Aryan-swag/VentSense/sim/out/summary.md

# VentSense digital twin: results

Generated by `sim/run_all.py`. The **real firmware safety core** (`firmware/lib/safety_core`) runs in the loop;
the plant, sensors and fault profiles are models with ASSUMED values (`sim/params.py`).
These results show the firmware logic and timing behave as designed against modelled faults.
They do not prove detection on real cells. Thresholds are placeholders to be tuned on the rig.

## Scenario checks: 35 / 35 passed

| Scenario | Check | Result | Detail |
|---|---|---|---|
| normal | no Level 2 trip | PASS | trips: {} |
| normal | no Level 3 trip | PASS |  |
| normal | stays at Level 0 | PASS | max level 0 |
| incense_room | no Level 2 trip | PASS | trips: {} |
| incense_room | no Level 3 trip | PASS |  |
| incense_room | ambient-gas alert raised | PASS | alerts [1] |
| cell3_runaway | cell 3 isolated (Level 2) | PASS | trips {2: 443.20001220703125} |
| cell3_runaway | only cell 3 isolated | PASS |  |
| cell3_runaway | no Level 3 | PASS |  |
| cell3_runaway | pack keeps powering the load on 3 cells | PASS | final current 1.15 A |
| cell3_runaway | isolation < 1 s after the 2nd signal | PASS | latency 0.60 s |
| two_cell | cells 2 and 3 isolated | PASS | trips {1: 442.3999938964844, 2: 471.70001220703125} |
| two_cell | Level 3: pack relay opened | PASS | L3 at [471.70001220703125] |
| two_cell | pack current 0 after Level 3 | PASS |  |
| sensor_unplug | no Level 2 trip | PASS | trips: {} |
| sensor_unplug | no Level 3 trip | PASS |  |
| sensor_unplug | sensor-fault alert raised | PASS |  |
| sensor_unplug | max Level 1 | PASS | max level 1 |
| heater_only | no Level 2 trip | PASS | trips: {} |
| heater_only | no Level 3 trip | PASS |  |
| heater_only | firmware heater cutoff at 55 C engaged | PASS |  |
| heater_only | dummy cell stays below 60 C (25R limit) | PASS | peak dummy 56.4 C |
| heater_only | KSD301 backup holds the block near 70 C | PASS | peak block 70.0 C, KSD301 opened 1 times (block runs hotter than the dummy: ASSUMED coupling) |
| rig_vote | dummy segment 1 trips Level 2 (H2 + temperature) | PASS | trips {0: 357.29998779296875} |
| rig_vote | real cells untouched | PASS |  |
| rig_vote | heater off after the trip | PASS |  |
| ir_health | no Level 2 trip | PASS | trips: {} |
| ir_health | no Level 3 trip | PASS |  |
| ir_health | commissioning test: every cell within 10 % of the model | PASS | worst error 2.0 % |
| ir_health | after ageing: every cell within 10 % of the model | PASS | worst error 1.1 % |
| ir_health | aged cell 2 measured about 1.8x its baseline | PASS | ratio 1.77 |
| ir_health | health indicator flags cell 2 only | PASS | scores 98, 61, 98, 97 |
| late_second | no Level 2 trip | PASS | trips: {} |
| late_second | no Level 3 trip | PASS |  |
| late_second | reached Level 1 only | PASS | max level 1 |

Plots: `out/<scenario>.png`.

## Monte Carlo (40 runs each, random sensor offsets, baselines, noise, cell spread)

| Metric | Result |
|---|---|
| Normal operation: runs with a false Level 2 trip | 0 / 40 |
| Normal operation: runs with any Level 1 alert | 0 / 40 |
| Failing cell (random cell, ramp 120-600 s, severity 0.7-1.3): detected and isolated | 40 / 40 |
| Wrong cell isolated | 0 / 40 |
| Detection time from fault onset: median / 95th percentile | 167 s / 264 s |
| Isolation latency after the 2nd signal: max | 0.60 s (target < 1 s) |

Detection time depends entirely on the ASSUMED fault profile; quote it only as a model result.

Run time: 89 s.
