Aryan-swag/VentSense/exports/screenshots/Screenshot from 2026-10-25 03-03-59.png

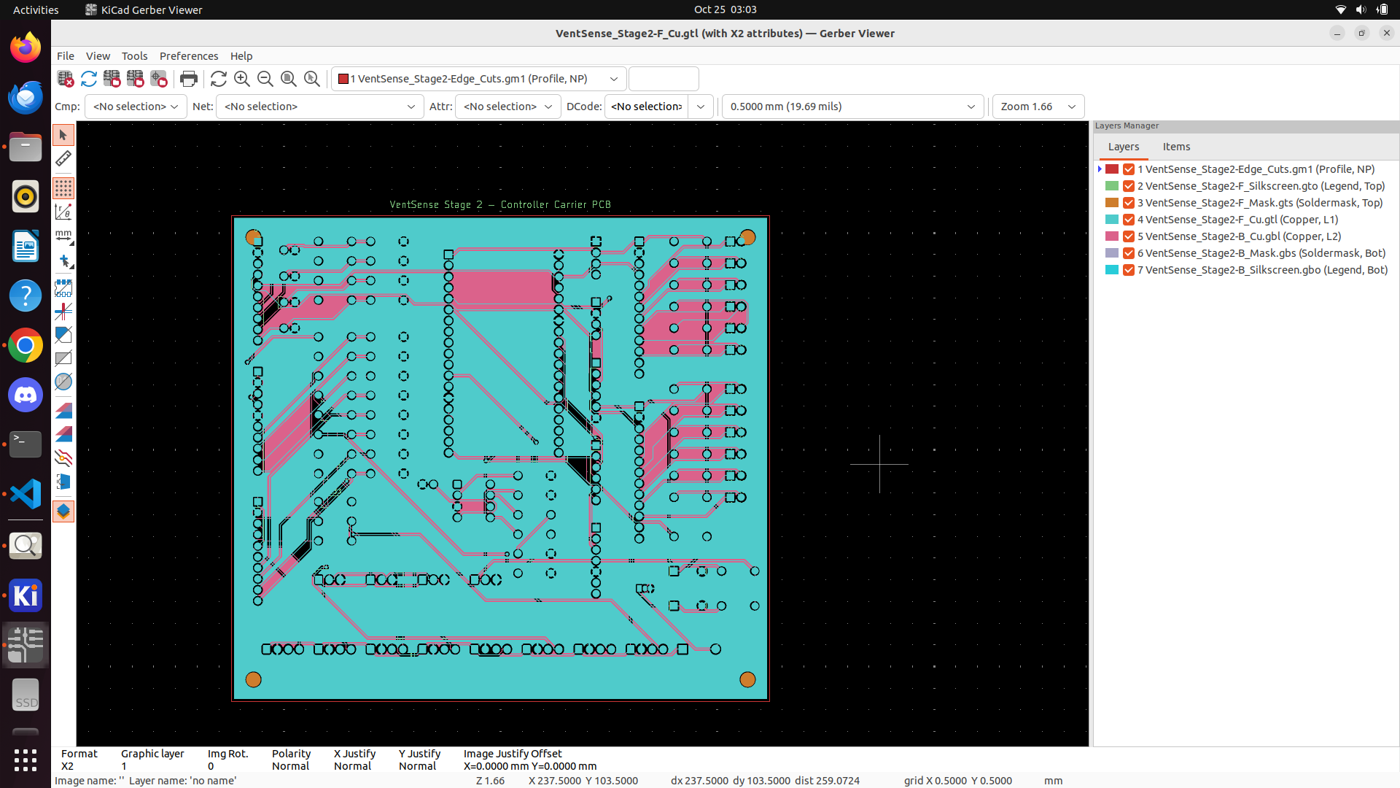
exports/screenshots/Screenshot from 2026-10-25 03-03-59.png
