Aryan-swag/VentSense/exports/screenshots/Screenshot from 2026-10-25 10-33-32.png

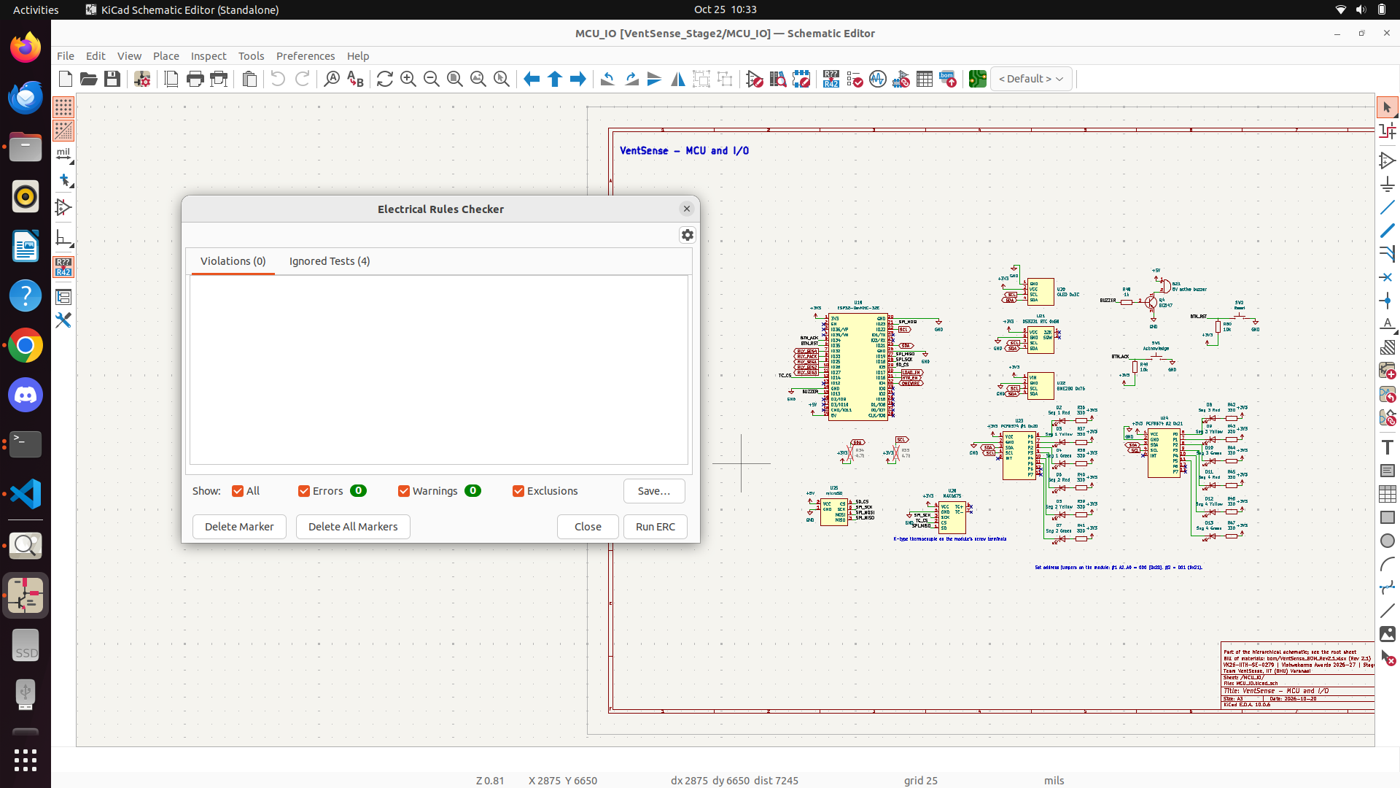
exports/screenshots/Screenshot from 2026-10-25 10-33-32.png
