Aryan-swag/VentSense/exports/screenshots/Screenshot from 2026-10-25 11-01-54.png

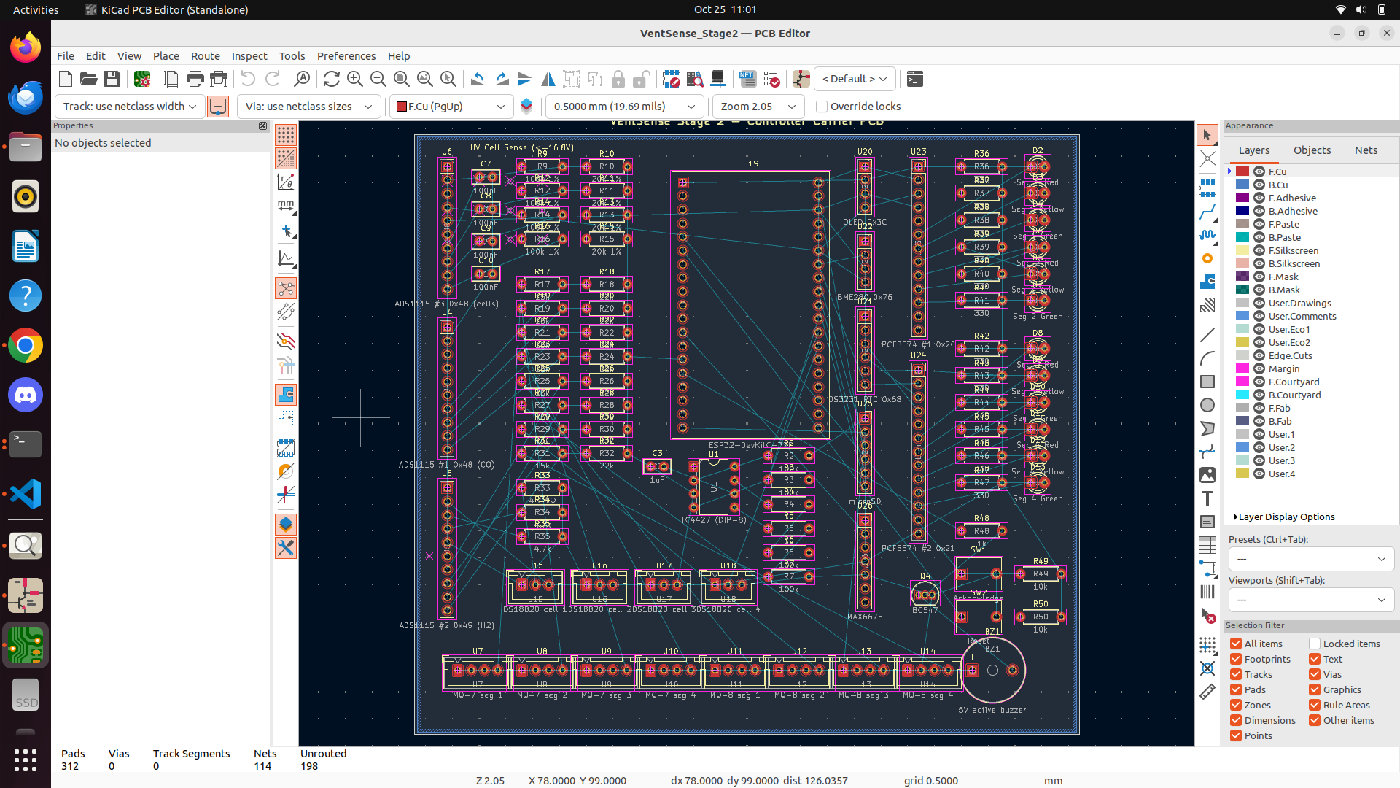
exports/screenshots/Screenshot from 2026-10-25 11-01-54.png
