Aryan-swag/VentSense/exports/screenshots/Screenshot from 2026-10-25 11-02-47.png

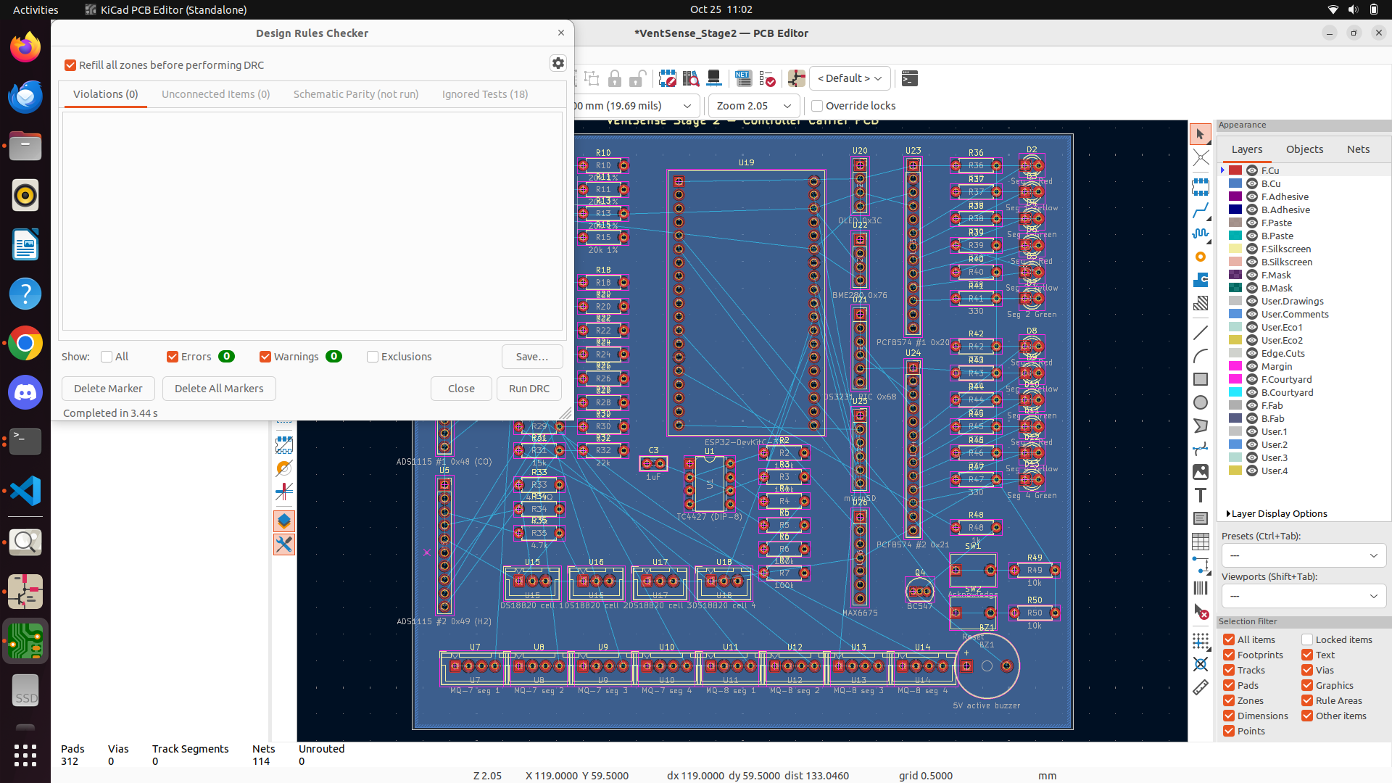
exports/screenshots/Screenshot from 2026-10-25 11-02-47.png
