Aryan-swag/VentSense/exports/screenshots/Screenshot from 2026-10-25 11-05-31.png

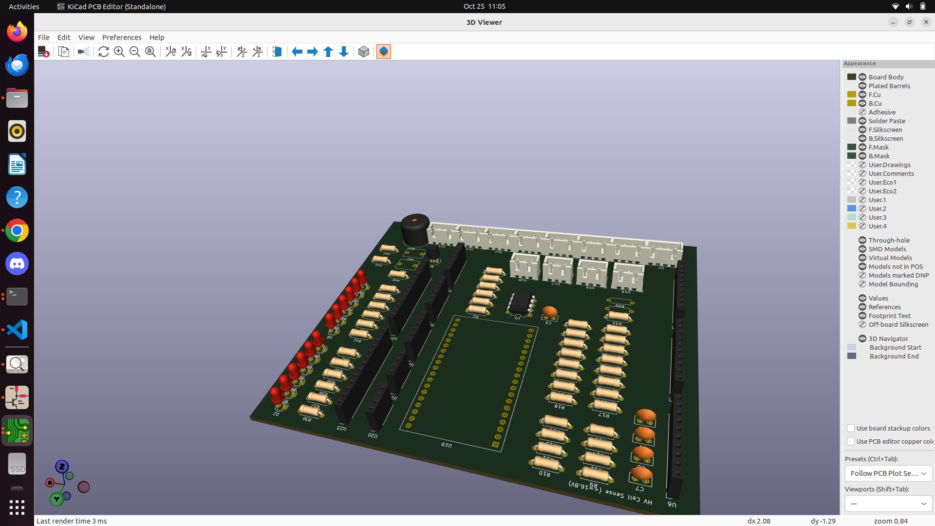
exports/screenshots/Screenshot from 2026-10-25 11-05-31.png
