Aryan-swag/VentSense/exports/VS_sheet-1.png

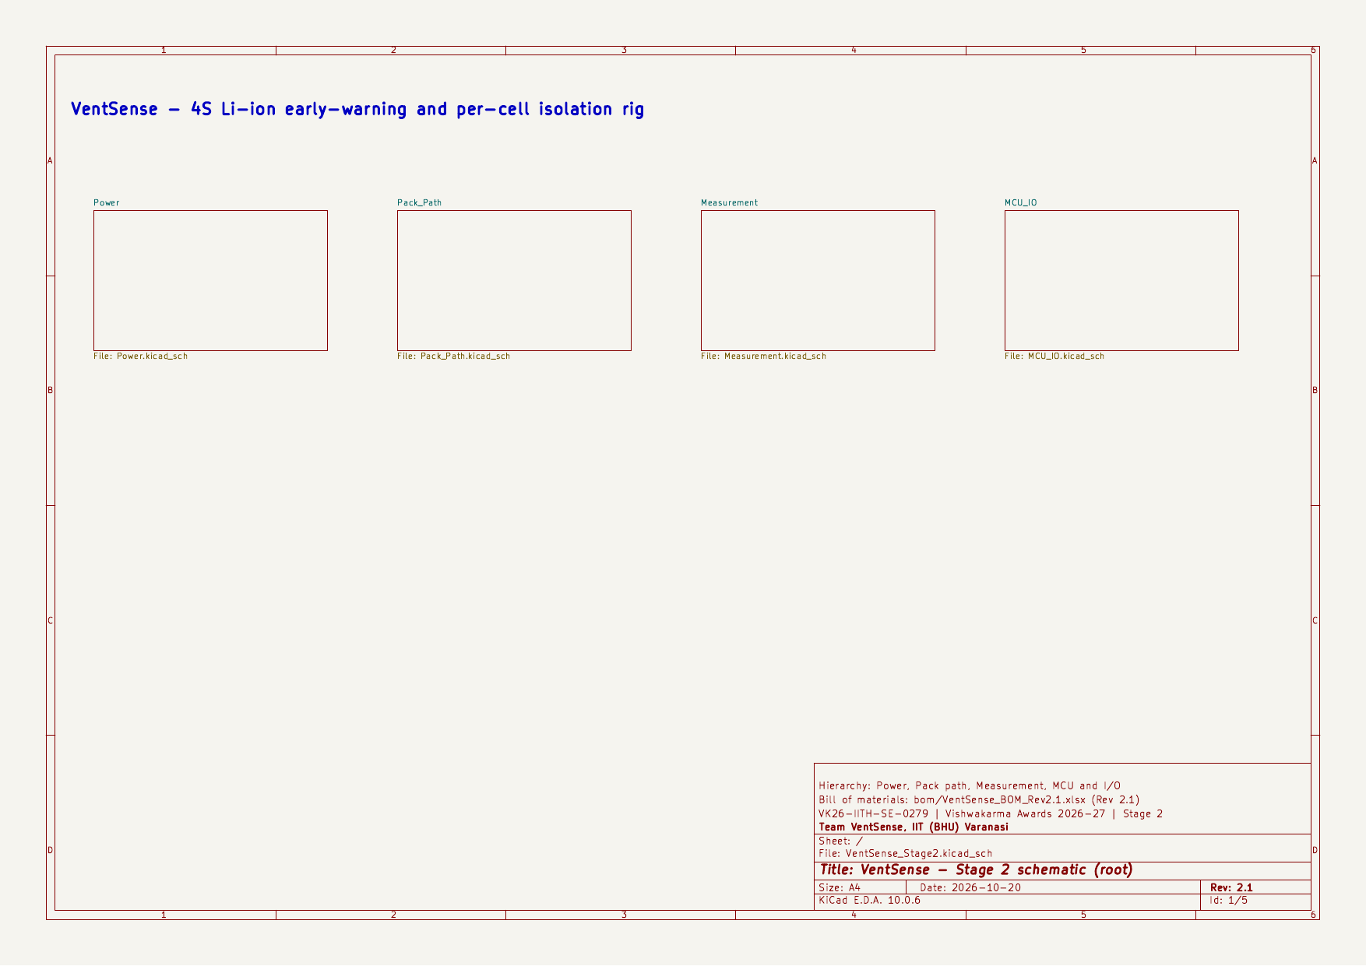
exports/VS_sheet-1.png
