Aryan-swag/VentSense/exports/VS_sheet-2.png

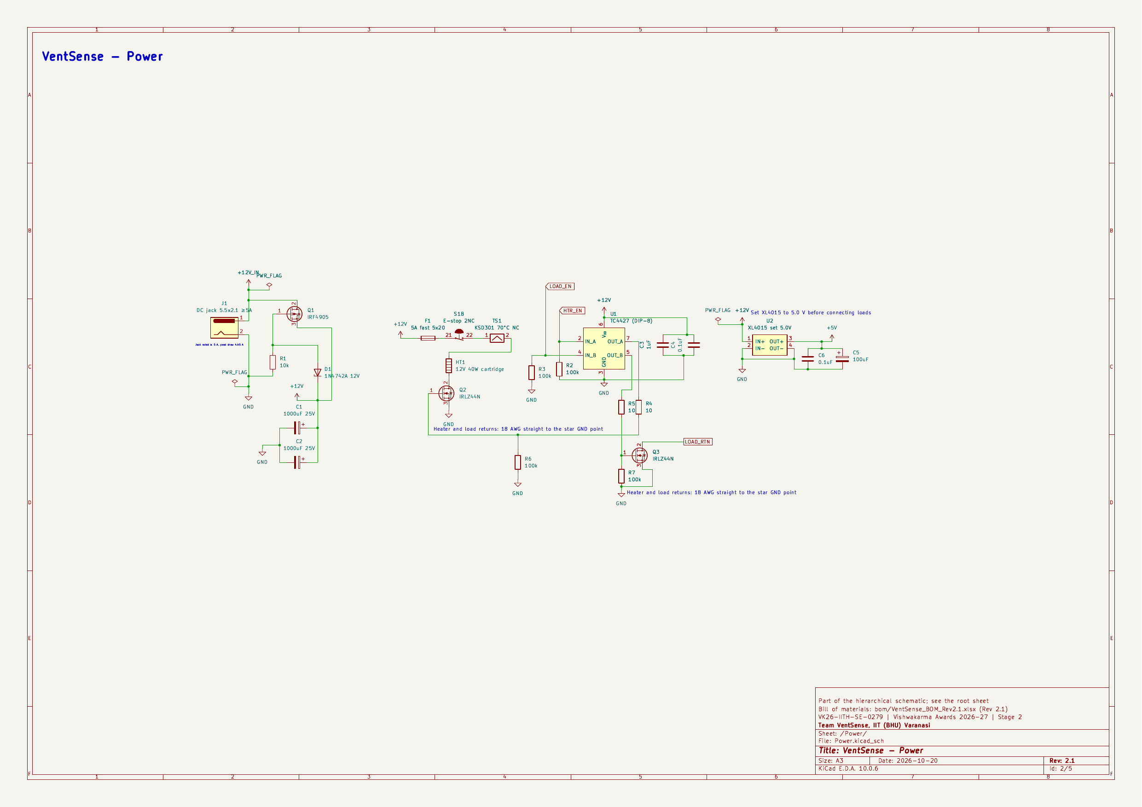
exports/VS_sheet-2.png
