Aryan-swag/VentSense/exports/VS_sheet-3.png

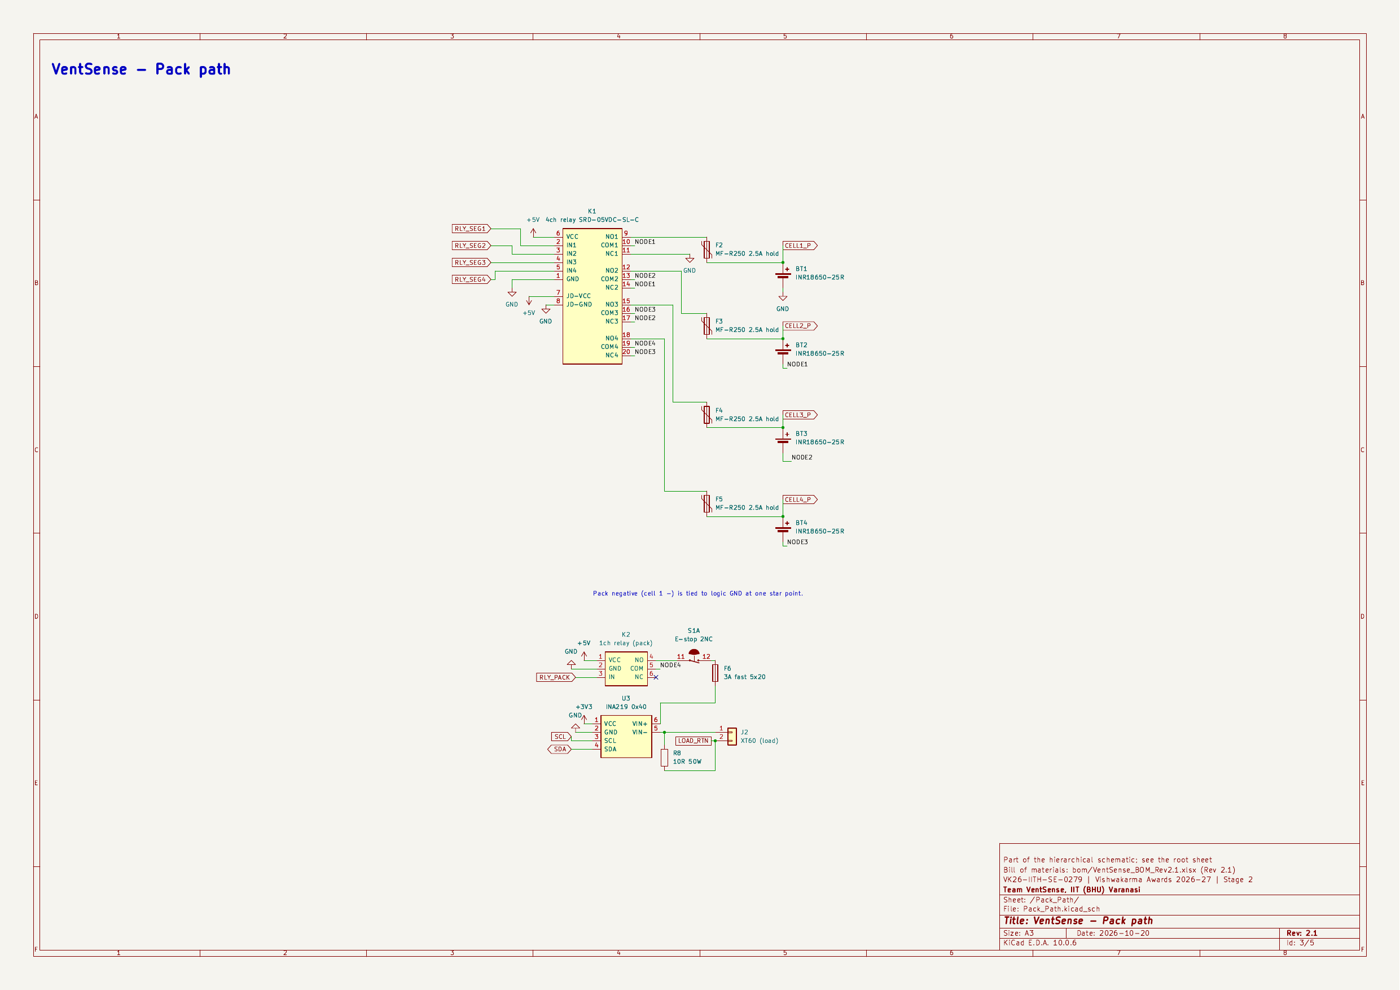
exports/VS_sheet-3.png
