Aryan-swag/VentSense/exports/VS_sheet-4.png

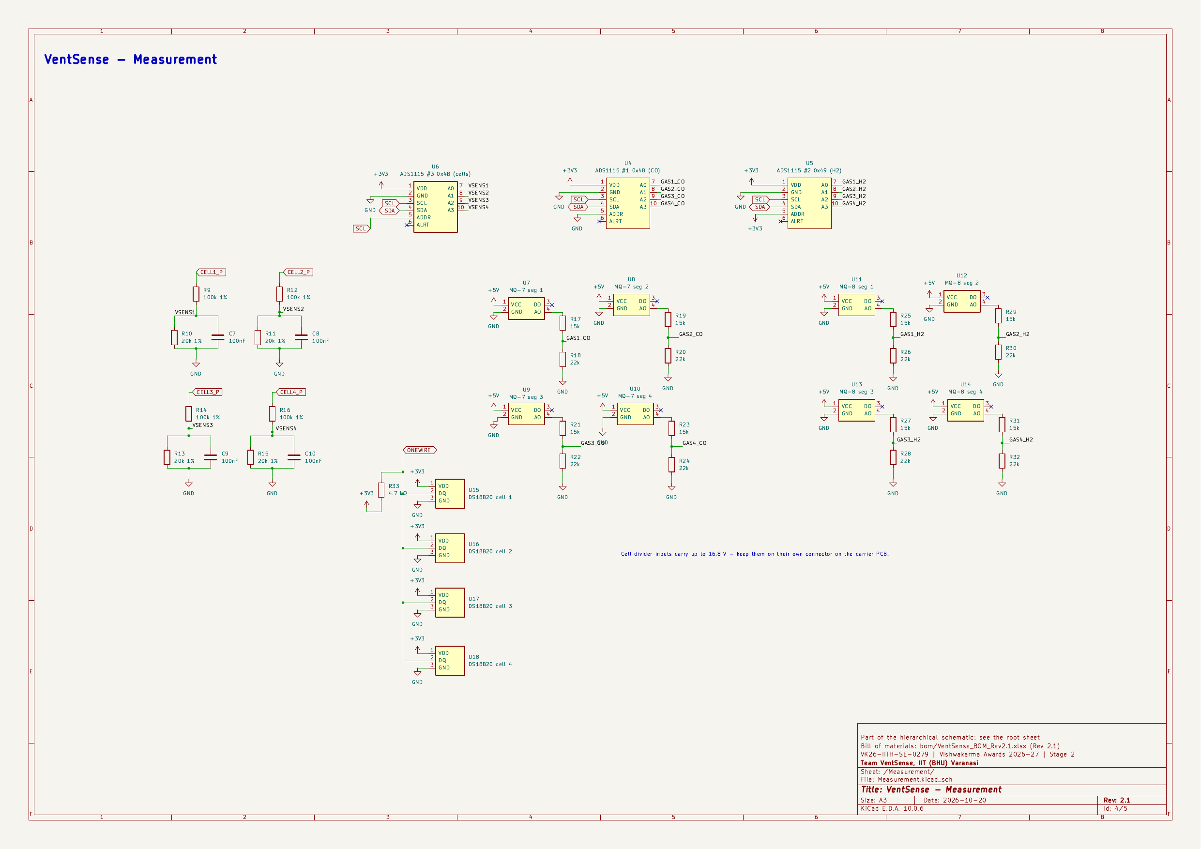
exports/VS_sheet-4.png
