Aryan-swag/VentSense/exports/VS_sheet-5.png

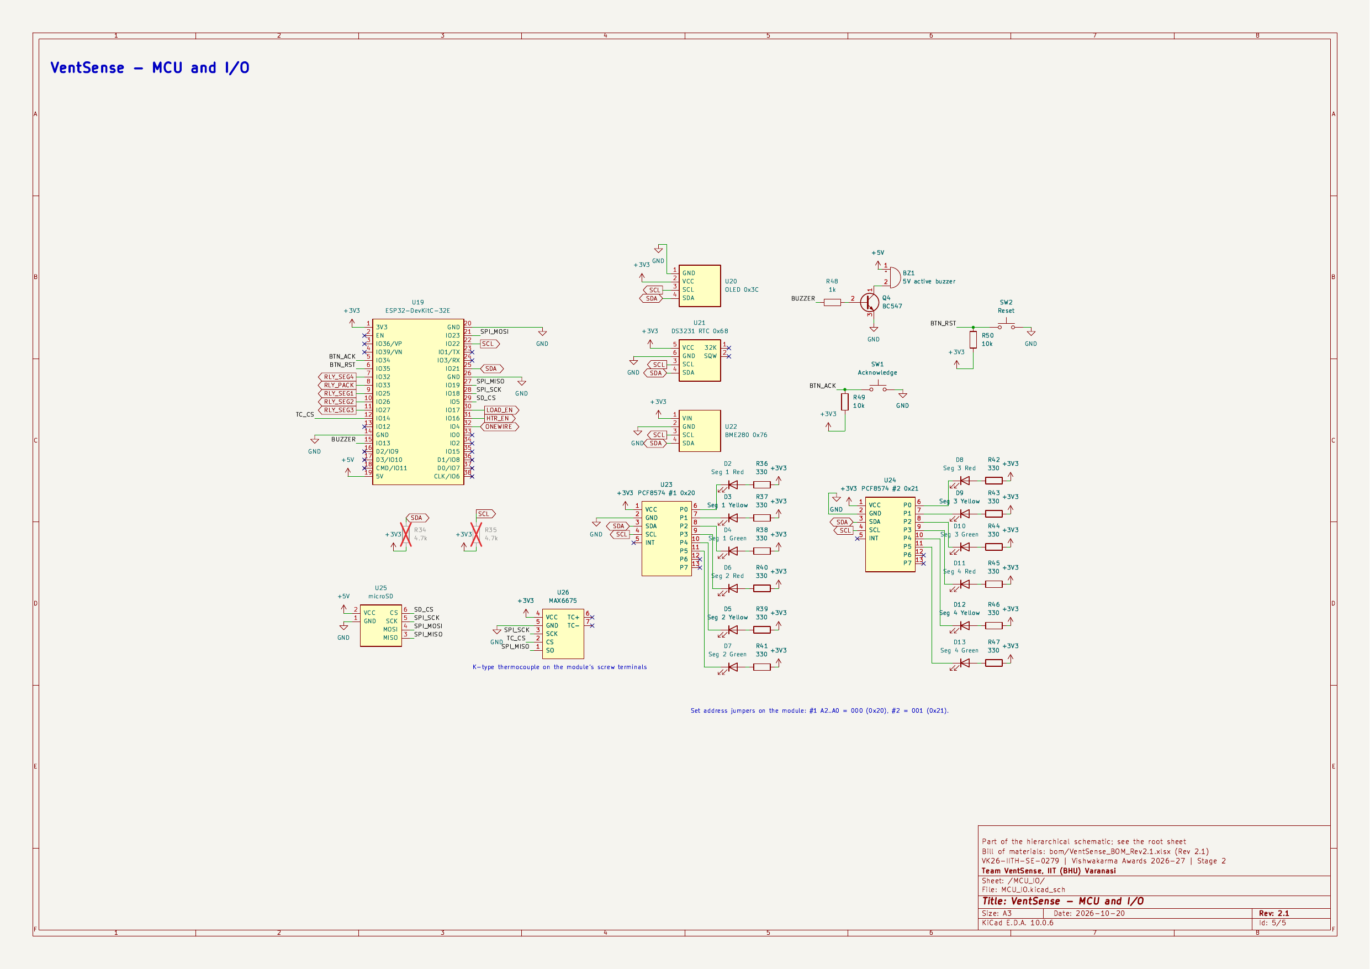
exports/VS_sheet-5.png
