Aryan-swag/VentSense/PCB/renders/VS_Carrier_v1.1_bottom.png

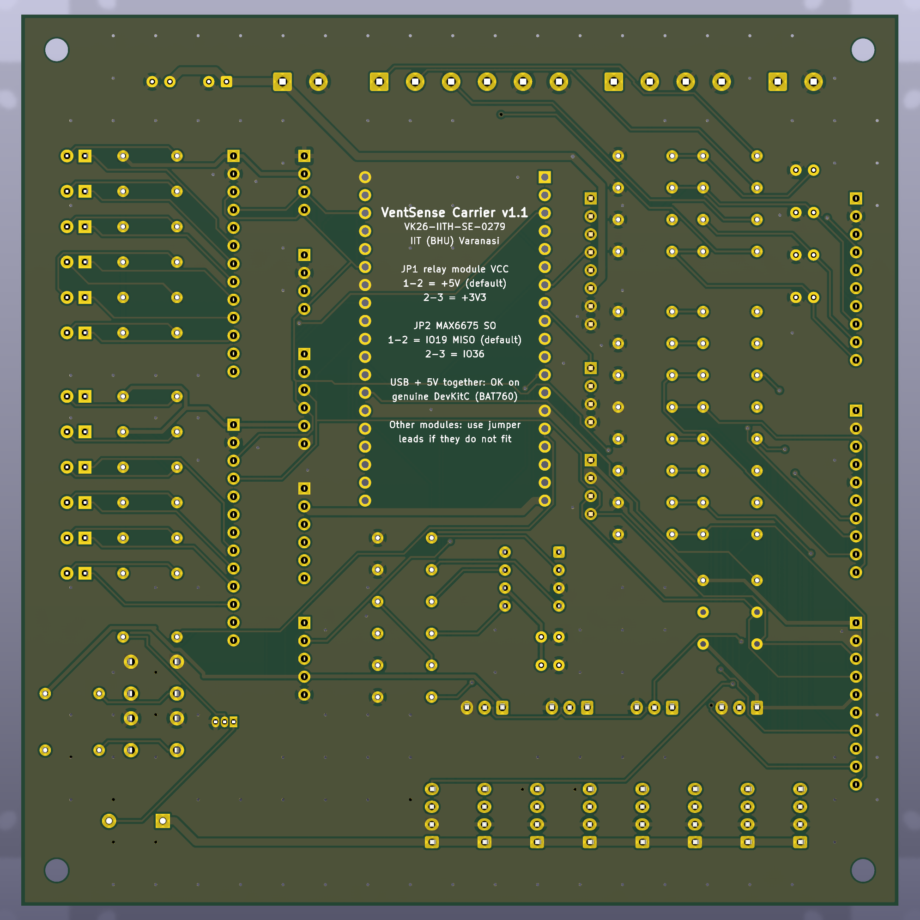
PCB/renders/VS_Carrier_v1.1_bottom.png
