Aryan-swag/VentSense/sim/out/dashboard_health.png

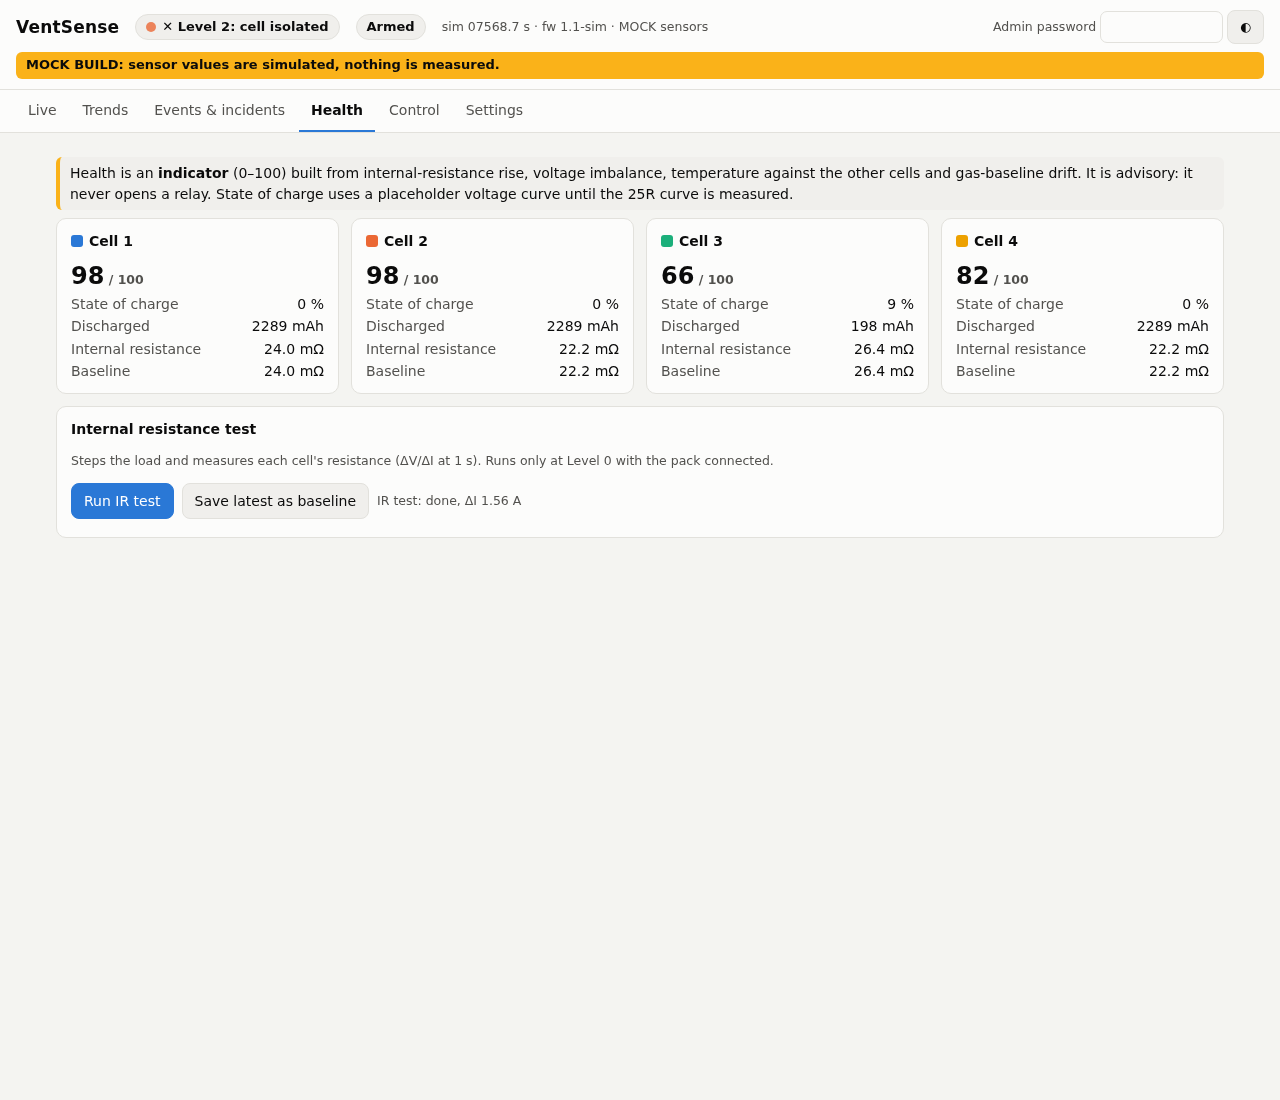
sim/out/dashboard_health.png
