Aryan-swag/VentSense/sim/out/dashboard_live.png

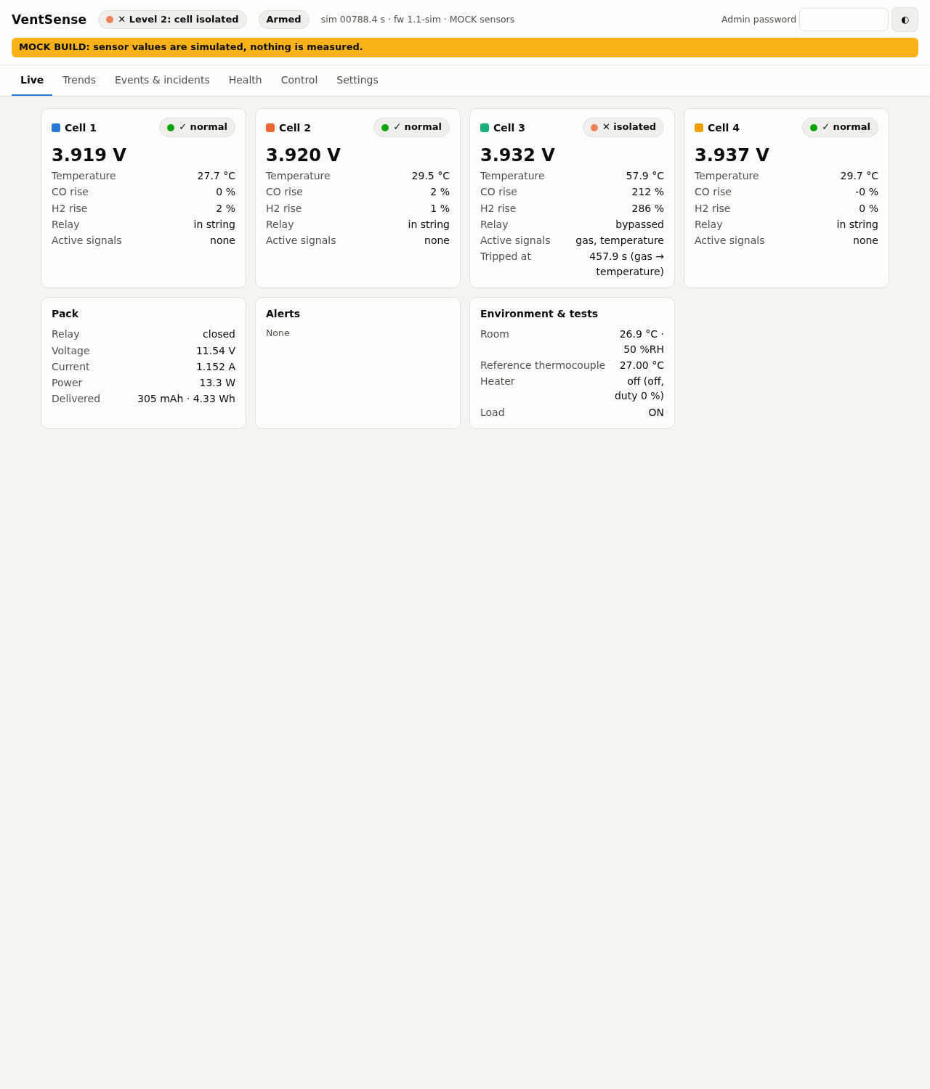
sim/out/dashboard_live.png
