Aryan-swag/VentSense/sim/out/dashboard_trends.png

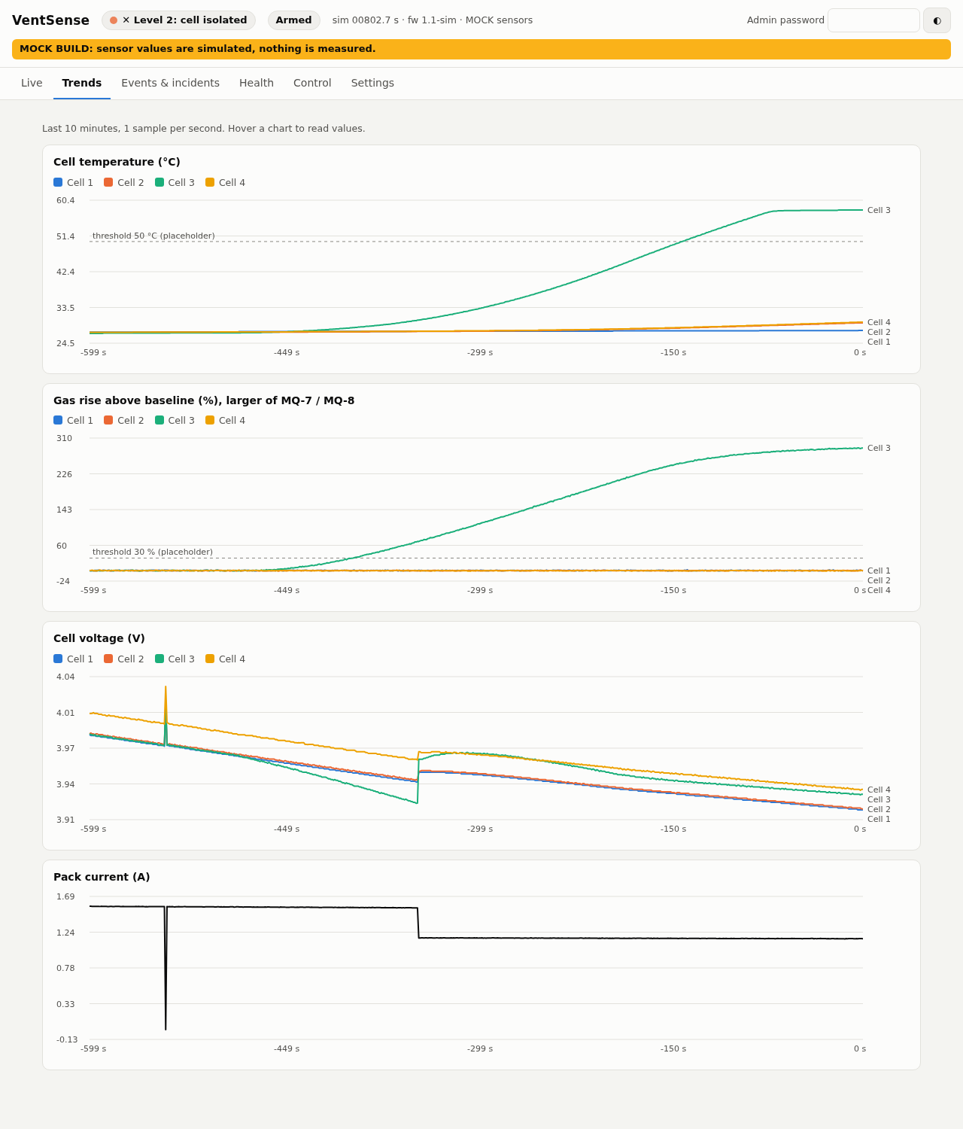
sim/out/dashboard_trends.png
