Aryan-swag/VentSense/sim/out/heater_only.png

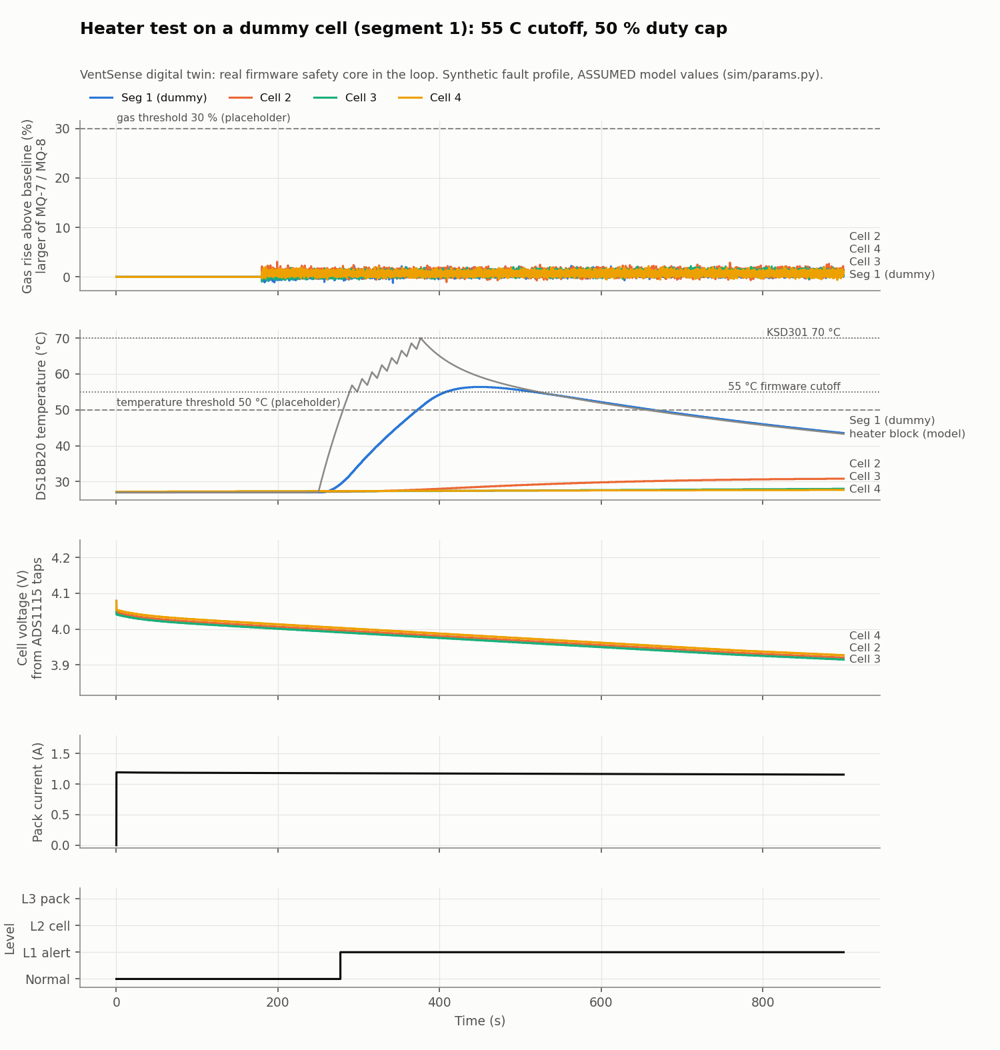
sim/out/heater_only.png
