Aryan-swag/VentSense/sim/out/incense_room.png

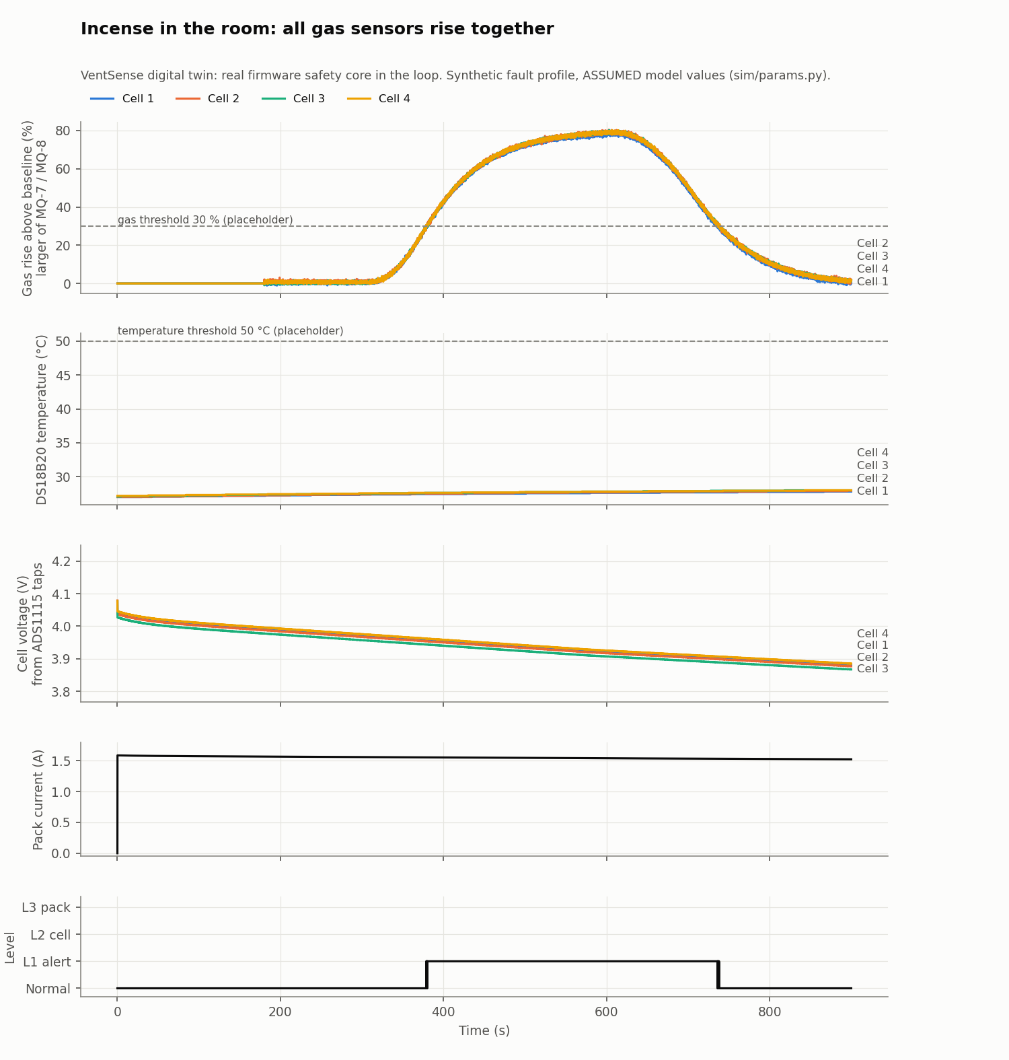
sim/out/incense_room.png
