Aryan-swag/VentSense/sim/out/ir_health.png

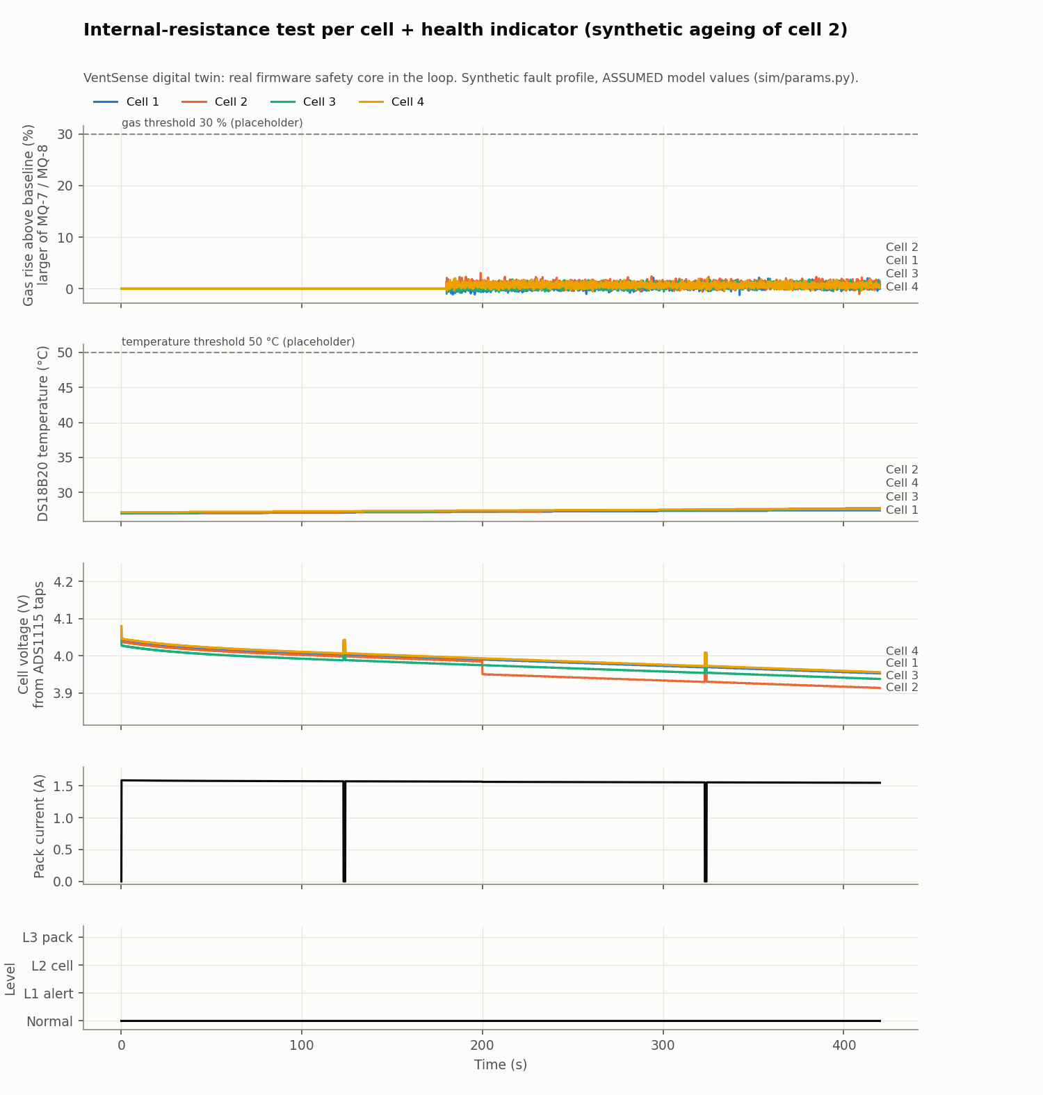
sim/out/ir_health.png
