Aryan-swag/VentSense/sim/out/ir_health_bars.png

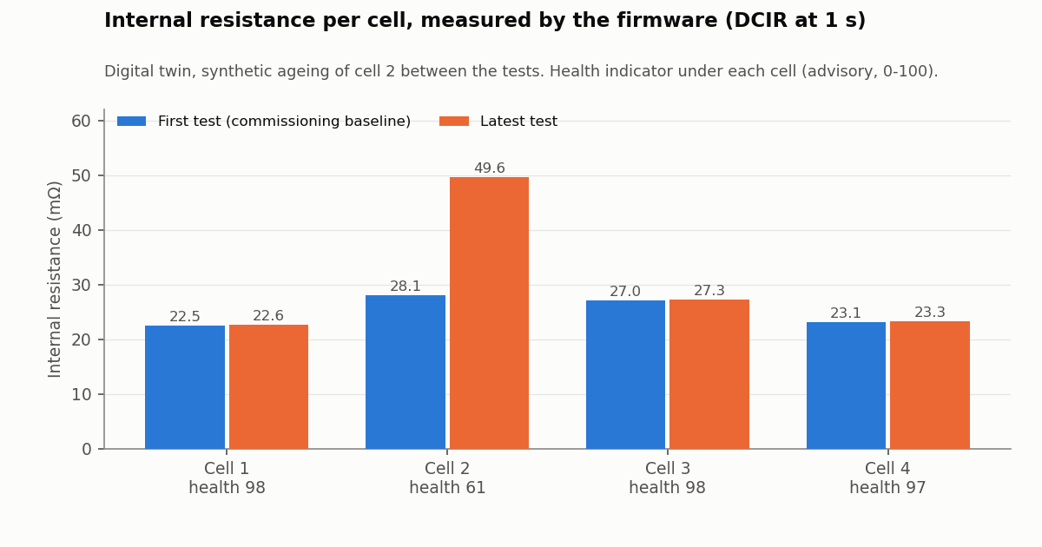
sim/out/ir_health_bars.png
