Aryan-swag/VentSense/sim/out/late_second.png

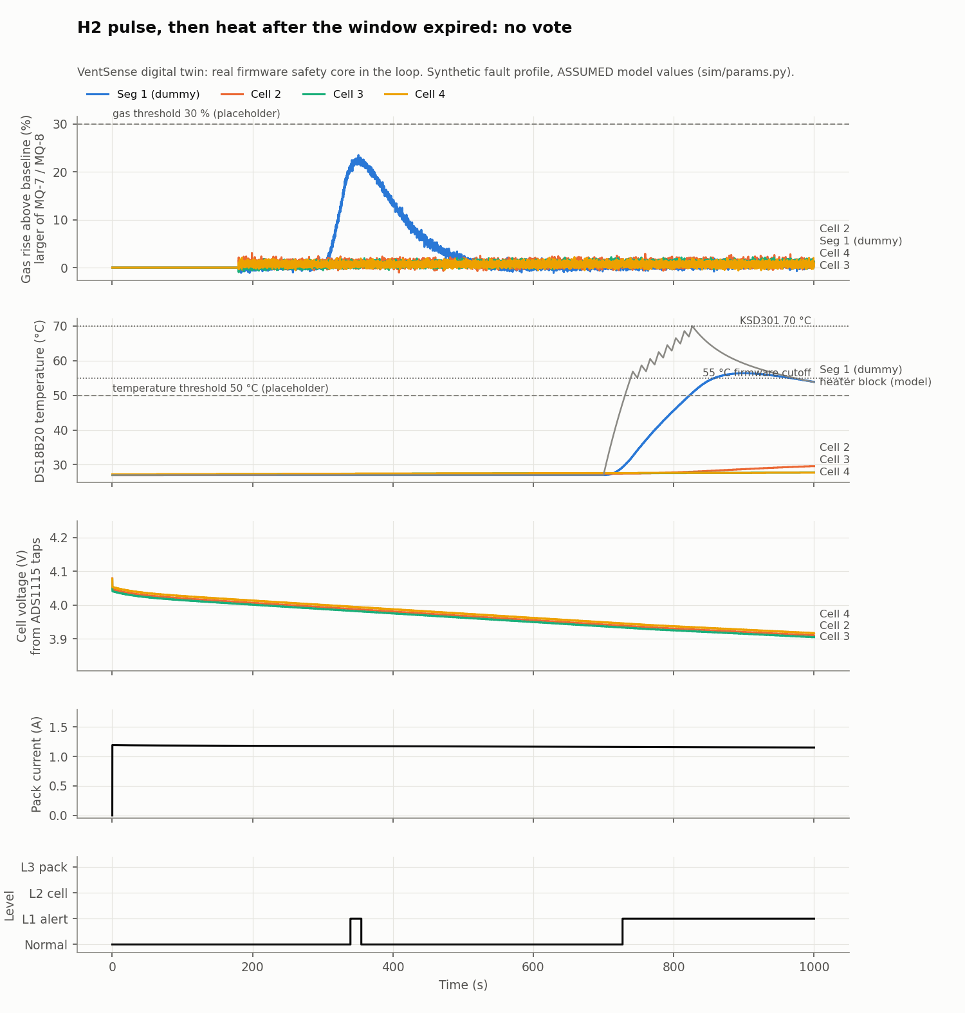
sim/out/late_second.png
