Aryan-swag/VentSense/sim/out/normal.png

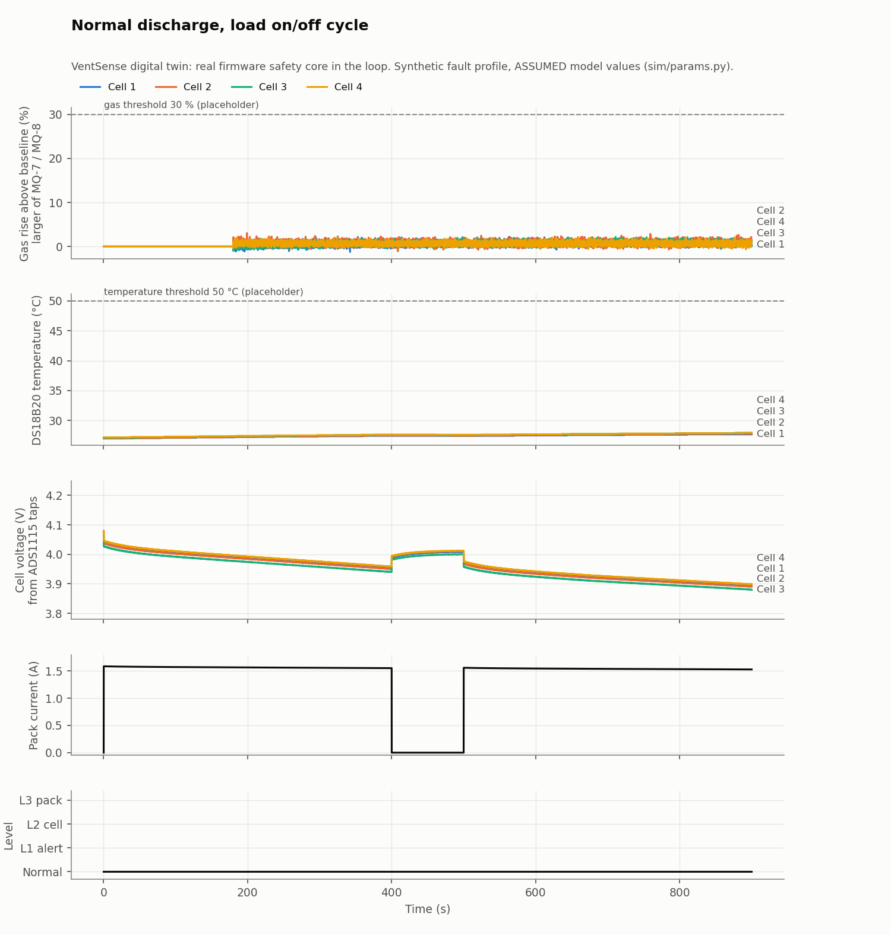
sim/out/normal.png
