Aryan-swag/VentSense/sim/out/rig_vote.png

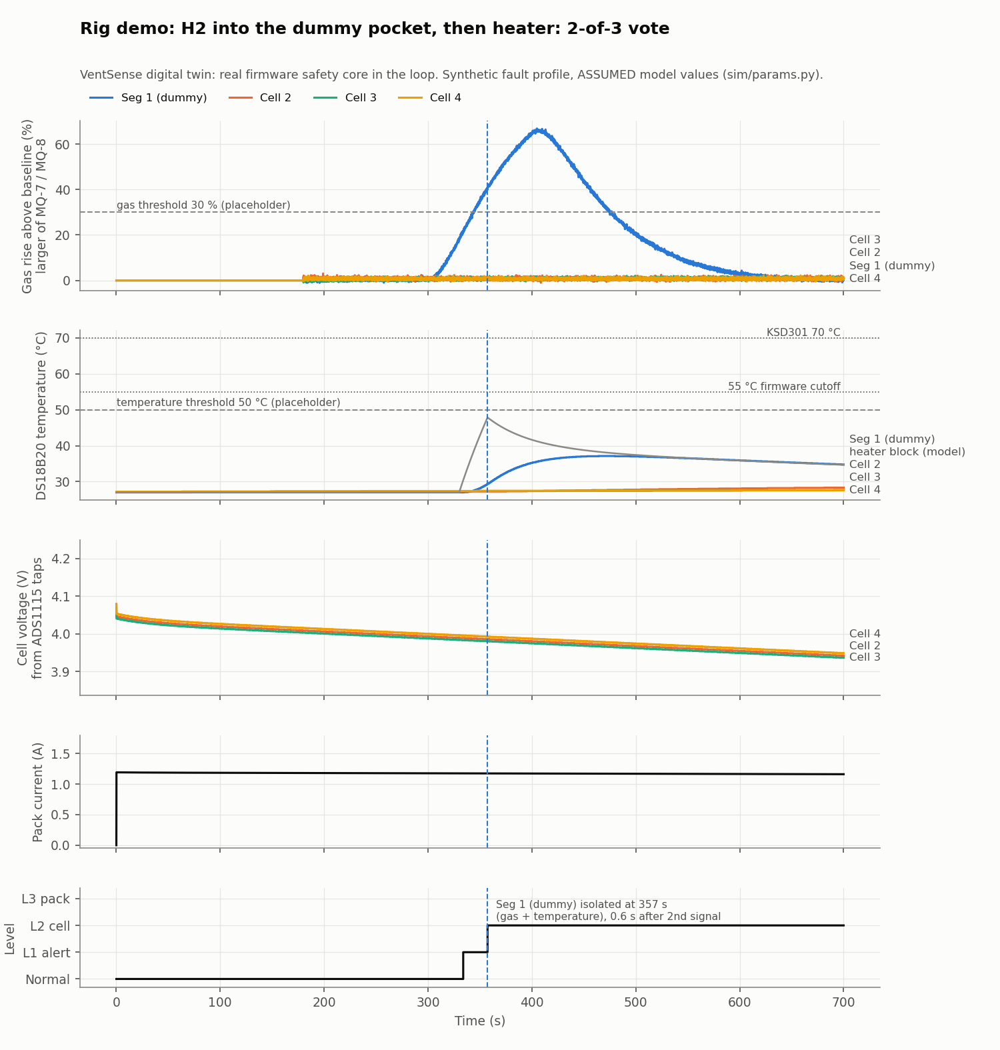
sim/out/rig_vote.png
