Aryan-swag/VentSense/sim/out/sensor_unplug.png

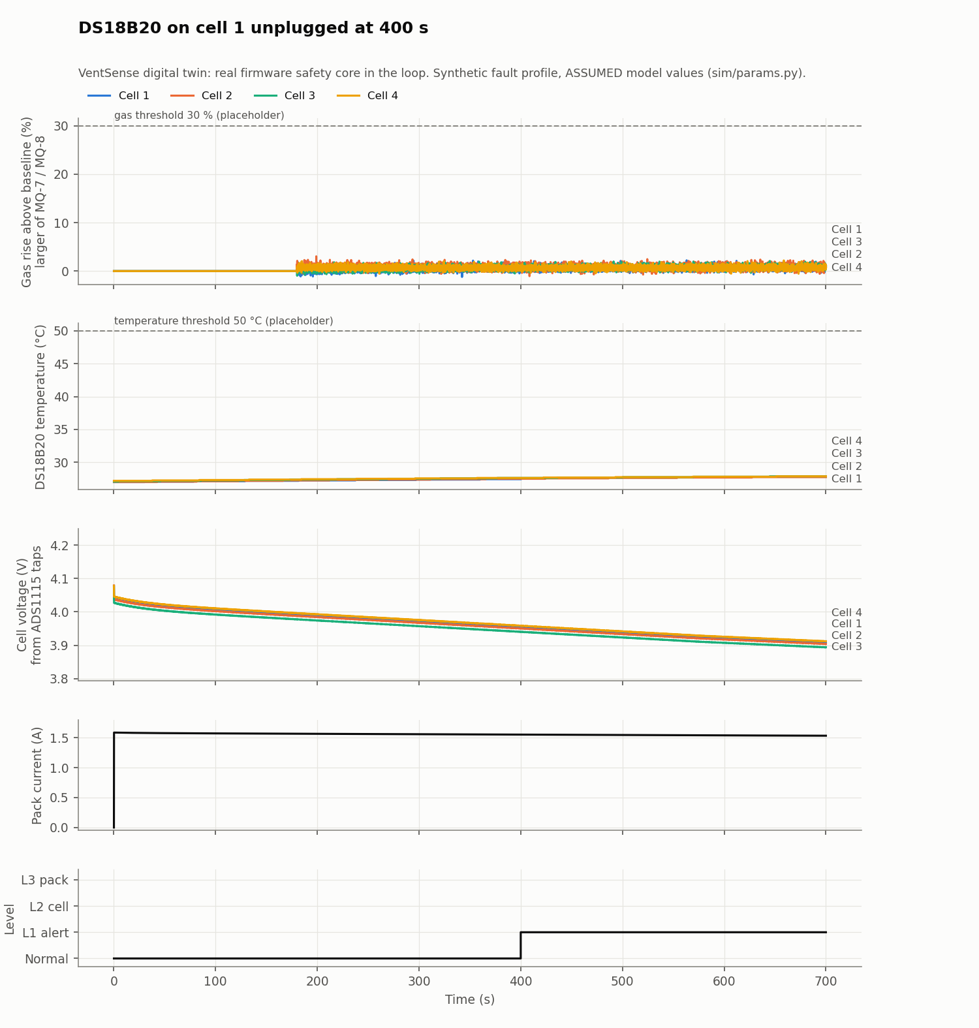
sim/out/sensor_unplug.png
