Aryan-swag/VentSense/sim/out/two_cell.png

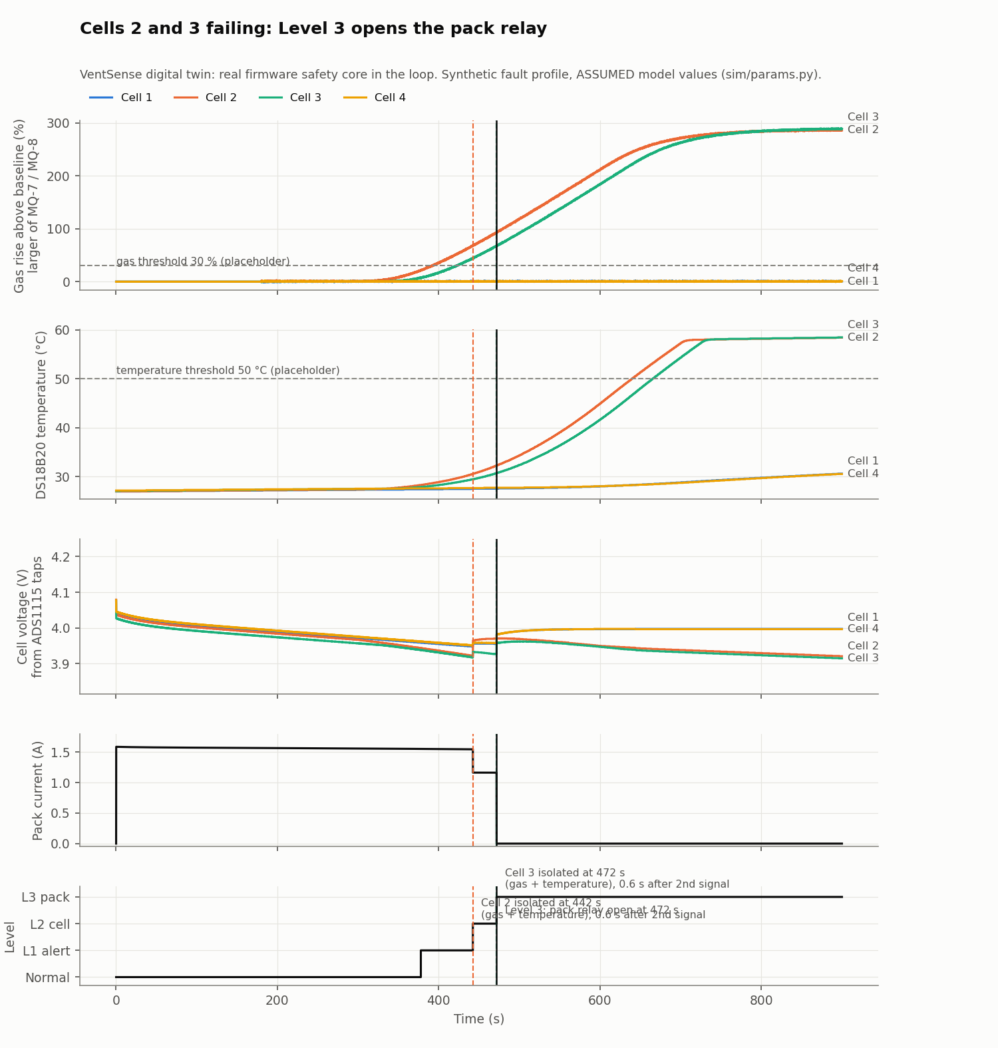
sim/out/two_cell.png
