Aryan-swag/VentSense/ventsense_cad/Screenshot (224).png

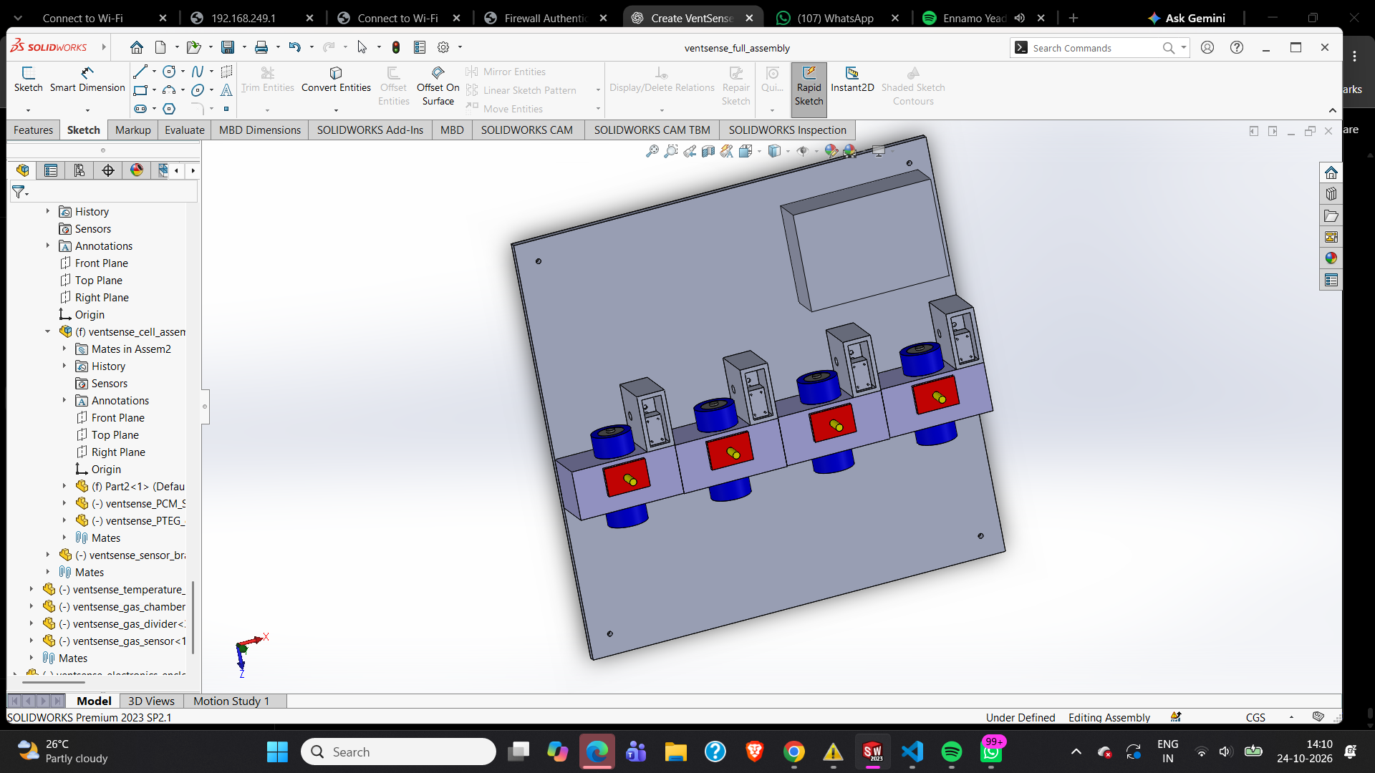
ventsense_cad/Screenshot (224).png
