Aryan-swag/VentSense/ventsense_cad/ventsense_isometric_view.png

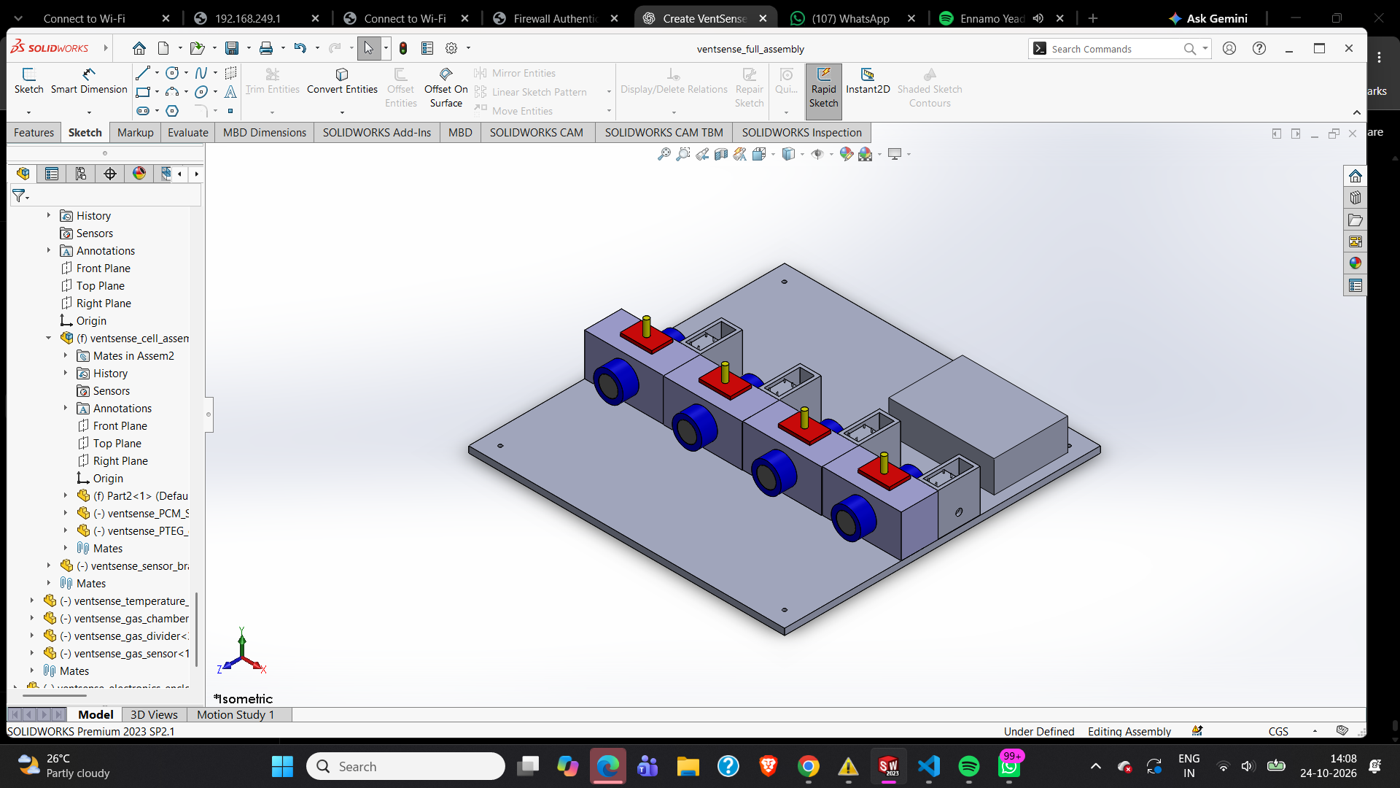
ventsense_cad/ventsense_isometric_view.png
