Aryan-swag/VentSense/bom/VentSense_BOM_Rev2.1_Final.xlsx

Sheet: Core BOM
Component | Part / Specification | Qty | Lead Time | Cost (INR)
CO sensor module | MQ-7 module, Winsen/Hanwei element, LM393 + analog out (AO), 5V. One per segment | 4 | Local (Online) | 760
H2 sensor module | MQ-8 module, Winsen/Hanwei element, LM393 + analog out (AO), 5V. One per segment | 4 | Local (Online) | 800
Cell temperature sensor | DS18B20 waterproof stainless probe, 1 m lead, one per cell (taped to cell wall) | 4 | Local (Online) | 480
Current sensor | INA219 I2C module, 0.1 ohm shunt, up to 3.2 A, for load vs. fault sag check | 1 | Local (Online) | 250
ADC | ADS1115 16-bit I2C module (3 used: 8 gas channels + 4 cell-voltage channels, run at 3.3 V). ADDR to GND / VDD / SCL = 0x48 / 0x49 / 0x4B | 3 | Local (Online) | 1050
Ambient reference sensor | Bosch BME280 I2C module (humidity / temp / pressure) for gas-sensor humidity check. Check chip marking, many are BMP280 | 1 | Local (Online) | 480
Real-time clock | DS3231 I2C module with CR2032 backup, for timestamped event log | 1 | Local (Online) | 220
RTC backup cell | CR2032 3 V coin cell for the DS3231 (modules often ship without it) | 1 | Local (Online) | 30
Microcontroller | Espressif ESP32-DevKitC-32E (ESP32-WROOM-32E), genuine Espressif board | 1 | Local (Online) | 850
ESP32 breakout | 30/38-pin screw terminal expansion board for the DevKit, so wiring does not rely on jumper wires | 1 | Local (Online) | 250
Local display | 0.96 inch SSD1306 OLED, I2C, shows state of each segment on the rig | 1 | Local (Online) | 250
LED driver | PCF8574 I2C I/O expander module (0x20, 0x21), drives the 12 status LEDs; ESP32 has no free pins left. Check the chip is PCF8574, not PCF8574A (0x38-0x3F) | 2 | Local (Online) | 150
Log storage | microSD SPI card module + SanDisk Ultra 32 GB microSD (baseline / degradation log). Power from 5 V; check MISO is released when CS is high (shared SPI with MAX6675) | 1 | Local (Online) | 550
Segment isolation relays | 4-channel 5V opto-isolated relay module, Songle SRD-05VDC-SL-C SPDT, 10 A contacts. Remove JD-VCC jumper; VCC and JD-VCC both from +5V | 1 | Local (Online) | 280
Pack disconnect relay | 1-channel 5V opto-isolated relay module, SPDT, for Level 3 full-pack shutdown. Wire through NO (energised = pack connected) | 1 | Local (Online) | 120
Emergency stop | 22 mm mushroom push-button, latching, with 2 NC contact blocks: NC1 in series with pack output, NC2 in the 12 V heater line | 1 | Local (Online) | 350
Fuse holders | 5x20 mm inline fuse holder (pack output and 12 V heater line) | 2 | Local (Online) | 80
Fuses | 5x20 mm fast-blow glass fuses, 5 A and 3 A, Littelfuse or equivalent (pack of 10, mixed). 3 A on pack output (INA219 reads up to 3.2 A), 5 A on 12 V heater line | 1 | Local (Online) | 150
Resettable fuses | PTC polyfuse, Bourns MF-R250 or equivalent (2.5 A hold / 5 A trip at 23 C, 30 V), one per segment, mounted off the cell carriers | 4 | Local (Online) | 120
Li-ion cells | Samsung INR18650-25R 2500 mAh, genuine Samsung SDI, flat top, unprotected. From a vendor that tests cells, same lot for all four | 4 | Local (Online) | 2352
Cell holders | Single 18650 holder, metal spring contacts, with 15 cm leads | 4 | Local (Online) | 160
Cell charger | Liitokala Lii-500 (or Lii-600), 4 independent bays, charges cells outside the rig | 1 | Local (Online) | 1700
Load resistor | 10 ohm 50 W aluminium-housed wirewound resistor (about 1.5 A at 14.8 V), with heatsink bracket | 1 | Local (Offline) | 180
Load resistor heatsink | Finned aluminium heatsink, about 100 x 60 mm, with M3 screws (resistor dissipates about 22 W) | 1 | Local (Online) | 200
Load / heater switch | IRLZ44N logic-level N-MOSFET, Infineon, TO-220 (one for heater, one for load switch) | 2 | Local (Online) | 90
MOSFET heatsink | TO-220 clip-on heatsink | 2 | Local (Online) | 30
MOSFET gate driver | TC4427 dual low-side driver, DIP-8, powered from 12 V; drives both IRLZ44N gates fully (3.3 V from the ESP32 is not enough at 3.3 A) | 1 | Local (Online) | 60
IC socket | 8-pin DIP socket for the TC4427 | 1 | Local (Online) | 10
Heater cartridge | 12 V 40 W cartridge heater, 6x20 mm, for the thermal channel test | 1 | Local (Online) | 150
Heater block | Aluminium block about 25x25x20 mm, drilled for 6 mm cartridge | 1 | Local (Workshop) | 150
Heater thermal cutoff | KSD301 70 C normally-closed thermal cutoff, 10 A, fitted on heater block. Firmware also cuts the heater at 55 C on the cell probe | 1 | Local (Online) | 60
Gas test source | Incense sticks + butane lighter (ventilated combustion-byproduct test) | 1 | Local (Offline) | 100
Hydrogen test source | Small water-electrolysis kit: 9 V battery + snap, stainless-steel bolt electrodes, small container, baking soda (incense gives CO but no H2, needed to test MQ-8) | 1 | Local (Offline) | 150
Silicone tubing | 4 mm inner diameter, 1 m, routes H2 from the electrolysis kit into the test box | 1 | Local (Online) | 50
Gas test box | 3 mm clear acrylic sheet, about 200 x 200 mm, cut into a small sealed box over one segment for repeatable gas tests | 1 | Local (Offline) | 200
Acrylic cement | Solvent cement for joining the test box | 1 | Local (Offline) | 100
Reference thermocouple | K-type thermocouple + MAX6675 SPI module, independent check on DS18B20 readings during heater tests | 1 | Local (Online) | 250
Main DC supply | 12 V 5 A BIS-certified DC adapter (Mean Well GST60A12 or equivalent), powers heater and 5 V buck | 1 | Local (Online) | 1500
5 V buck converter | XL4015 5 A adjustable DC-DC module (replaces LM2596), set to 5.0 V before connecting anything. Feeds relays, gas sensors and ESP32 VIN (about 2.3 A peak) | 1 | Local (Online) | 250
Bulk capacitors | 1000 uF 25 V Panasonic/Nichicon x2, plus 100 uF, 1 uF and 0.1 uF ceramic assortment (gas sensor heater inrush, Wi-Fi bursts, 1 uF at TC4427 VDD) | 1 | Local (Online) | 250
Reverse-polarity protection | IRF4905 P-channel MOSFET, TO-220, on the 12 V input | 1 | Local (Online) | 60
Gate-clamp Zener | 12 V Zener diode, 1N4742A or BZX55C12, for the IRF4905 gate | 2 | Local (Online) | 10
DC input jack | Panel-mount DC barrel jack, 5.5 x 2.1 mm, rated 5 A or more, matches the 12 V adapter plug. Do not use DC-022B (commonly sold as 3 A); peak draw is about 4.45 A | 1 | Local (Online) | 50
Alarm buzzer | 5 V active buzzer, 85 dB | 1 | Local (Online) | 30
Buzzer driver | BC547 NPN transistors, pack of 10 (buzzer driver; ESP32 pin cannot drive the 5 V buzzer directly) | 1 | Local (Online) | 20
Status LEDs | 5 mm LED assortment (red / yellow / green), 3 per segment. Green must be low-Vf (2.2 V or less, GaP yellow-green): the LEDs run from 3.3 V through 330 ohm | 1 | Local (Online) | 80
Push buttons | 12 mm panel push button, momentary (alarm acknowledge, reset) | 2 | Local (Online) | 60
Resistor kit | 1% metal film 1/4 W E24 assortment (dividers for cell voltage and gas AO scaling, pull-ups, LED resistors) | 1 | Local (Online) | 350
Perfboard | Double-sided plated FR4 perfboard, 18x12 cm | 2 | Local (Online) | 320
Breadboard | 830-point breadboard, for bench bring-up before soldering | 1 | Local (Online) | 150
Headers | 2.54 mm male + female header strips, 40-pin, assorted | 1 | Local (Online) | 150
Connectors | JST-XH 2.54 mm connector kit (2/3/4/5-pin) with crimped leads. Signals only (3 A rated): heater, pack and load wiring goes on screw terminals | 1 | Local (Online) | 350
Terminal blocks | 5 mm pitch 2-pin PCB screw terminal blocks, 15 A | 20 | Local (Online) | 120
Lever connectors | Wago 221-413 3-way | 5 | Local (Online) | 350
Pack connectors | XT60 male + female pair (load lead and charger lead) | 2 | Local (Online) | 120
Power wire | 18 AWG silicone wire, red and black, 5 m each | 2 | Local (Online) | 350
Signal wire | 24 AWG multi-colour hook-up wire, 6 colours x 5 m | 1 | Local (Online) | 300
Jumper wires | Dupont M-M / M-F / F-F, 40 each | 1 | Local (Online) | 200
Heat shrink | Assorted heat shrink tubing kit | 1 | Local (Online) | 150
Mounting hardware | M3 standoff, screw and nut kit + cable ties | 1 | Local (Online) | 300
USB cable | Data-capable USB cable for ESP32 (micro-USB or USB-C, match the board) | 1 | Local (Online) | 100
Soldering consumables | 0.8 mm solder wire + no-clean flux paste (skip if lab provides) | 1 | Local (Offline) | 400
Base plate | 6 mm acrylic sheet, 300x300 mm, cut to size | 1 | Local (Offline) | 400
Printing filament | PETG 500 g (heat-resistant) for sensor pockets and separator sleeves | 1 | Local (Online) | 700
PCM material | Refined paraffin wax, 58-60 C melting point, 250 g, for sleeve lining | 1 | Local (Offline) | 150
Gas pocket sealing | Neutral-cure silicone sealant or closed-cell foam gasket tape, seals each segment's gas pocket | 1 | Local (Online) | 150
Thermal paste | Arctic MX-4 or similar, 4 g, for probe-to-cell contact | 1 | Local (Online) | 400
Kapton tape | 10 mm x 33 m polyimide tape, to hold probes on cells | 1 | Local (Online) | 150
Aluminium foil tape | 50 mm x 10 m, for sleeve lining and heat spreading | 1 | Local (Online) | 150
Fireproof cell bag | Li-ion / LiPo fireproof charging and storage bag | 1 | Local (Online) | 450
Safety glasses | Clear polycarbonate, anti-fog | 2 | Local (Online) | 300
Sand bucket | Dry sand bucket kept next to rig (CO2 / ABC extinguisher from the lab, not counted here) | 1 | Local (Offline) | 200
Shipping and handling | Estimate across 3 to 4 online orders (Robu, Hubtronics, Amazon) | 1 | Local (Online) | 600
 |  |  | Total | 22882

Sheet: Spares
Component | Part / Specification | Qty | Lead Time | Cost (INR)
MQ-7 CO sensor module | Spare for dead / drifting sensor (these are commonly DOA or off by a lot) | 2 | Local (Online) | 380
MQ-8 H2 sensor module | Spare for dead / drifting sensor | 2 | Local (Online) | 400
DS18B20 waterproof probe | Spare probes, fake / faulty units are common, test each on arrival | 3 | Local (Online) | 360
ADS1115 module | Spare ADC, one failed channel would break a segment | 1 | Local (Online) | 350
INA219 module | Spare current sensor | 1 | Local (Online) | 250
DS3231 RTC module | Spare RTC | 1 | Local (Online) | 220
CR2032 coin cell | Spare RTC battery | 1 | Local (Online) | 30
SSD1306 OLED | Spare display | 1 | Local (Online) | 250
PCF8574 module | Spare LED expander | 1 | Local (Online) | 75
ESP32-DevKitC-32E | Spare controller, so a burnt board does not stop the demo | 1 | Local (Online) | 850
microSD card module | Spare SPI module | 1 | Local (Online) | 100
1-channel relay module | Spare relay (can also replace a dead channel on the 4-ch board) | 2 | Local (Online) | 240
4-channel relay module | Spare isolation relay board | 1 | Local (Online) | 280
Samsung INR18650-25R | Spare cells from the same lot (replacement and matched swap-in) | 2 | Local (Online) | 1176
18650 cell holder | Spare holders | 2 | Local (Online) | 80
IRLZ44N MOSFET | Spare MOSFETs | 3 | Local (Online) | 135
TC4427 gate driver | Spare gate driver IC | 1 | Local (Online) | 60
Heater cartridge 12 V 40 W | Spare heater | 1 | Local (Online) | 150
XL4015 buck module | Spare 5 V converter | 1 | Local (Online) | 250
Perfboard 18x12 cm | Spare board for a rebuild if a layout goes wrong | 1 | Local (Online) | 160
5 V active buzzer | Spare buzzer | 1 | Local (Online) | 30
XT60 pair | Spare connector pair | 1 | Local (Online) | 60
DC input jack | Spare 5.5 x 2.1 mm panel jack, rated 5 A or more | 1 | Local (Online) | 50
USB cable | Spare data cable | 1 | Local (Online) | 100
5x20 mm fuses | Extra fuse pack (blows during short-circuit tests) | 1 | Local (Online) | 150
 |  |  | Total | 6186

Sheet: Summary
Item | Cost (INR)
Core BOM | 22882
Spares | 6186
Subtotal | 29068
Contingency (10% of subtotal: price changes, wrong part, re-orders) | 2907
Grand total | 31975
Assumptions
Prices are indicative, INR including GST, based on Indian online vendors (Robu, Hubtronics, Probots) and local market in Sept-Oct 2026. Samsung 25R at Rs 588 is the Hubtronics listing. Re-check at the time of ordering.
Rig is 4 segments, one 18650 per segment, wired as a 4S string. Each segment has an SPDT relay: energised = cell in string, de-energised = cell bypassed and its positive terminal left open (fail-secure).
Per-cell voltage is read through resistor dividers into ADS1115 and calibrated against a multimeter in firmware (1% resistors).
MQ-7 / MQ-8 modules run on constant 5 V heater supply, no heater cycling. Gas AO outputs are divided down to stay under 3.3 V.
No commercial BMS is in the loop; cells are charged separately in the Liitokala charger.
Not counted: multimeter, soldering iron, 3D printer access, lab fire extinguisher.
Revision 2 (20 Oct 2026): LM2596 replaced by a 5 A XL4015 (5 V rail peaks near 2.3 A); added TC4427 gate driver, PCF8574 LED expanders, BC547 buzzer driver, IRF4905 reverse-polarity protection, DC input jack, CR2032, load-resistor heatsink, hydrogen test source, sealed gas test box, gas-pocket sealing, reference thermocouple and PTC fuses; fuse ratings assigned (3 A pack, 5 A heater).
Prices for the Revision 2 items are estimates; re-check at the time of ordering.
Revision 2.1 (20 Oct 2026): ADS1115 #3 moved to 0x4B; PTC polyfuses changed to 2.5 A hold (MF-R250); KSD301 cutoff 100 C to 70 C; E-stop gets a second NC block for the heater line (+Rs 100 est.); DC jack must be rated 5 A or more (+Rs 20 core, +Rs 20 spare, est.); relay VCC/JD-VCC both 5 V; 1 uF at TC4427 VDD; low-Vf green LEDs.
