Aryan-swag/VentSense/exports/VS_kicad_bom.csv

Refs | Value | Footprint | Qty | DNP
BT1 | INR18650-25R |  | 1
BT2 | INR18650-25R |  | 1
BT3 | INR18650-25R |  | 1
BT4 | INR18650-25R |  | 1
BZ1 | 5V active buzzer |  | 1
C1 | 1000uF 25V |  | 1
C2 | 1000uF 25V |  | 1
C3 | 1uF | Package_SO:SOIC-8_3.9x4.9mm_P1.27mm | 1
C4 | 0.1uF |  | 1
C5 | 100uF |  | 1
C6 | 0.1uF |  | 1
C7 | 100nF |  | 1
C8 | 100nF |  | 1
C9 | 100nF |  | 1
C10 | 100nF |  | 1
D1 | 1N4742A 12V |  | 1
D2 | Seg 1 Red | Package_DIP:DIP-8_W7.62mm | 1
D3 | Seg 1 Yellow | Package_DIP:DIP-8_W7.62mm | 1
D4 | Seg 1 Green | Package_DIP:DIP-8_W7.62mm | 1
D5 | Seg 2 Yellow | Package_DIP:DIP-8_W7.62mm | 1
D6 | Seg 2 Red | Package_DIP:DIP-8_W7.62mm | 1
D7 | Seg 2 Green | Package_DIP:DIP-8_W7.62mm | 1
D8 | Seg 3 Red | Package_DIP:DIP-8_W7.62mm | 1
D9 | Seg 3 Yellow | Package_DIP:DIP-8_W7.62mm | 1
D10 | Seg 3 Green | Package_DIP:DIP-8_W7.62mm | 1
D11 | Seg 4 Red | Package_DIP:DIP-8_W7.62mm | 1
D12 | Seg 4 Yellow | Package_DIP:DIP-8_W7.62mm | 1
D13 | Seg 4 Green | Package_DIP:DIP-8_W7.62mm | 1
F1 | 5A fast 5x20 |  | 1
F2 | MF-R250 2.5A hold |  | 1
F3 | MF-R250 2.5A hold |  | 1
F4 | MF-R250 2.5A hold |  | 1
F5 | MF-R250 2.5A hold |  | 1
F6 | 3A fast 5x20 |  | 1
HT1 | 12V 40W cartridge |  | 1
J1 | DC jack 5.5x2.1 ≥5A |  | 1
J2 | XT60 (load) |  | 1
K1 | 4ch relay SRD-05VDC-SL-C |  | 1
K2 | 1ch relay (pack) |  | 1
Q1 | IRF4905 | Package_TO_SOT_THT:TO-220-3_Vertical | 1
Q2 | IRLZ44N | Package_TO_SOT_THT:TO-220-3_Vertical | 1
Q3 | IRLZ44N | Package_TO_SOT_THT:TO-220-3_Vertical | 1
Q4 | BC547 | Package_TO_SOT_THT:TO-92_Inline | 1
R1 | 10k | Package_TO_SOT_THT:TO-220-3_Vertical | 1
R2 | 100k | Package_TO_SOT_THT:TO-220-3_Vertical | 1
R3 | 100k |  | 1
R4 | 10 |  | 1
R5 | 10 |  | 1
R6 | 100k |  | 1
R7 | 100k |  | 1
R8 | 10R 50W |  | 1
R9 | 100k 1% |  | 1
R10 | 20k 1% |  | 1
R11 | 20k 1% |  | 1
R12 | 100k 1% |  | 1
R13 | 20k 1% |  | 1
R14 | 100k 1% |  | 1
R15 | 20k 1% |  | 1
R16 | 100k 1% |  | 1
R17 | 15k |  | 1
R18 | 22k |  | 1
R19 | 15k |  | 1
R20 | 22k |  | 1
R21 | 15k |  | 1
R22 | 22k |  | 1
R23 | 15k |  | 1
R24 | 22k |  | 1
R25 | 15k |  | 1
R26 | 22k |  | 1
R27 | 15k |  | 1
R28 | 22k |  | 1
R29 | 15k |  | 1
R30 | 22k |  | 1
R31 | 15k |  | 1
R32 | 22k |  | 1
R33 | 4.7 kΩ |  | 1
R34 | 4.7k |  | 1 | DNP
R35 | 4.7k |  | 1 | DNP
R36 | 330 |  | 1
R37 | 330 |  | 1
R38 | 330 |  | 1
R39 | 330 |  | 1
R40 | 330 |  | 1
R41 | 330 |  | 1
R42 | 330 |  | 1
R43 | 330 |  | 1
R44 | 330 |  | 1
R45 | 330 |  | 1
R46 | 330 |  | 1
R47 | 330 |  | 1
R48 | 1k | Package_TO_SOT_THT:TO-92_Inline | 1
R49 | 10k | Package_TO_SOT_THT:TO-92_Inline | 1
R50 | 10k | Package_TO_SOT_THT:TO-92_Inline | 1
S1 | E-stop 2NC |  | 1
SW1 | Acknowledge |  | 1
SW2 | Reset |  | 1
TS1 | KSD301 70°C NC |  | 1
U1 | TC4427 (DIP-8) | Package_SO:SOIC-8_3.9x4.9mm_P1.27mm | 1
U2 | XL4015 set 5.0V | Package_TO_SOT_THT:TO-220-3_Vertical | 1
U3 | INA219 0x40 |  | 1
U4 | ADS1115 #1 0x48 (CO) |  | 1
U5 | ADS1115 #2 0x49 (H2) |  | 1
U6 | ADS1115 #3 0x4B (cells) |  | 1
U7 | MQ-7 seg 1 |  | 1
U8 | MQ-7 seg 2 |  | 1
U9 | MQ-7 seg 3 |  | 1
U10 | MQ-7 seg 4 |  | 1
U11 | MQ-8 seg 1 |  | 1
U12 | MQ-8 seg 2 |  | 1
U13 | MQ-8 seg 3 |  | 1
U14 | MQ-8 seg 4 |  | 1
U15 | DS18B20 cell 1 |  | 1
U16 | DS18B20 cell 2 |  | 1
U17 | DS18B20 cell 3 |  | 1
U18 | DS18B20 cell 4 |  | 1
U19 | ESP32-DevKitC-32E |  | 1
U20 | OLED 0x3C |  | 1
U21 | DS3231 RTC 0x68 |  | 1
U22 | BME280 0x76 |  | 1
U23 | PCF8574 #1 0x20 |  | 1
U24 | PCF8574 #2 0x21 |  | 1
U25 | microSD |  | 1
U26 | MAX6675 |  | 1
