Aryan-swag/VentSense/PCB/bom/VS_BOM_v1.1_all.csv

Reference | Value | Footprint | QUANTITY | DNP
BT1-BT4 | INR18650-25R | VentSense_Footprints:TerminalBlock_1x02_P5.08mm | 4
BZ1 | 5V active buzzer | Buzzer_Beeper:Buzzer_12x9.5RM7.6 | 1
C1,C2 | 1000uF 25V | Capacitor_THT:CP_Radial_D10.0mm_P5.00mm | 2
C3 | 1uF | Capacitor_THT:C_Disc_D5.0mm_W2.5mm_P2.50mm | 1
C4,C6 | 0.1uF | Capacitor_THT:C_Disc_D5.0mm_W2.5mm_P2.50mm | 2
C5,C11 | 100uF | Capacitor_THT:CP_Radial_D6.3mm_P2.50mm | 2
C7-C10,C12 | 100nF | Capacitor_THT:C_Disc_D5.0mm_W2.5mm_P2.50mm | 5
D1 | 1N4742A 12V | Diode_THT:D_DO-41_SOD81_P7.62mm_Horizontal | 1
D2 | Seg 1 Red | LED_THT:LED_D3.0mm | 1
D3 | Seg 1 Yellow | LED_THT:LED_D3.0mm | 1
D4 | Seg 1 Green | LED_THT:LED_D3.0mm | 1
D5 | Seg 2 Yellow | LED_THT:LED_D3.0mm | 1
D6 | Seg 2 Red | LED_THT:LED_D3.0mm | 1
D7 | Seg 2 Green | LED_THT:LED_D3.0mm | 1
D8 | Seg 3 Red | LED_THT:LED_D3.0mm | 1
D9 | Seg 3 Yellow | LED_THT:LED_D3.0mm | 1
D10 | Seg 3 Green | LED_THT:LED_D3.0mm | 1
D11 | Seg 4 Red | LED_THT:LED_D3.0mm | 1
D12 | Seg 4 Yellow | LED_THT:LED_D3.0mm | 1
D13 | Seg 4 Green | LED_THT:LED_D3.0mm | 1
F1 | 5A fast 5x20 | VentSense_Footprints:TerminalBlock_1x02_P5.08mm | 1
F2-F5 | MF-R250 2.5A hold | VentSense_Footprints:TerminalBlock_1x02_P5.08mm | 4
F6 | 3A fast 5x20 | VentSense_Footprints:TerminalBlock_1x02_P5.08mm | 1
HT1 | 12V 40W cartridge | VentSense_Footprints:TerminalBlock_1x02_P5.08mm | 1
J1 | DC jack 5.5x2.1 ≥5A | Connector_BarrelJack:BarrelJack_Horizontal | 1
J2 | XT60 (load) | Connector_AMASS:AMASS_XT60-M_1x02_P7.20mm_Vertical | 1
J3 | J_5V_IN (from XL4015) | TerminalBlock_Phoenix:TerminalBlock_Phoenix_MKDS-1,5-2-5.08_1x02_P5.08mm_Horizontal | 1
J4 | J_12V_IN (protected +12V) | TerminalBlock_Phoenix:TerminalBlock_Phoenix_MKDS-1,5-2-5.08_1x02_P5.08mm_Horizontal | 1
J5 | J_CELL (cell + taps) | TerminalBlock_Phoenix:TerminalBlock_Phoenix_MKDS-1,5-6-5.08_1x06_P5.08mm_Horizontal | 1
J6 | J_RLY_SEG (4-ch relay module) | Connector_PinHeader_2.54mm:PinHeader_1x08_P2.54mm_Vertical | 1
J7 | J_RLY_PACK (1-ch relay module) | Connector_PinHeader_2.54mm:PinHeader_1x04_P2.54mm_Vertical | 1
J8 | J_GATE (to off-board IRLZ44N) | TerminalBlock_Phoenix:TerminalBlock_Phoenix_MKDS-1,5-4-5.08_1x04_P5.08mm_Horizontal | 1
J9 | J_I2C_EXT (INA219) | Connector_PinHeader_2.54mm:PinHeader_1x04_P2.54mm_Vertical | 1
K1 | 4ch relay SRD-05VDC-SL-C | Connector_PinSocket_2.54mm:PinSocket_1x20_P2.54mm_Vertical | 1
K2 | 1ch relay (pack) | Connector_PinSocket_2.54mm:PinSocket_1x06_P2.54mm_Vertical | 1
Q1 | IRF4905 | Package_TO_SOT_THT:TO-220-3_Vertical | 1
Q2,Q3 | IRLZ44N | Package_TO_SOT_THT:TO-220-3_Vertical | 2
Q4 | BC547 | Package_TO_SOT_THT:TO-92_Inline | 1
R1,R49,R50 | 10k | Resistor_THT:R_Axial_DIN0207_L6.3mm_D2.5mm_P7.62mm_Horizontal | 3
R2,R3,R6,R7,R51,R52 | 100k | Resistor_THT:R_Axial_DIN0207_L6.3mm_D2.5mm_P7.62mm_Horizontal | 6
R4,R5 | 10 | Resistor_THT:R_Axial_DIN0207_L6.3mm_D2.5mm_P7.62mm_Horizontal | 2
R8 | 10R 50W | VentSense_Footprints:TerminalBlock_1x02_P5.08mm | 1
R9,R12,R14,R16 | 100k 1% | Resistor_THT:R_Axial_DIN0207_L6.3mm_D2.5mm_P7.62mm_Horizontal | 4
R10,R11,R13,R15 | 20k 1% | Resistor_THT:R_Axial_DIN0207_L6.3mm_D2.5mm_P7.62mm_Horizontal | 4
R17,R19,R21,R23,R25,R27,R29,R31 | 15k | Resistor_THT:R_Axial_DIN0207_L6.3mm_D2.5mm_P7.62mm_Horizontal | 8
R18,R20,R22,R24,R26,R28,R30,R32 | 22k | Resistor_THT:R_Axial_DIN0207_L6.3mm_D2.5mm_P7.62mm_Horizontal | 8
R33 | 4.7 kΩ | Resistor_THT:R_Axial_DIN0207_L6.3mm_D2.5mm_P7.62mm_Horizontal | 1
R36-R47 | 330 | Resistor_THT:R_Axial_DIN0207_L6.3mm_D2.5mm_P7.62mm_Horizontal | 12
R48 | 1k | Resistor_THT:R_Axial_DIN0207_L6.3mm_D2.5mm_P7.62mm_Horizontal | 1
S1 | E-stop 2NC | VentSense_Footprints:TerminalBlock_EStop_2NC_P5.08mm | 1
SW1 | Acknowledge | Button_Switch_THT:SW_PUSH_6mm | 1
SW2 | Reset | Button_Switch_THT:SW_PUSH_6mm | 1
TS1 | KSD301 70°C NC | VentSense_Footprints:TerminalBlock_1x02_P5.08mm | 1
U1 | TC4427 (DIP-8) | Package_DIP:DIP-8_W7.62mm | 1
U2 | XL4015 set 5.0V | Connector_PinSocket_2.54mm:PinSocket_1x04_P2.54mm_Vertical | 1
U3 | INA219 0x40 | Connector_PinSocket_2.54mm:PinSocket_1x06_P2.54mm_Vertical | 1
U4 | ADS1115 #1 0x48 (CO) | Connector_PinSocket_2.54mm:PinSocket_1x10_P2.54mm_Vertical | 1
U5 | ADS1115 #2 0x49 (H2) | Connector_PinSocket_2.54mm:PinSocket_1x10_P2.54mm_Vertical | 1
U6 | ADS1115 #3 0x4B (cells) | Connector_PinSocket_2.54mm:PinSocket_1x10_P2.54mm_Vertical | 1
U7 | MQ-7 seg 1 | Connector_JST:JST_XH_B4B-XH-A_1x04_P2.50mm_Vertical | 1
U8 | MQ-7 seg 2 | Connector_JST:JST_XH_B4B-XH-A_1x04_P2.50mm_Vertical | 1
U9 | MQ-7 seg 3 | Connector_JST:JST_XH_B4B-XH-A_1x04_P2.50mm_Vertical | 1
U10 | MQ-7 seg 4 | Connector_JST:JST_XH_B4B-XH-A_1x04_P2.50mm_Vertical | 1
U11 | MQ-8 seg 1 | Connector_JST:JST_XH_B4B-XH-A_1x04_P2.50mm_Vertical | 1
U12 | MQ-8 seg 2 | Connector_JST:JST_XH_B4B-XH-A_1x04_P2.50mm_Vertical | 1
U13 | MQ-8 seg 3 | Connector_JST:JST_XH_B4B-XH-A_1x04_P2.50mm_Vertical | 1
U14 | MQ-8 seg 4 | Connector_JST:JST_XH_B4B-XH-A_1x04_P2.50mm_Vertical | 1
U15 | DS18B20 cell 1 | Connector_JST:JST_XH_B3B-XH-A_1x03_P2.50mm_Vertical | 1
U16 | DS18B20 cell 2 | Connector_JST:JST_XH_B3B-XH-A_1x03_P2.50mm_Vertical | 1
U17 | DS18B20 cell 3 | Connector_JST:JST_XH_B3B-XH-A_1x03_P2.50mm_Vertical | 1
U18 | DS18B20 cell 4 | Connector_JST:JST_XH_B3B-XH-A_1x03_P2.50mm_Vertical | 1
U19 | ESP32-DevKitC-32E | VentSense_Footprints:ESP32-DevKitC-32E_2x19_P2.54mm_W25.4mm | 1
U20 | OLED 0x3C | Connector_PinSocket_2.54mm:PinSocket_1x04_P2.54mm_Vertical | 1
U21 | DS3231 RTC 0x68 | Connector_PinSocket_2.54mm:PinSocket_1x06_P2.54mm_Vertical | 1
U22 | BME280 0x76 | Connector_PinSocket_2.54mm:PinSocket_1x04_P2.54mm_Vertical | 1
U23 | PCF8574 #1 0x20 | Connector_PinSocket_2.54mm:PinSocket_1x13_P2.54mm_Vertical | 1
U24 | PCF8574 #2 0x21 | Connector_PinSocket_2.54mm:PinSocket_1x13_P2.54mm_Vertical | 1
U25 | microSD | Connector_PinSocket_2.54mm:PinSocket_1x06_P2.54mm_Vertical | 1
U26 | MAX6675 | Connector_PinSocket_2.54mm:PinSocket_1x05_P2.54mm_Vertical | 1
