Aryan-swag/VentSense/ventsense_cad/ventsense_full_assembly_exploded.SLDASM

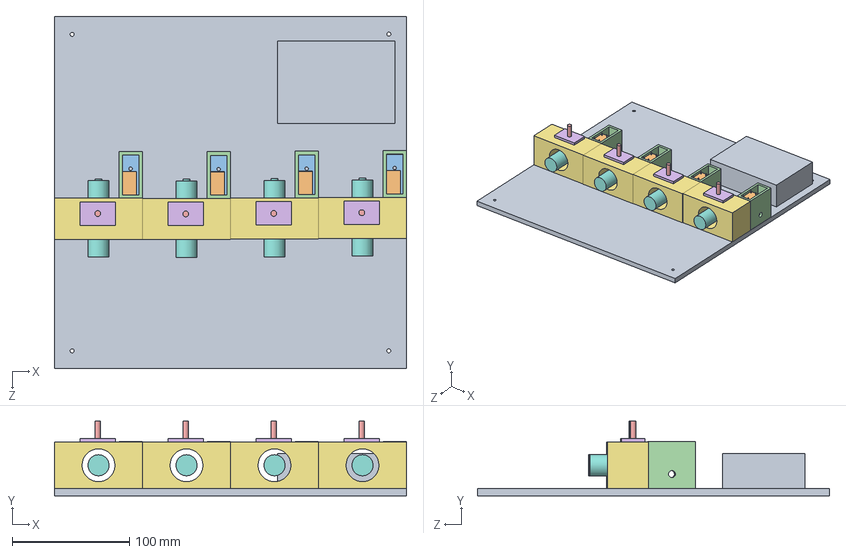
[picture p31: CAD file, 2026-10-25]
ventsense_cad/ventsense_full_assembly_exploded.SLDASM
300.0 x 63.5 x 300.0 mm
ventsense_PTEG_carrier x 4
ventsense_sensor_bracket x 4
ventsense_temperature_sensor x 4
ventsense_gas_chamber x 4
ventsense_gas_divider x 4
ventsense_gas_sensor x 4
ventsense_electronics_enclosure
