Aryan-swag/VentSense/ventsense_cad/Assem2.SLDASM

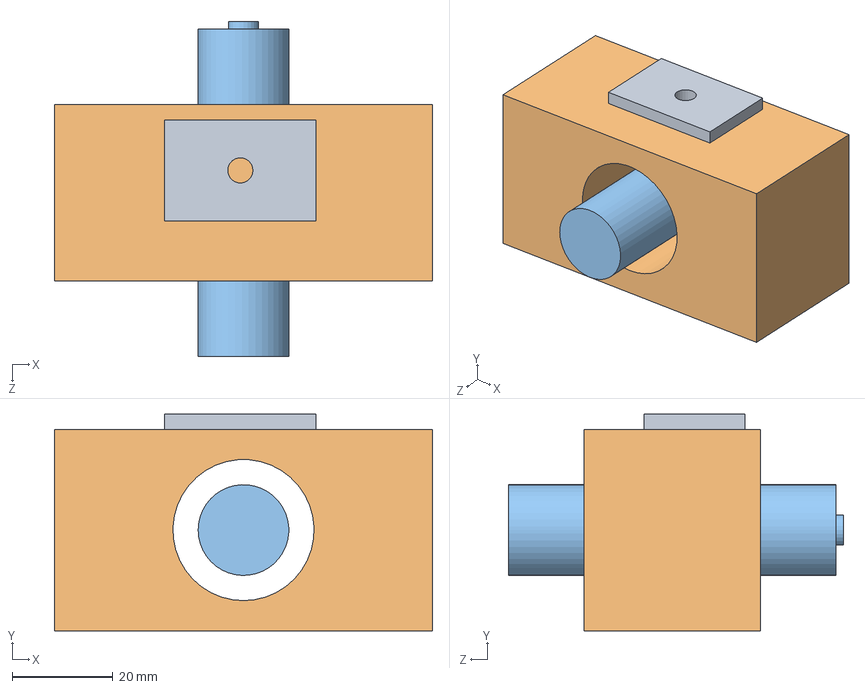
[picture p32: CAD file, 2026-10-25]
ventsense_cad/Assem2.SLDASM
75.0 x 43.0 x 66.5 mm
ventsense_PTEG_carrier
ventsense_sensor_bracket
