Aryan-swag/VentSense/ventsense_cad/ventsense_cell_assembly.SLDASM

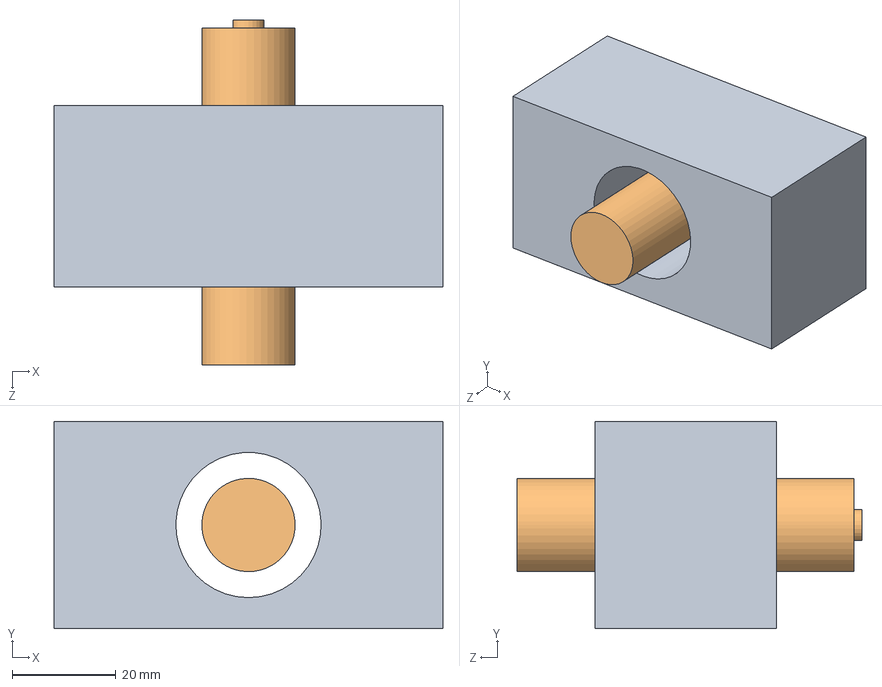
[picture p33: CAD file, 2026-10-25]
ventsense_cad/ventsense_cell_assembly.SLDASM
75.0 x 40.0 x 66.5 mm
ventsense_PTEG_carrier
