Aryan-swag/VentSense/ventsense_cad/Assem3.SLDASM

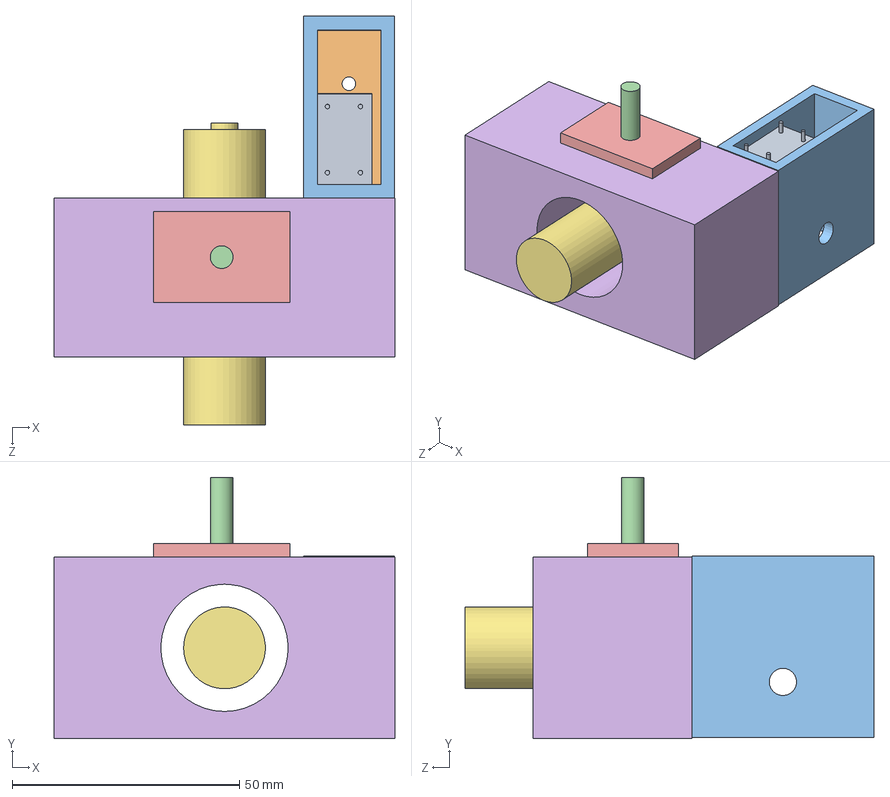
[picture p34: CAD file, 2026-10-25]
ventsense_cad/Assem3.SLDASM
75.0 x 57.5 x 90.0 mm
ventsense_PTEG_carrier
ventsense_sensor_bracket
ventsense_temperature_sensor
ventsense_gas_chamber
ventsense_gas_divider
ventsense_gas_sensor
