Aryan-swag/VentSense/ventsense_cad/ventsense_gas_divider.SLDPRT

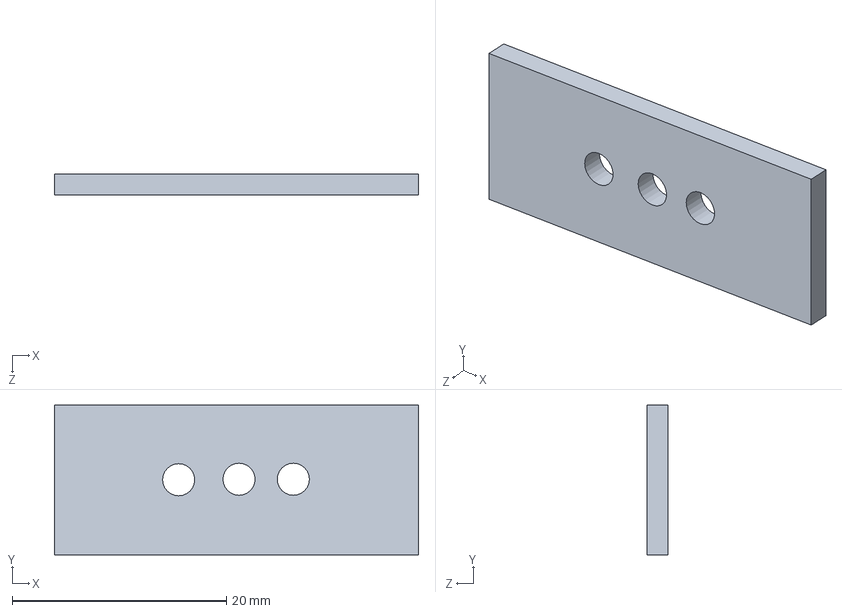
[picture p35: CAD file, 2026-10-25]
ventsense_cad/ventsense_gas_divider.SLDPRT
34.0 x 14.0 x 2.00 mm
