Aryan-swag/VentSense/ventsense_cad/Part1.SLDPRT

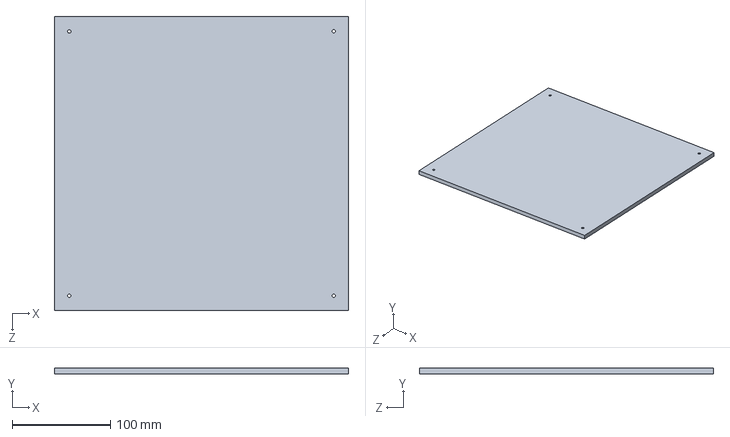
[picture p36: CAD file, 2026-10-25]
ventsense_cad/Part1.SLDPRT
300.0 x 6.00 x 300.0 mm
