Aryan-swag/VentSense/ventsense_cad/ventsense_temperature_sensor.SLDPRT

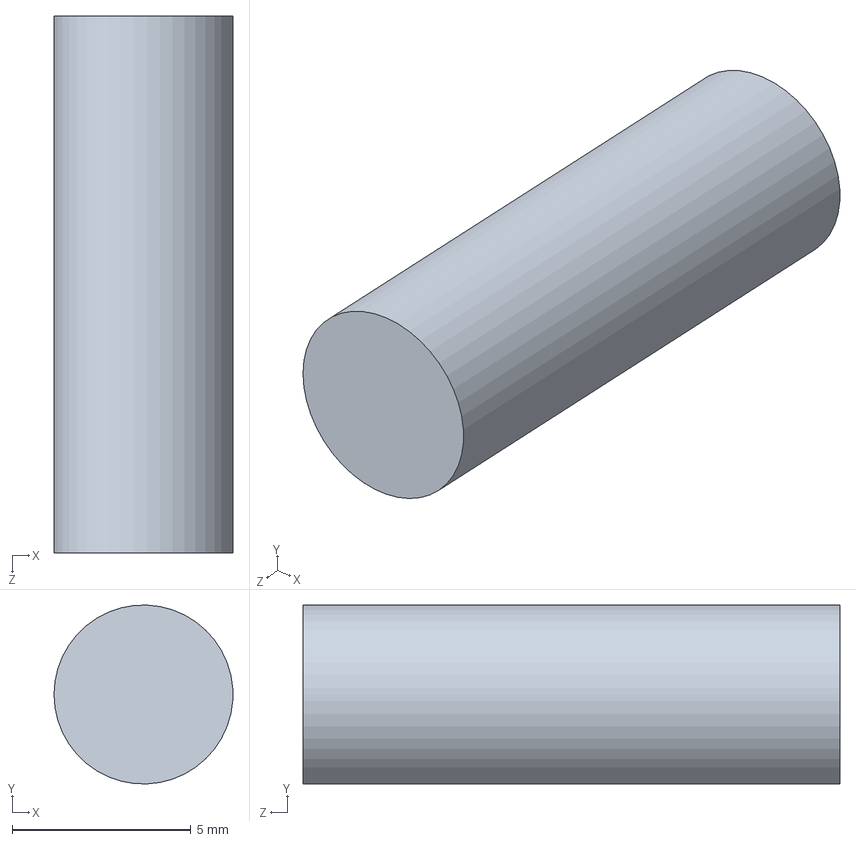
[picture p37: CAD file, 2026-10-25]
ventsense_cad/ventsense_temperature_sensor.SLDPRT
5.00 x 5.00 x 15.0 mm
