Aryan-swag/VentSense/ventsense_cad/ventsense_electronics_enclosure.SLDPRT

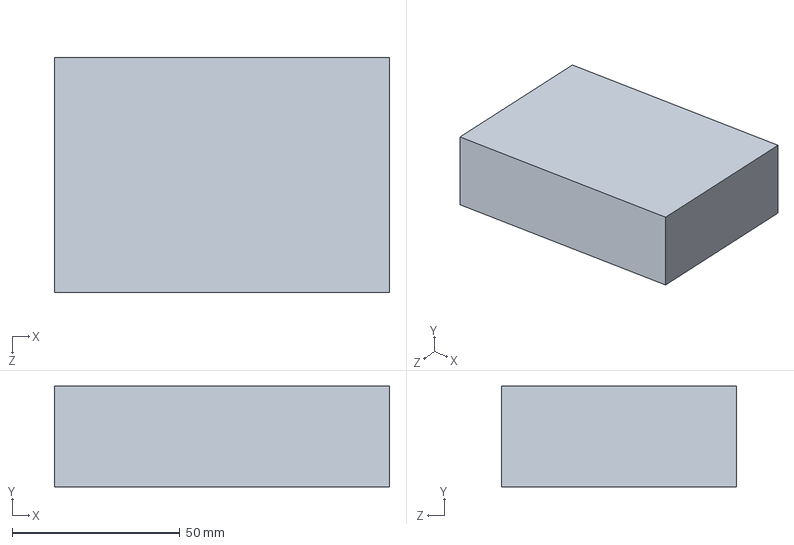
[picture p38: CAD file, 2026-10-25]
ventsense_cad/ventsense_electronics_enclosure.SLDPRT
100.0 x 30.0 x 70.0 mm
