Aryan-swag/VentSense/ventsense_cad/ventsense_gas_chamber.SLDPRT

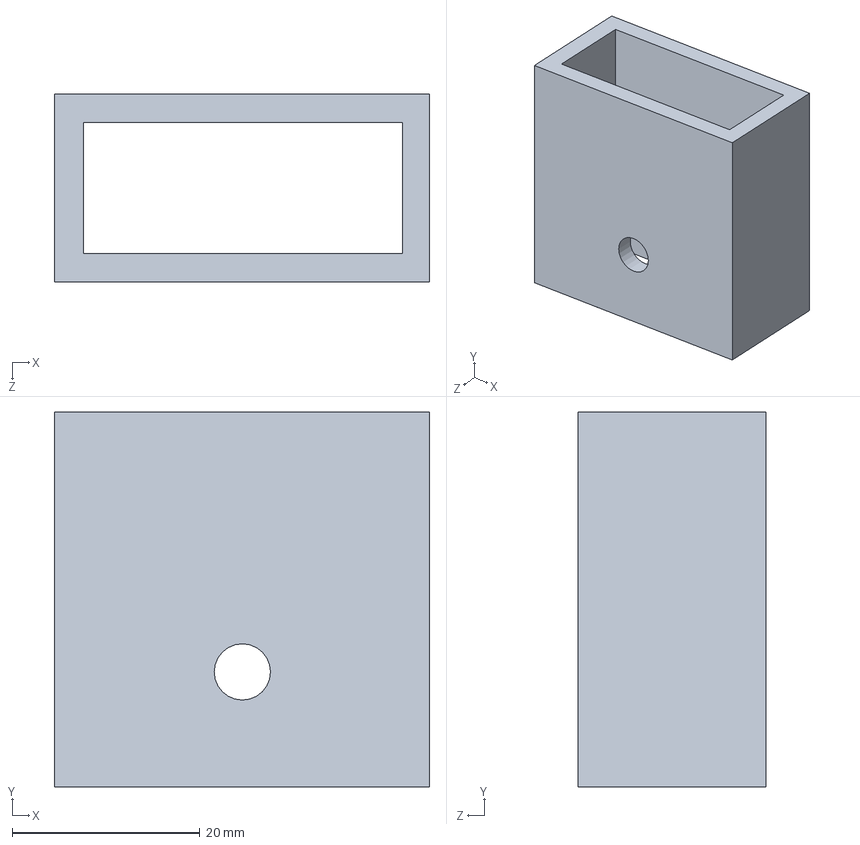
[picture p39: CAD file, 2026-10-25]
ventsense_cad/ventsense_gas_chamber.SLDPRT
40.0 x 40.0 x 20.0 mm
