Aryan-swag/VentSense/ventsense_cad/ventsense_PCM_Sleeve.SLDPRT

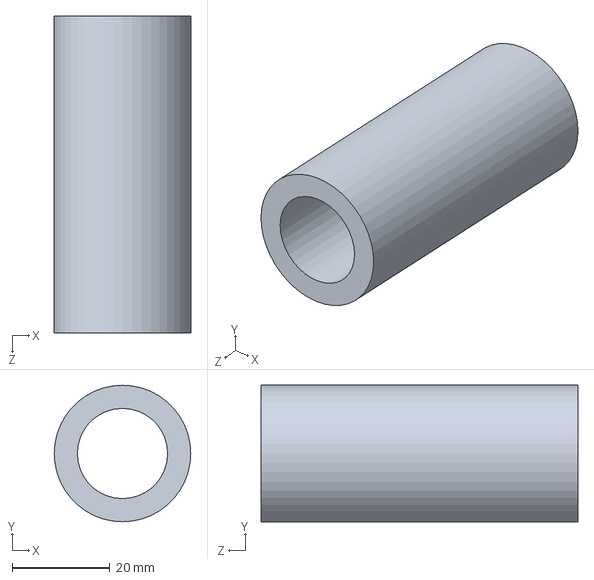
[picture p40: CAD file, 2026-10-25]
ventsense_cad/ventsense_PCM_Sleeve.SLDPRT
28.0 x 28.0 x 65.0 mm
