Aryan-swag/VentSense/ventsense_cad/ventsense_gas_sensor.SLDPRT

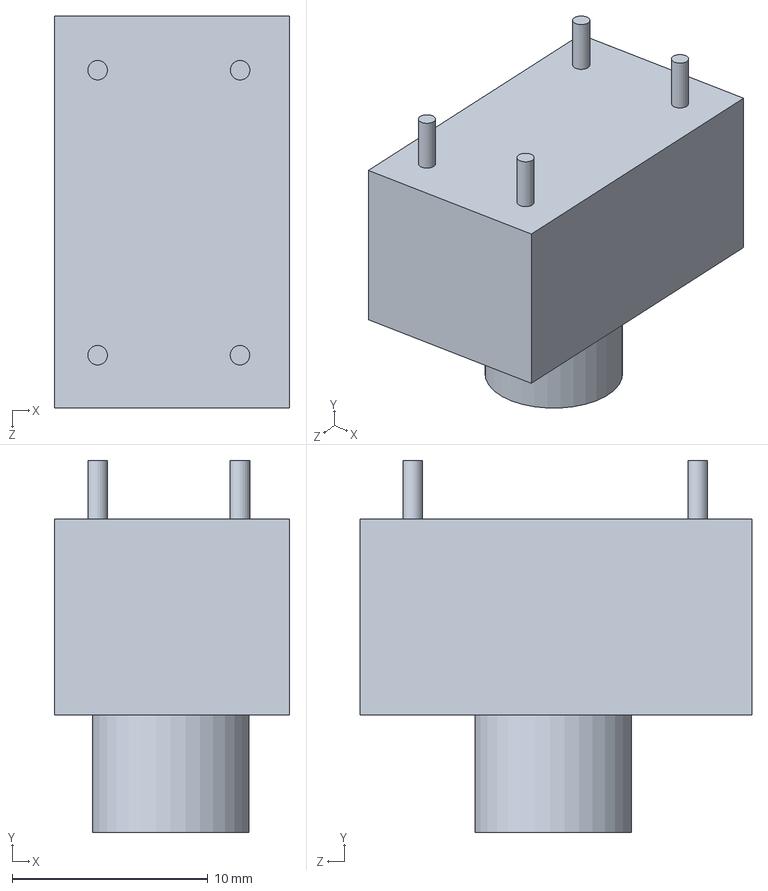
[picture p41: CAD file, 2026-10-25]
ventsense_cad/ventsense_gas_sensor.SLDPRT
12.0 x 19.0 x 20.0 mm
