Aryan-swag/VentSense/ventsense_cad/ventsense_PTEG_carrier.SLDPRT

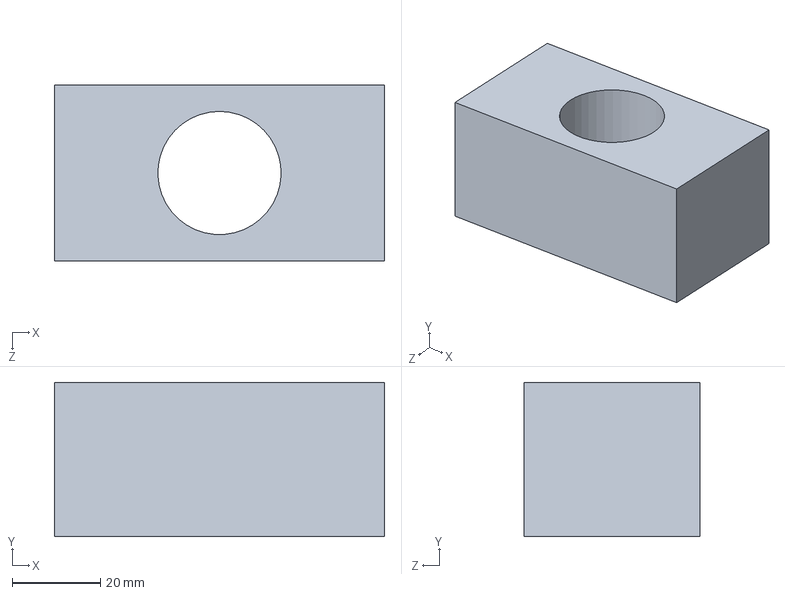
[picture p42: CAD file, 2026-10-25]
ventsense_cad/ventsense_PTEG_carrier.SLDPRT
75.0 x 35.0 x 40.0 mm
