Aryan-swag/VentSense/ventsense_cad/ventsense_sensor_bracket.SLDPRT

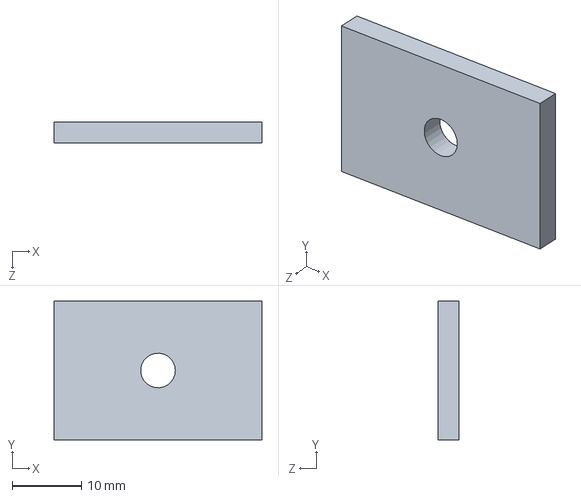
[picture p43: CAD file, 2026-10-25]
ventsense_cad/ventsense_sensor_bracket.SLDPRT
30.0 x 20.0 x 3.00 mm
