Aryan-swag/VentSense/ventsense_cad/Part2.SLDPRT

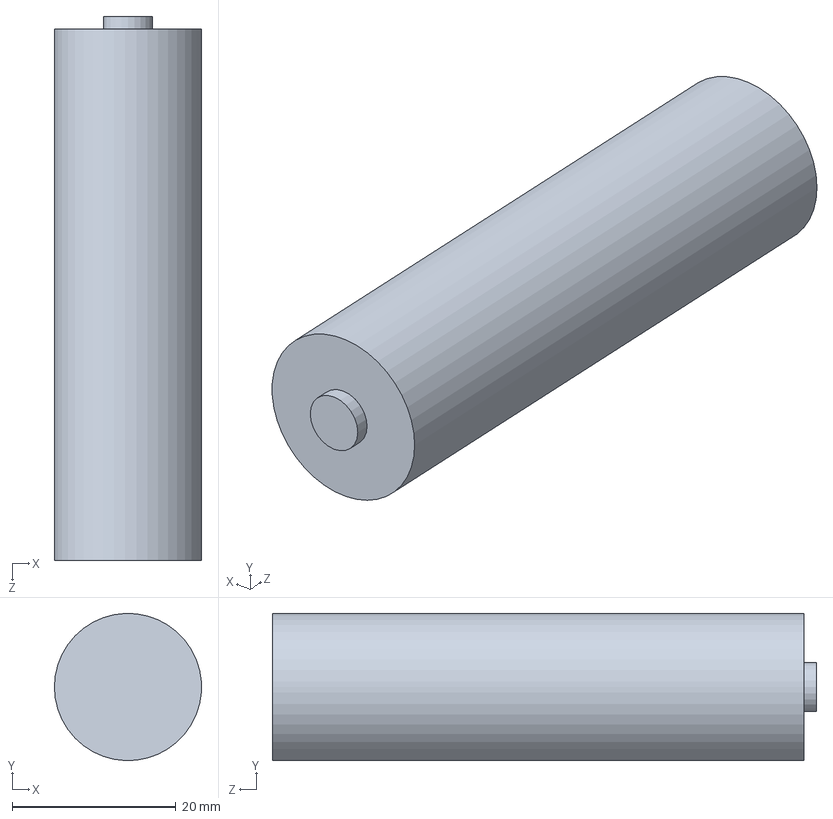
[picture p44: CAD file, 2026-10-25]
ventsense_cad/Part2.SLDPRT
18.0 x 18.0 x 66.5 mm
