Aryan-swag/VentSense/(list of files, cad)

Other CAD files:
ventsense_cad/ventsense_full_assembly.SLDASM
