Aryan-swag/VentSense/ventsense_cad/ventsense_cell_assembly2.html

Skip to content (https://chatgpt.com/c/6ad76a1b-84d4-83ec-b045-88be85c614a7#_r_a3_)

ChatGPT

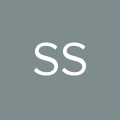
[picture p45: ventsense_cad/ventsense_cell_assembly2_files/ss.png]
 Siddharth C SFree

Claim offer

Free offer

Share

#### You said:

now the positive terminal 1.5 cm long is out of the carrier, negative terminal is 30 cm out of carrier

#### ChatGPT said:

Okay, let's stop and correct the geometry before proceeding. The positive terminal extending out is fine, but the negative end extending 30 cm out suggests either a unit mix-up or a positioning issue.

First, a quick correction: our sleeve is 65 mm long, and the carrier is 35 mm tall. The sleeve should extend about 15 mm beyond each side if centered.

You mentioned 30 cm on the negative side. Did you mean 30 mm (3 cm)?

## Step 30A — Check the distance mate

1. In the FeatureManager design tree, find the latest Distance mate you created.
2. Right-click it and select Edit Feature.
3. Check the distance value. It should be 15 mm, not 15 cm or 150 mm.
4. Don't change anything yet.

Tell me two things:

- Does the mate value show 15 mm?
- Did you mean the negative end extends 30 mm or 30 cm beyond the carrier?

We'll fix the positioning based on those values.

#### You said:

3 cm

#### ChatGPT said:

Got it — the negative end extends 3 cm (30 mm) beyond the carrier.

That makes sense given our current geometry. Let's check the dimensions:

- Sleeve length: 65 mm
- Carrier height: 35 mm
- Difference: 65-35=30\text{ mm}

If the sleeve is centered vertically, it extends 15 mm (1.5 cm) beyond each side of the carrier.

Your positive terminal adds another 1.5 mm beyond the cell body.

## Step 31 — Correct the sleeve position

Let's center the sleeve vertically in the carrier.

1. In the FeatureManager tree, find the Distance mate you created.
2. Right-click it and select Edit Feature.
3. Change the distance to 15 mm if it isn't already.
4. Check that the selected faces are the top face of the carrier and the top circular end face of the sleeve.
5. Click the green checkmark.

The sleeve should now extend 15 mm beyond the top and bottom of the carrier.

Your turn: Apply the mate and tell me whether both ends extend approximately 15 mm beyond the carrier.

#### You said:

1 selection

where can i find it

#### ChatGPT said:

In SolidWorks, you can find Distance Mate in the Mate PropertyManager.

Follow these steps:

1. In your assembly, click the Assembly tab at the top.
2. Click Mate (the icon usually looks like two faces being joined).
3. In the left-side Mate PropertyManager, look under Standard Mates.
4. Select Distance — it may appear as a distance option alongside Coincident, Concentric, Parallel, and Perpendicular.
5. Click the two faces:
  - The top face of the carrier (rectangular block).
  - The circular end face of the PCM sleeve.
6. Enter 15 mm in the distance field, then click the green checkmark (✓).

Tip: If you already created a Distance mate, expand the assembly’s Mates folder in the FeatureManager tree, right-click that mate, and select Edit Feature to change its value to 15 mm.

Try that and tell me what you see.

#### You said:

ok now thats done

#### ChatGPT said:

Great. Now let’s verify the cell assembly before moving on.

### Step: Check the sleeve overhang

1. Rotate the assembly so you can see the top and bottom ends of the carrier.
2. Check how far the PCM sleeve extends beyond the carrier at each end.
3. Ideally, it should extend approximately 15 mm on both sides because the sleeve is 65 mm long and the carrier is 35 mm tall.
4. Confirm that the positive terminal is still visible and the cell remains inside the sleeve.

Tell me: does the sleeve extend about 15 mm beyond both ends, or is one side longer than the other?

#### You said:

approx same

#### ChatGPT said:

Good. The cell, PCM sleeve, and carrier are now positioned correctly for our preliminary assembly.

### Next step: Save the assembly

1. Press Ctrl + S.
2. Make sure the assembly is saved as VentSense_Cell_Assembly.SLDASM.
3. If SolidWorks asks you to save modified part files too, click Save All.

This preserves the mates and component positions before we continue.

Tell me when it’s saved.

ChatGPT can make mistakes. Check important info.

#### Latest response

Think

To pick up a draggable item, press the space bar. While dragging, use the arrow keys to move the item. Press space again to drop the item in its new position, or press escape to cancel.

To pick up a draggable item, press the space bar. While dragging, use the arrow keys to move the item. Press space again to drop the item in its new position, or press escape to cancel.

Response complete

## Create VentSense CAD Workflow
