Aryan-swag/VentSense/ventsense_cad/ventsense_cell_assembly.png

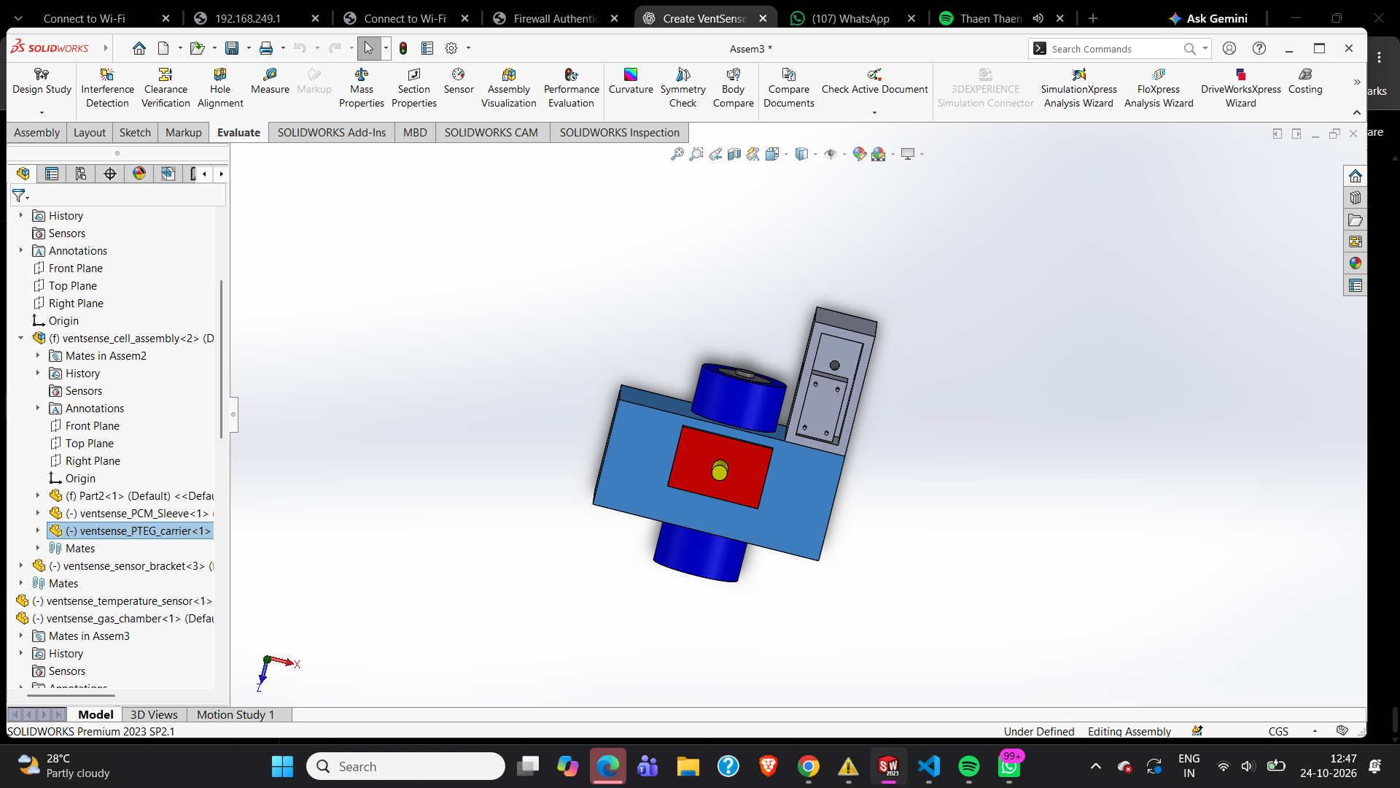
ventsense_cad/ventsense_cell_assembly.png
