Aryan-swag/VentSense/ventsense_cad/ventsense_full_assembly_exploded-VS_wax_thermalstudy/ventsense_full_assembly_exploded-VS_wax_thermalstudy-Results-Thermal3.analysis.png

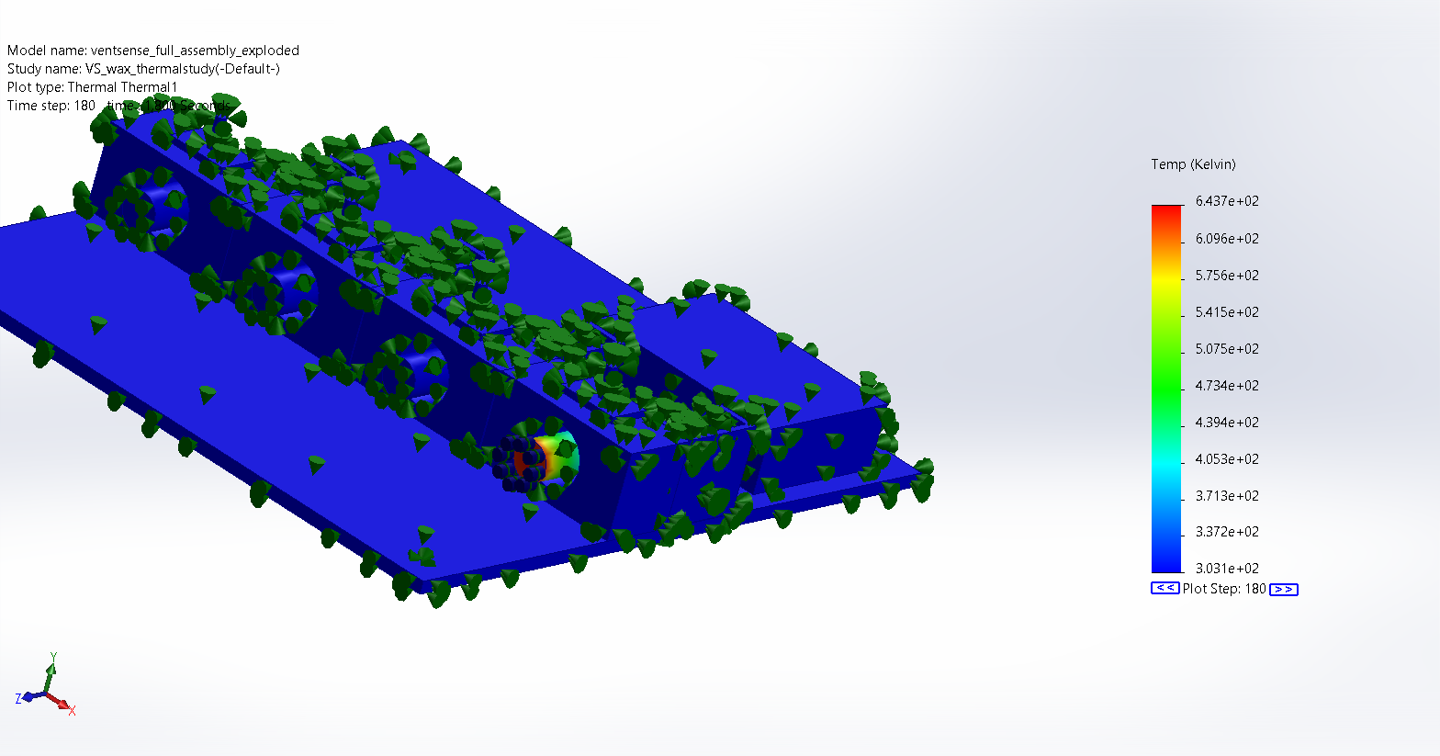
ventsense_cad/ventsense_full_assembly_exploded-VS_wax_thermalstudy/ventsense_full_assembly_exploded-VS_wax_thermalstudy-Results-Thermal3.analysis.png
