Aryan-swag/VentSense/ventsense_cad/PerformanceLog.txt

Number of Contacts: 44
Number of contact data: 4216
