Aryan-swag/VentSense/exports/VS_schematic.pdf

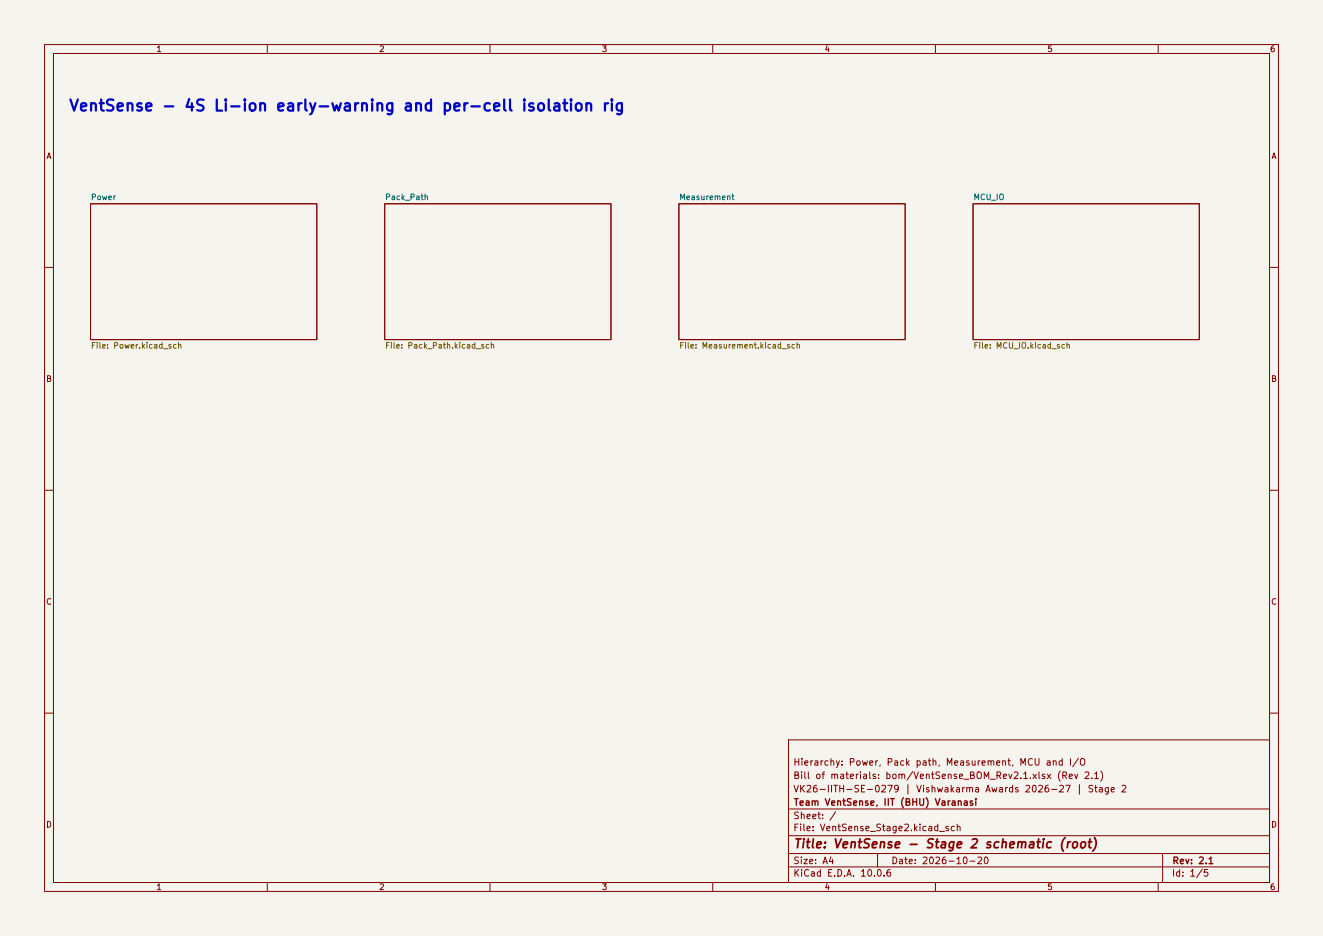
[picture p50: page 1]

File: Pack_Path.kicad_sch VentSense - 4S Li-ion early-warning and per-cell isolation rig

Hierarchy: Power, Pack path, Measurement, MCU and I/O
Bill of materials: bom/VentSense_BOM_Rev2.1.xlsx (Rev 2.1)
VK26-IITH-SE-0279 | Vishwakarma Awards 2026-27 | Stage 2
Team VentSense, IIT (BHU) Varanasi
Sheet: /
File: VentSense_Stage2.kicad_sch
Title: VentSense - Stage 2 schematic (root)

Size: A4 | Rev: 2.1
KiCad E.D.A. 10.0.6 | Id: 1/5

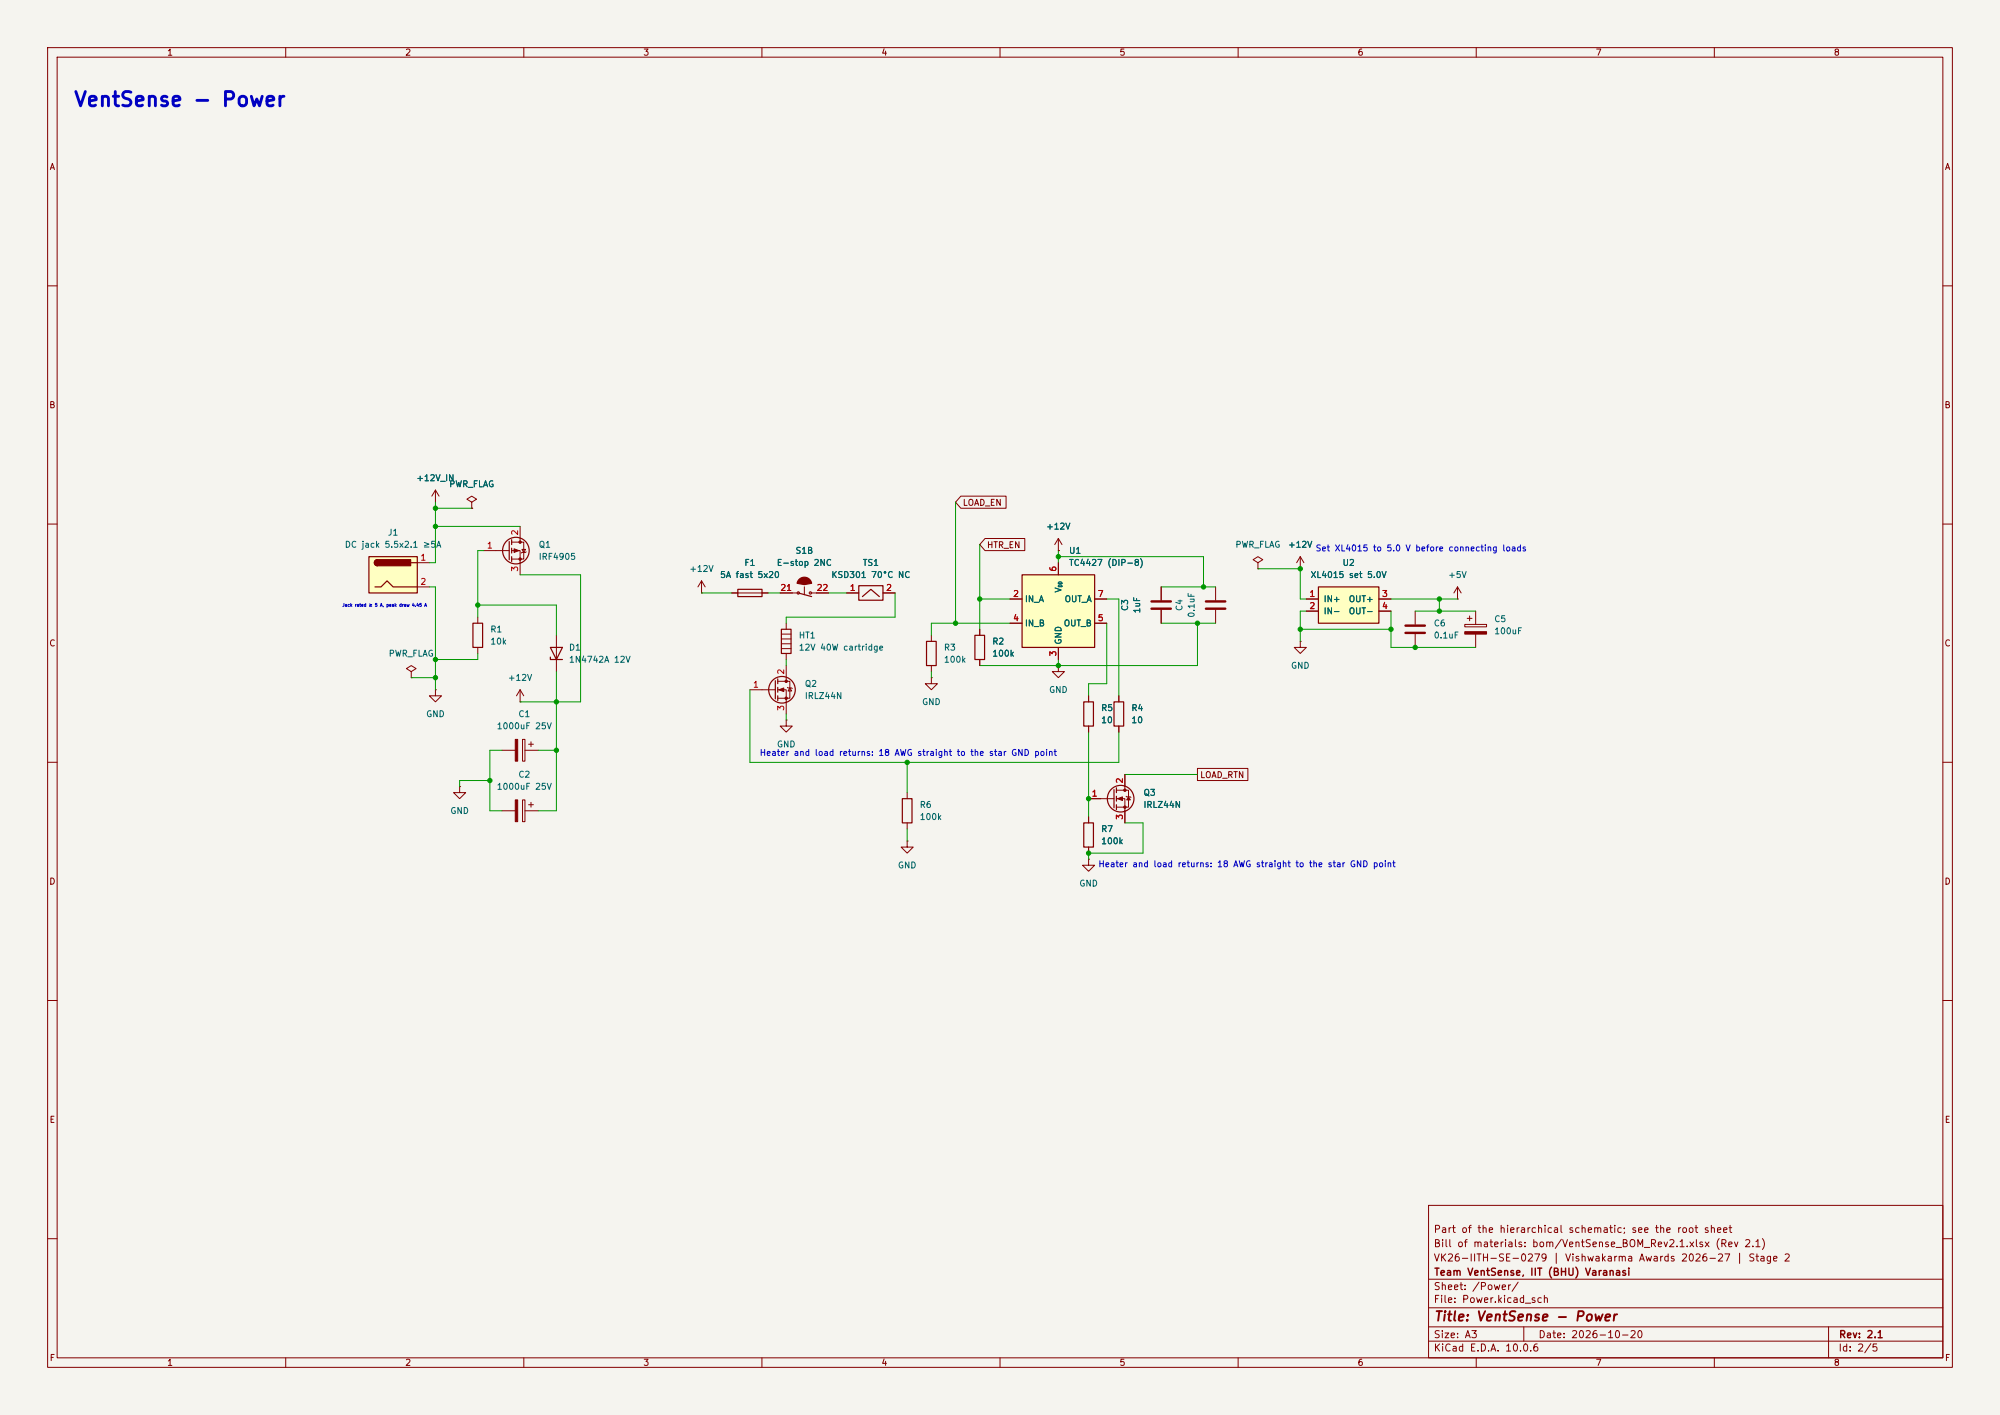
[picture p51: page 2]

Heater and load returns: 18 AWG straight to the star GND point

Part of the hierarchical schematic; see the root sheet
Bill of materials: bom/VentSense_BOM_Rev2.1.xlsx (Rev 2.1)
VK26-IITH-SE-0279 | Vishwakarma Awards 2026-27 | Stage 2
Team VentSense, IIT (BHU) Varanasi
Sheet: /Power/
File: Power.kicad_sch
Title: VentSense - Power

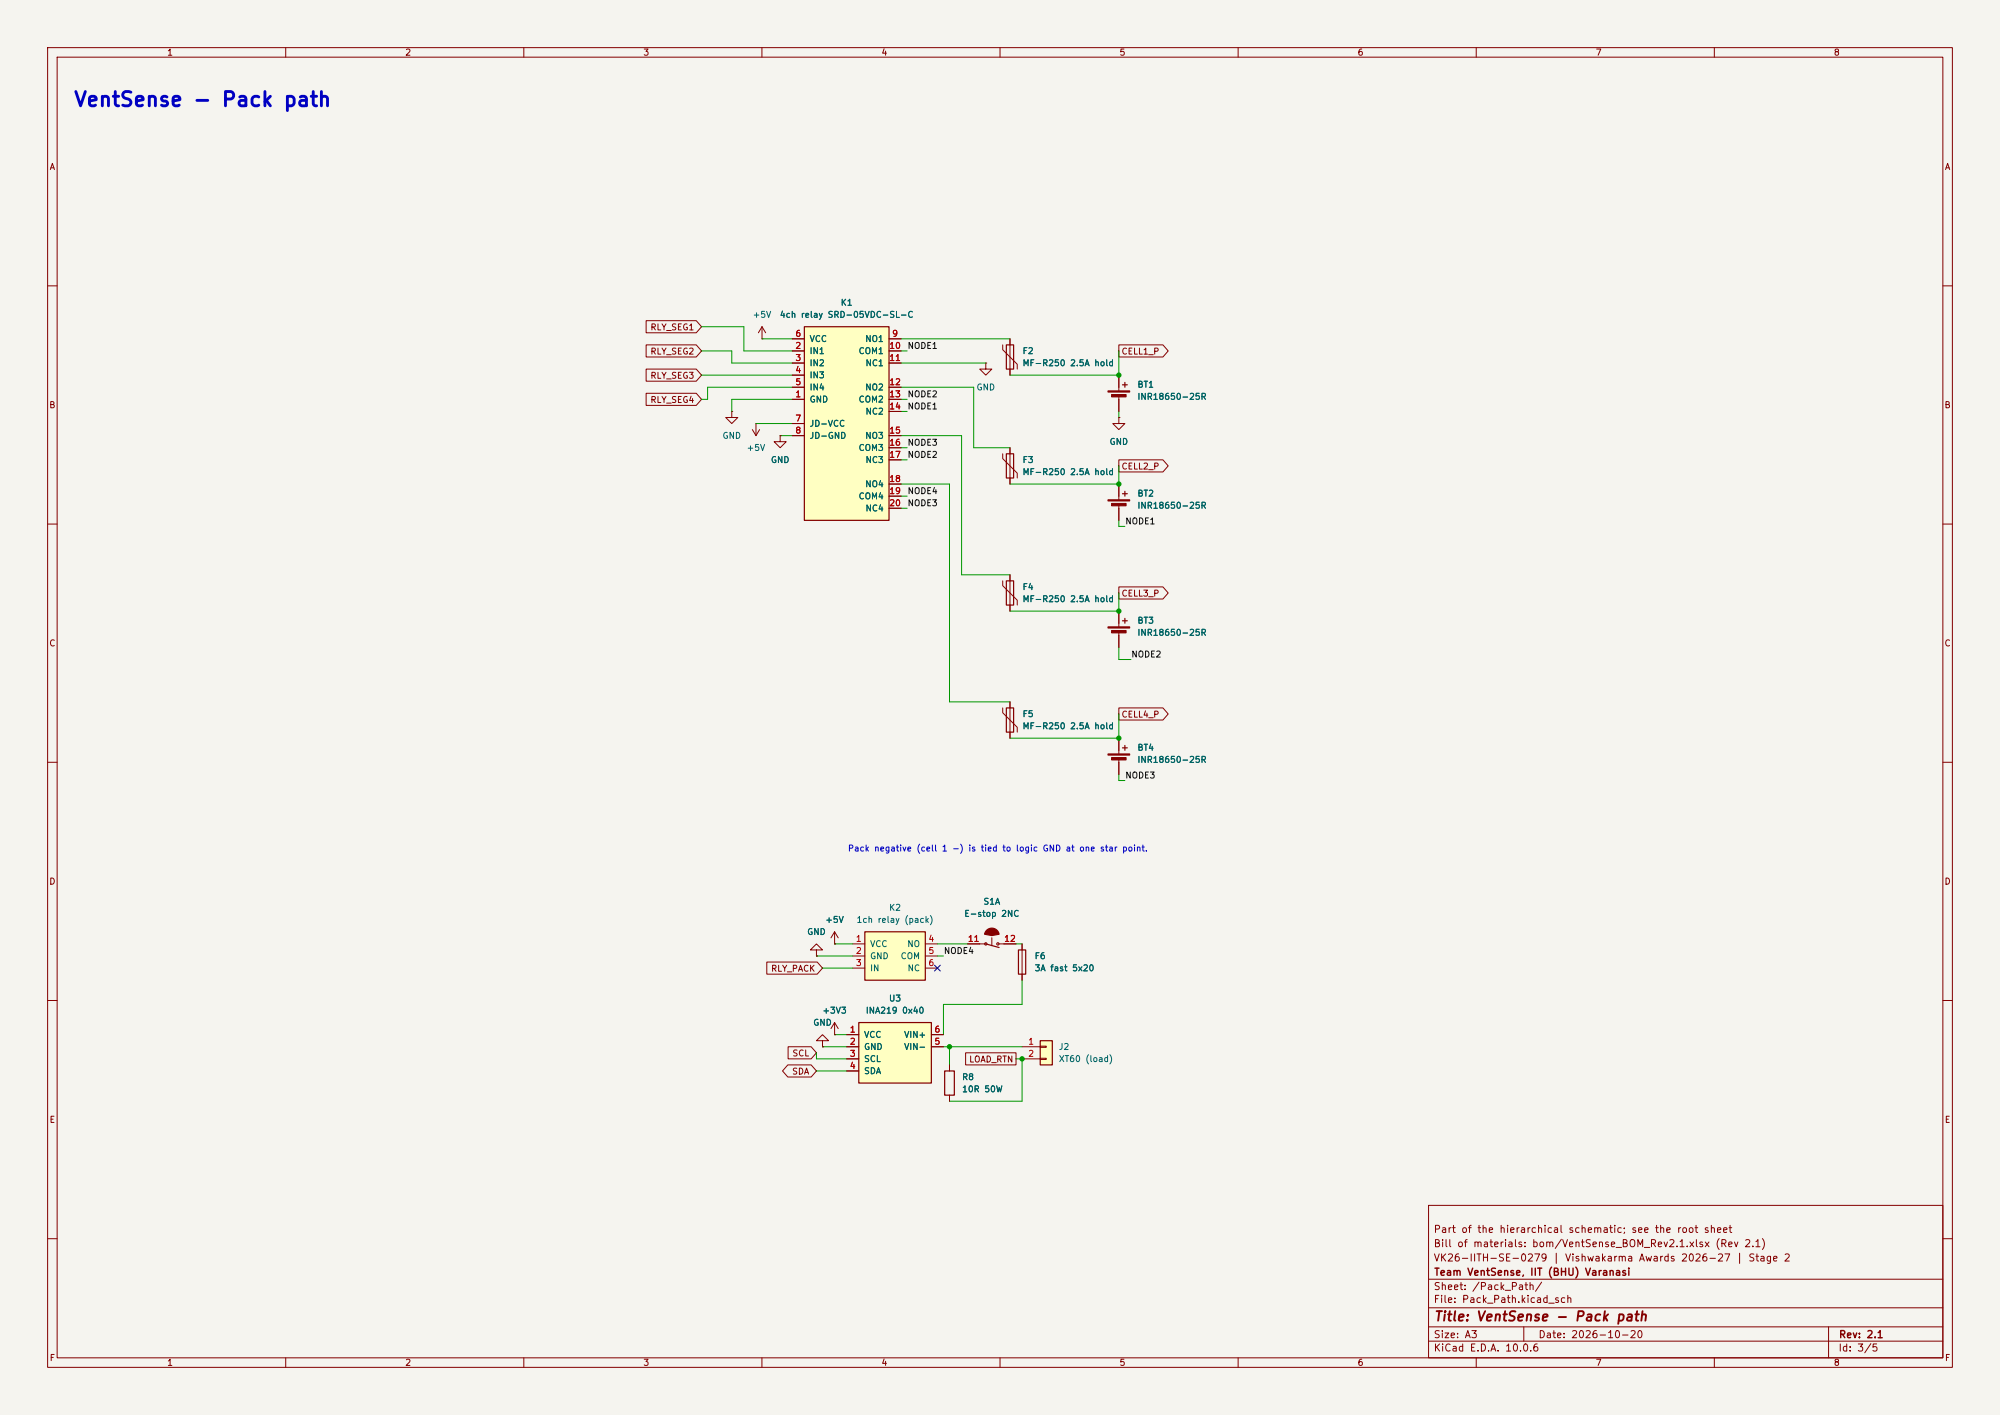
[picture p52: page 3]

4ch relay SRD-05VDC-SL-C +5V GND

Pack negative (cell 1 −) is tied to logic GND at one star point.

Part of the hierarchical schematic; see the root sheet +3V3

Bill of materials: bom/VentSense_BOM_Rev2.1.xlsx (Rev 2.1)
VK26-IITH-SE-0279 | Vishwakarma Awards 2026-27 | Stage 2
Team VentSense, IIT (BHU) Varanasi
Sheet: /Pack_Path/
File: Pack_Path.kicad_sch
Title: VentSense - Pack path

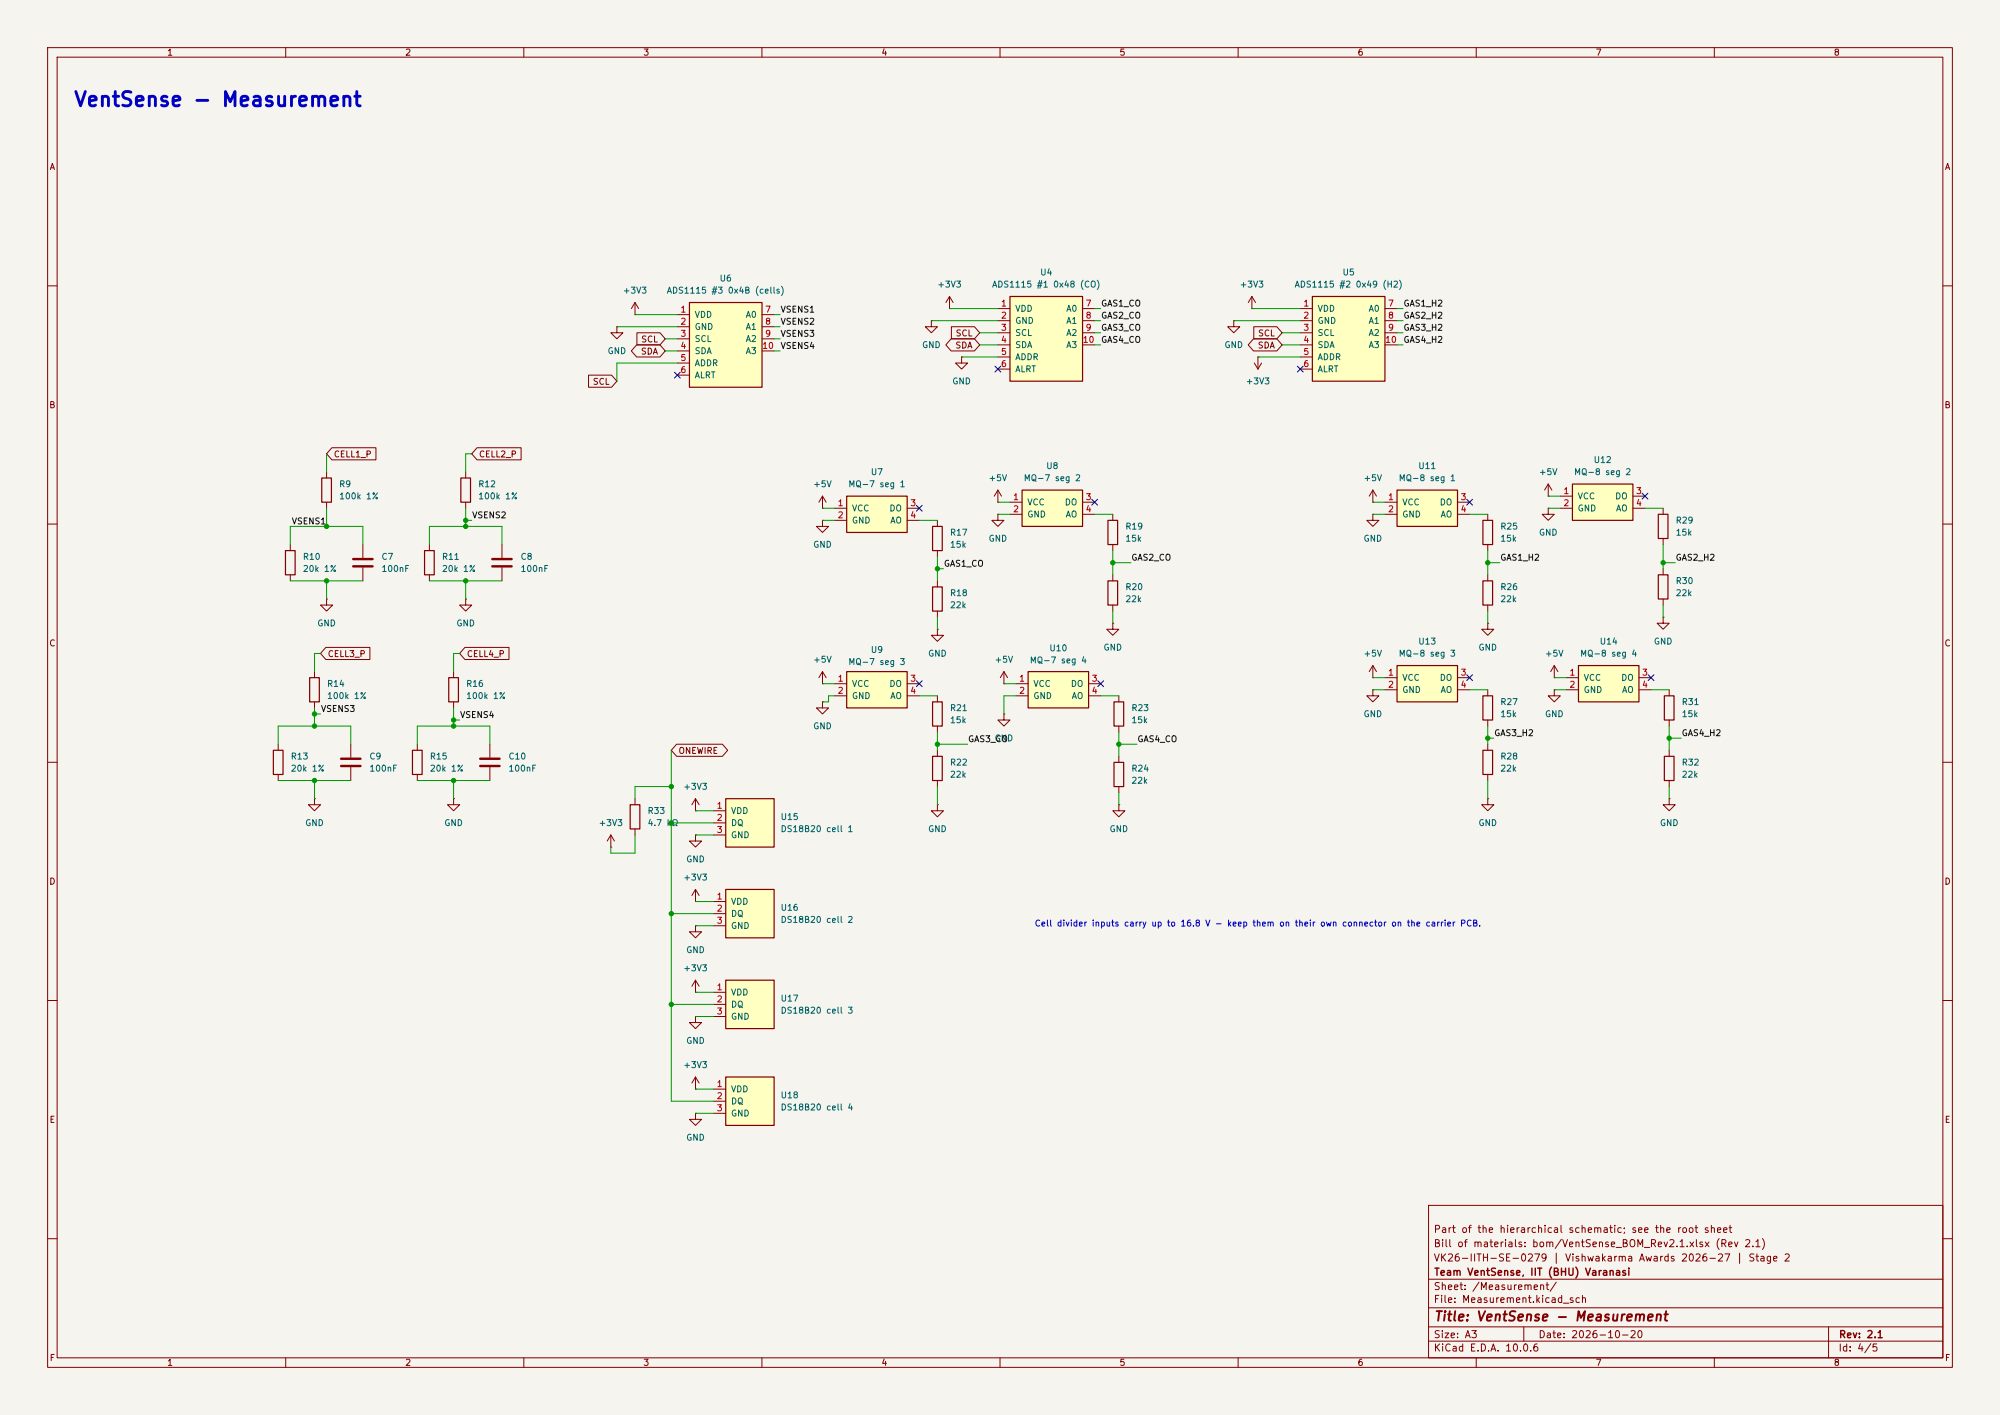
[picture p53: page 4]

Cell divider inputs carry up to 16.8 V - keep them on their own connector on the carrier PCB.

Part of the hierarchical schematic; see the root sheet
Bill of materials: bom/VentSense_BOM_Rev2.1.xlsx (Rev 2.1)
VK26-IITH-SE-0279 | Vishwakarma Awards 2026-27 | Stage 2
Team VentSense, IIT (BHU) Varanasi
Sheet: /Measurement/
File: Measurement.kicad_sch
Title: VentSense - Measurement

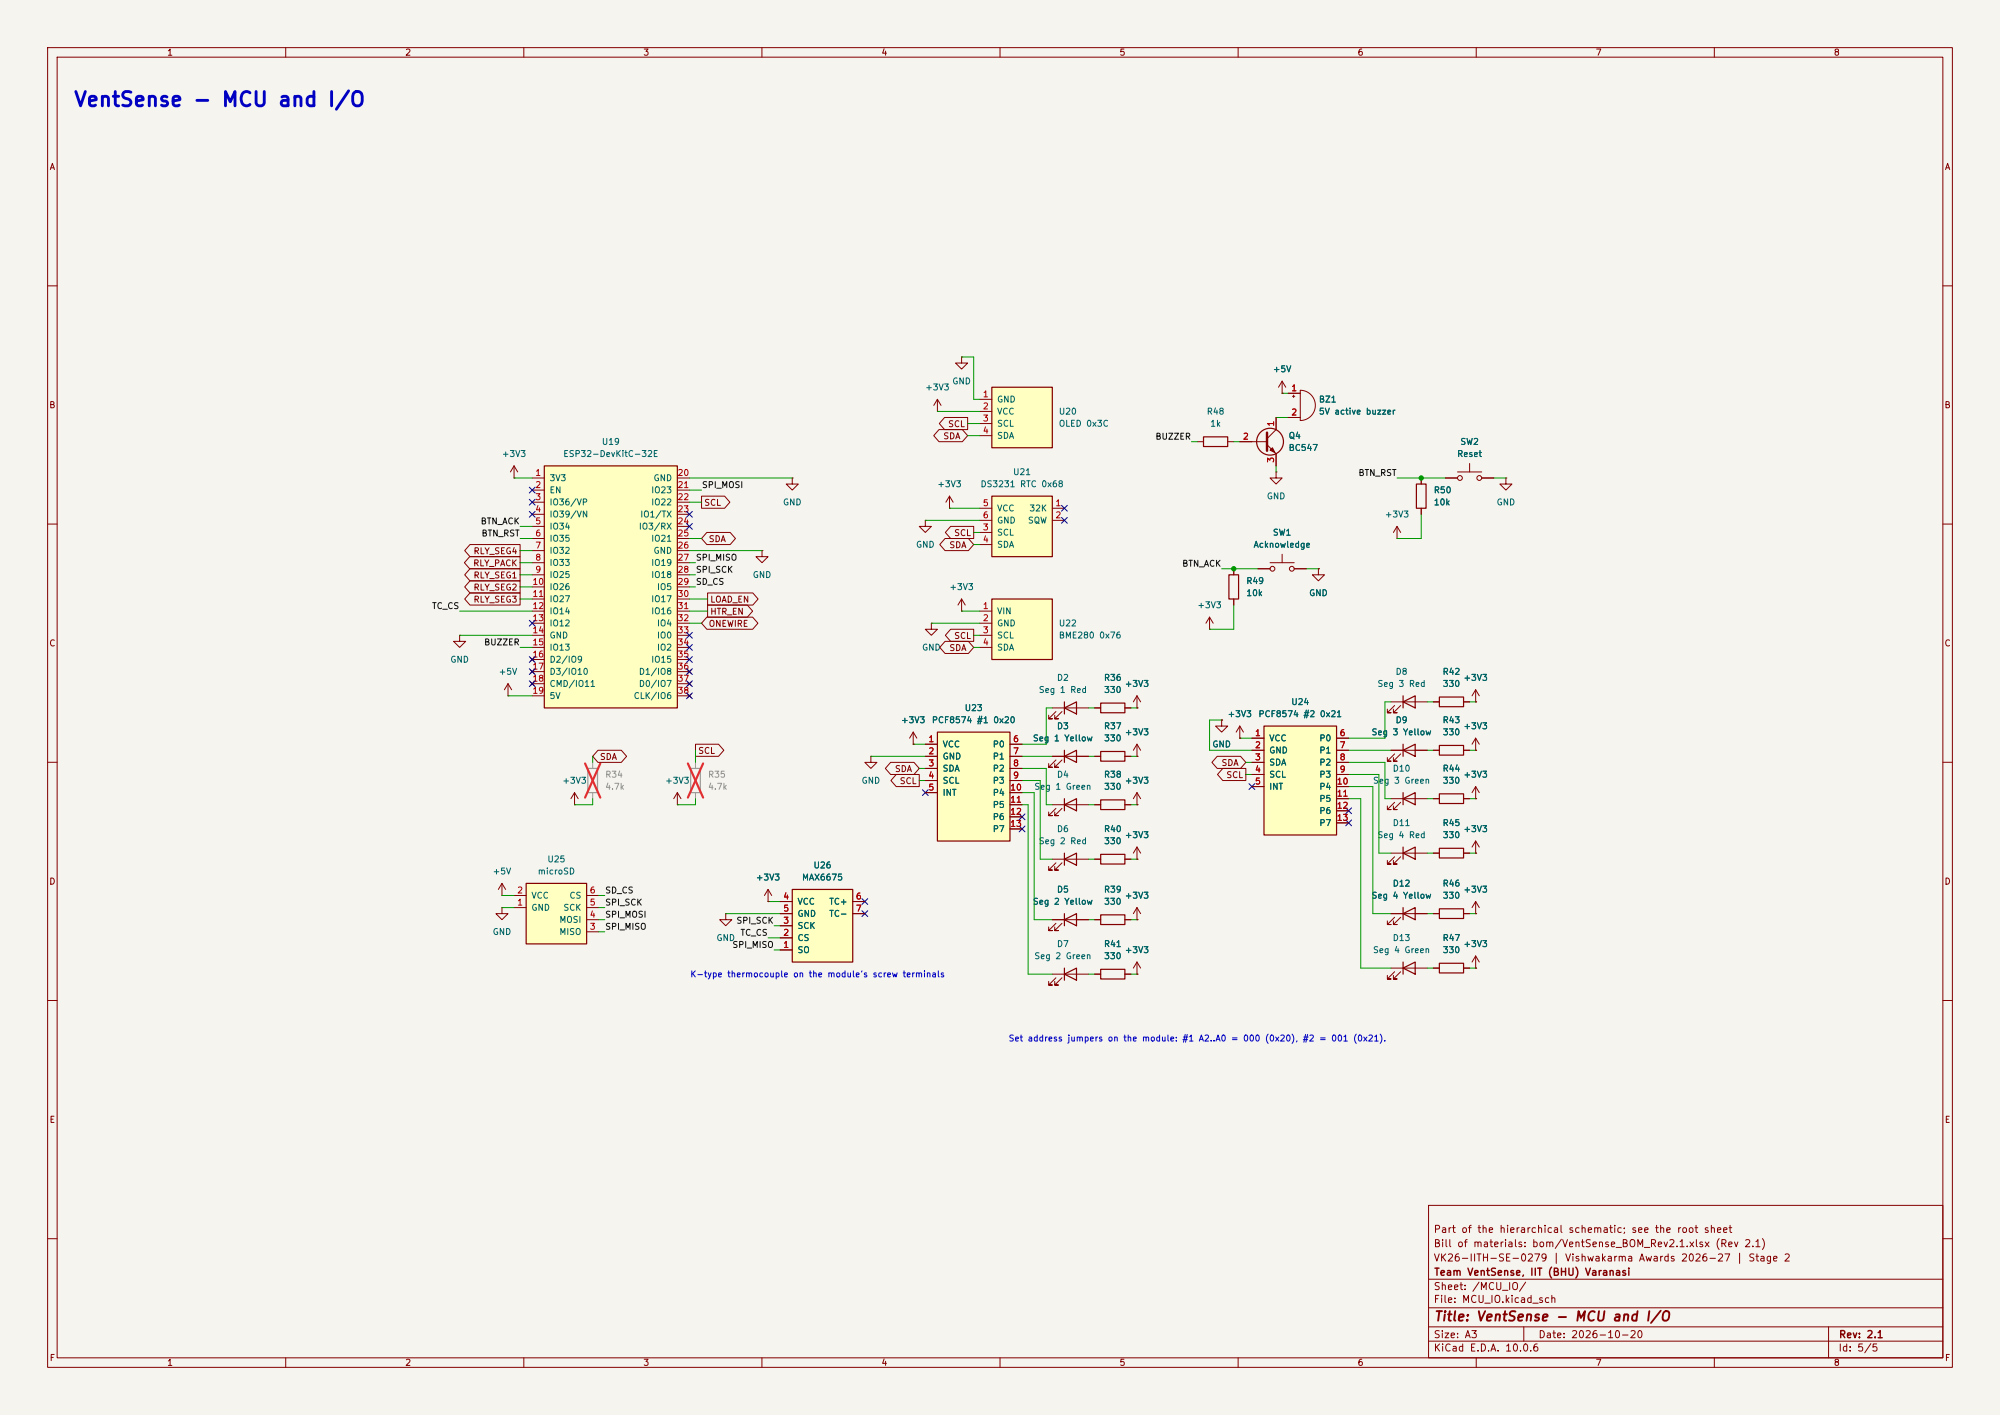
[picture p54: page 5]

Part of the hierarchical schematic; see the root sheet
Bill of materials: bom/VentSense_BOM_Rev2.1.xlsx (Rev 2.1)
VK26-IITH-SE-0279 | Vishwakarma Awards 2026-27 | Stage 2
Team VentSense, IIT (BHU) Varanasi
Sheet: /MCU_IO/
File: MCU_IO.kicad_sch
Title: VentSense - MCU and I/O
