Aryan-swag/VentSense/PCB/docs/VS_schematic_v1.1.pdf

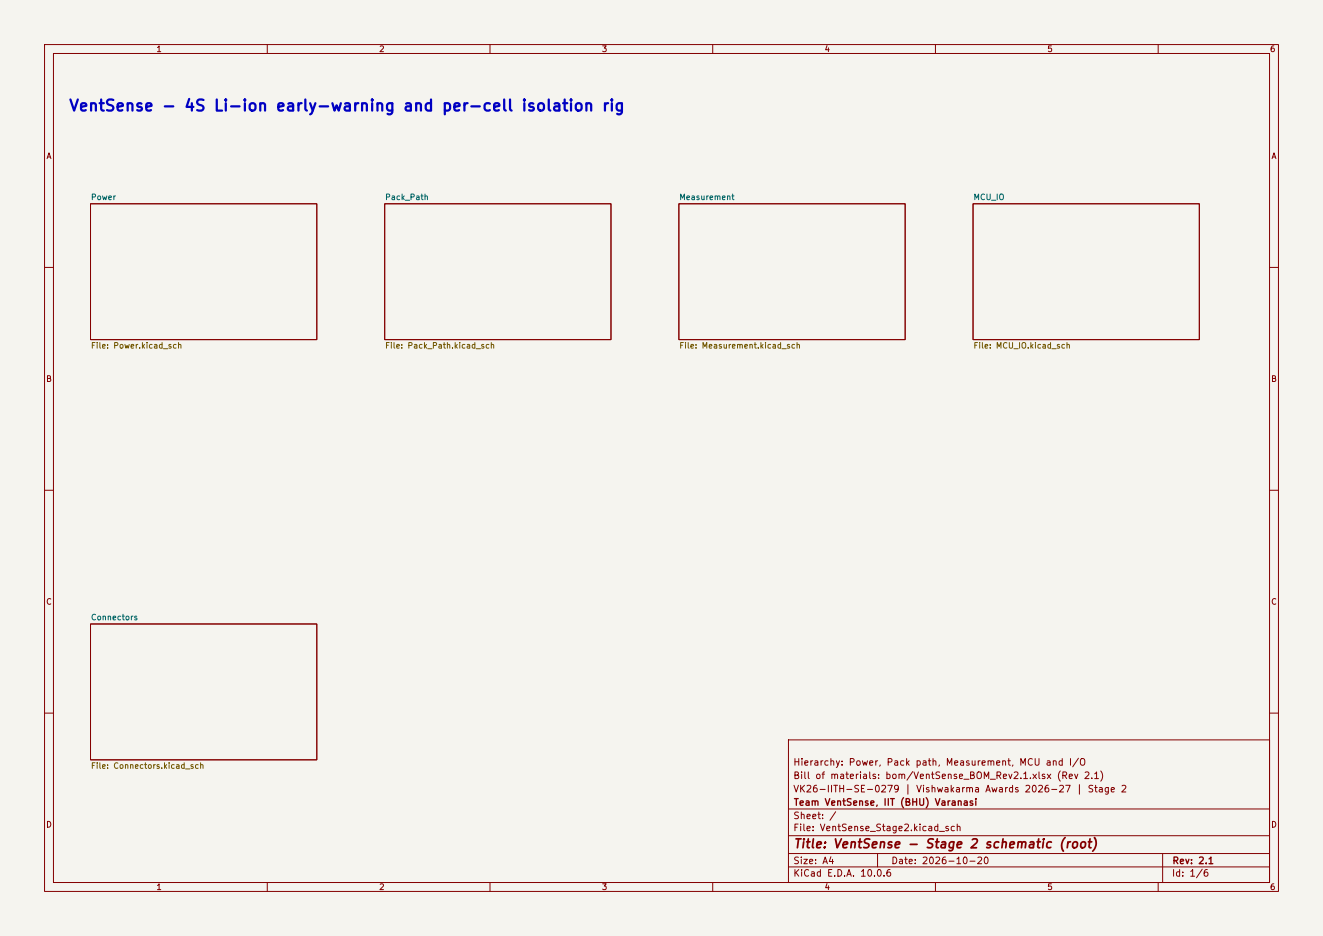
[picture p55: page 1]

Power File: Power.kicad_sch Connectors File: Connectors.kicad_sch

File: Pack_Path.kicad_sch VentSense - 4S Li-ion early-warning and per-cell isolation rig

Hierarchy: Power, Pack path, Measurement, MCU and I/O
Bill of materials: bom/VentSense_BOM_Rev2.1.xlsx (Rev 2.1)
VK26-IITH-SE-0279 | Vishwakarma Awards 2026-27 | Stage 2
Team VentSense, IIT (BHU) Varanasi
Sheet: /
File: VentSense_Stage2.kicad_sch
Title: VentSense - Stage 2 schematic (root)

Size: A4 | Rev: 2.1
KiCad E.D.A. 10.0.6 | Id: 1/6

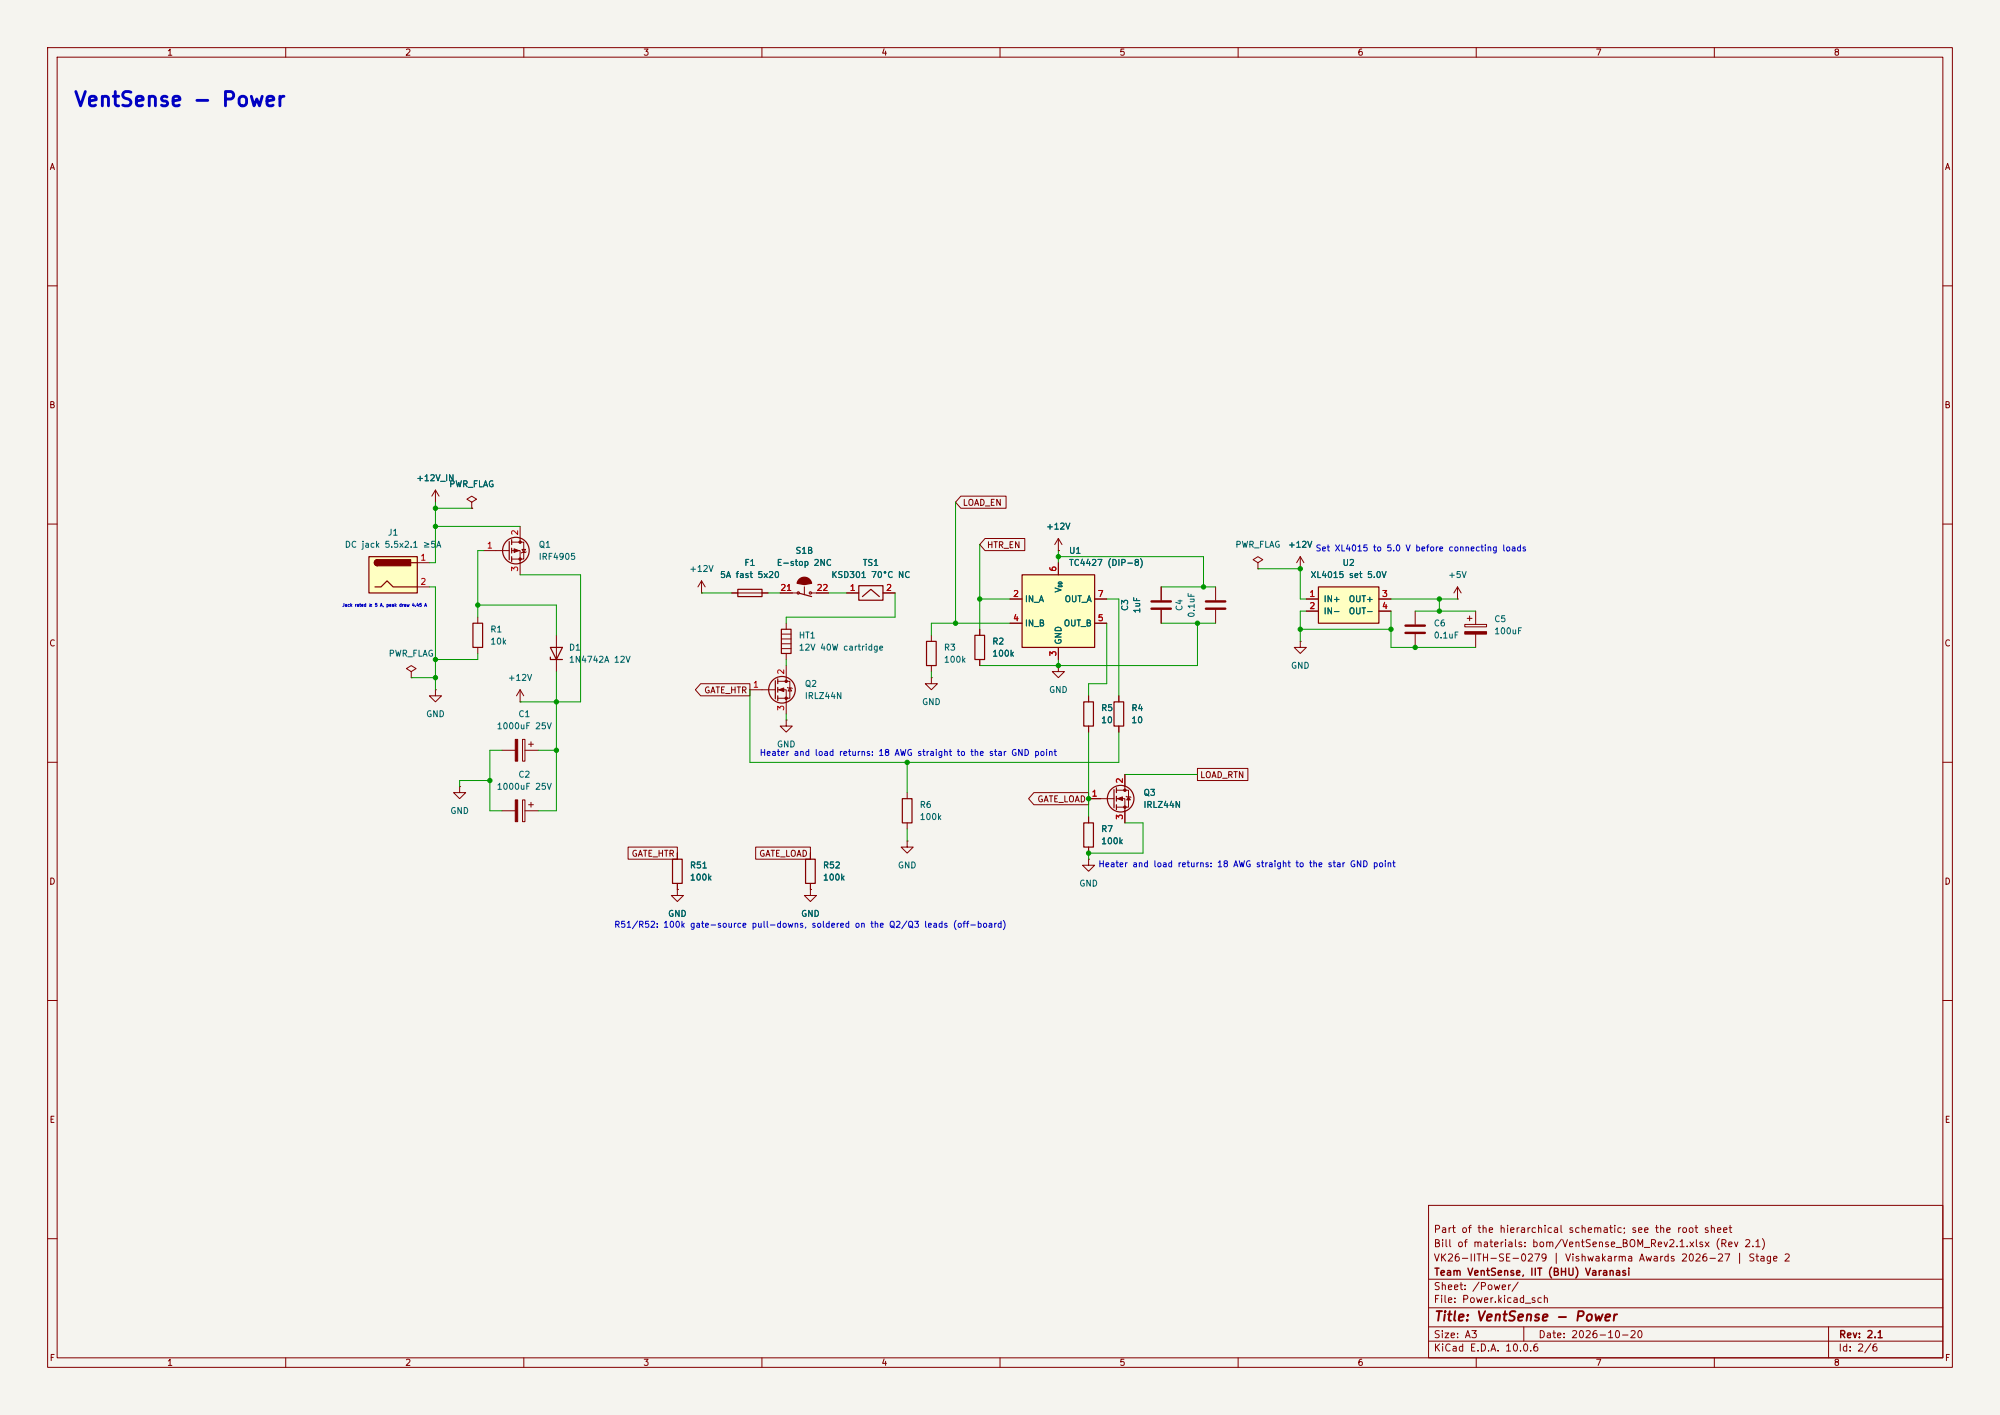
[picture p56: page 2]

Set XL4015 to 5.0 V before connecting loads Heater and load returns: 18 AWG straight to the star GND point
E-stop 2NC

R51/R52: 100k gate-source pull-downs, soldered on the Q2/Q3 leads (off-board)

Part of the hierarchical schematic; see the root sheet
Bill of materials: bom/VentSense_BOM_Rev2.1.xlsx (Rev 2.1)
VK26-IITH-SE-0279 | Vishwakarma Awards 2026-27 | Stage 2
Team VentSense, IIT (BHU) Varanasi
Sheet: /Power/
File: Power.kicad_sch
Title: VentSense - Power

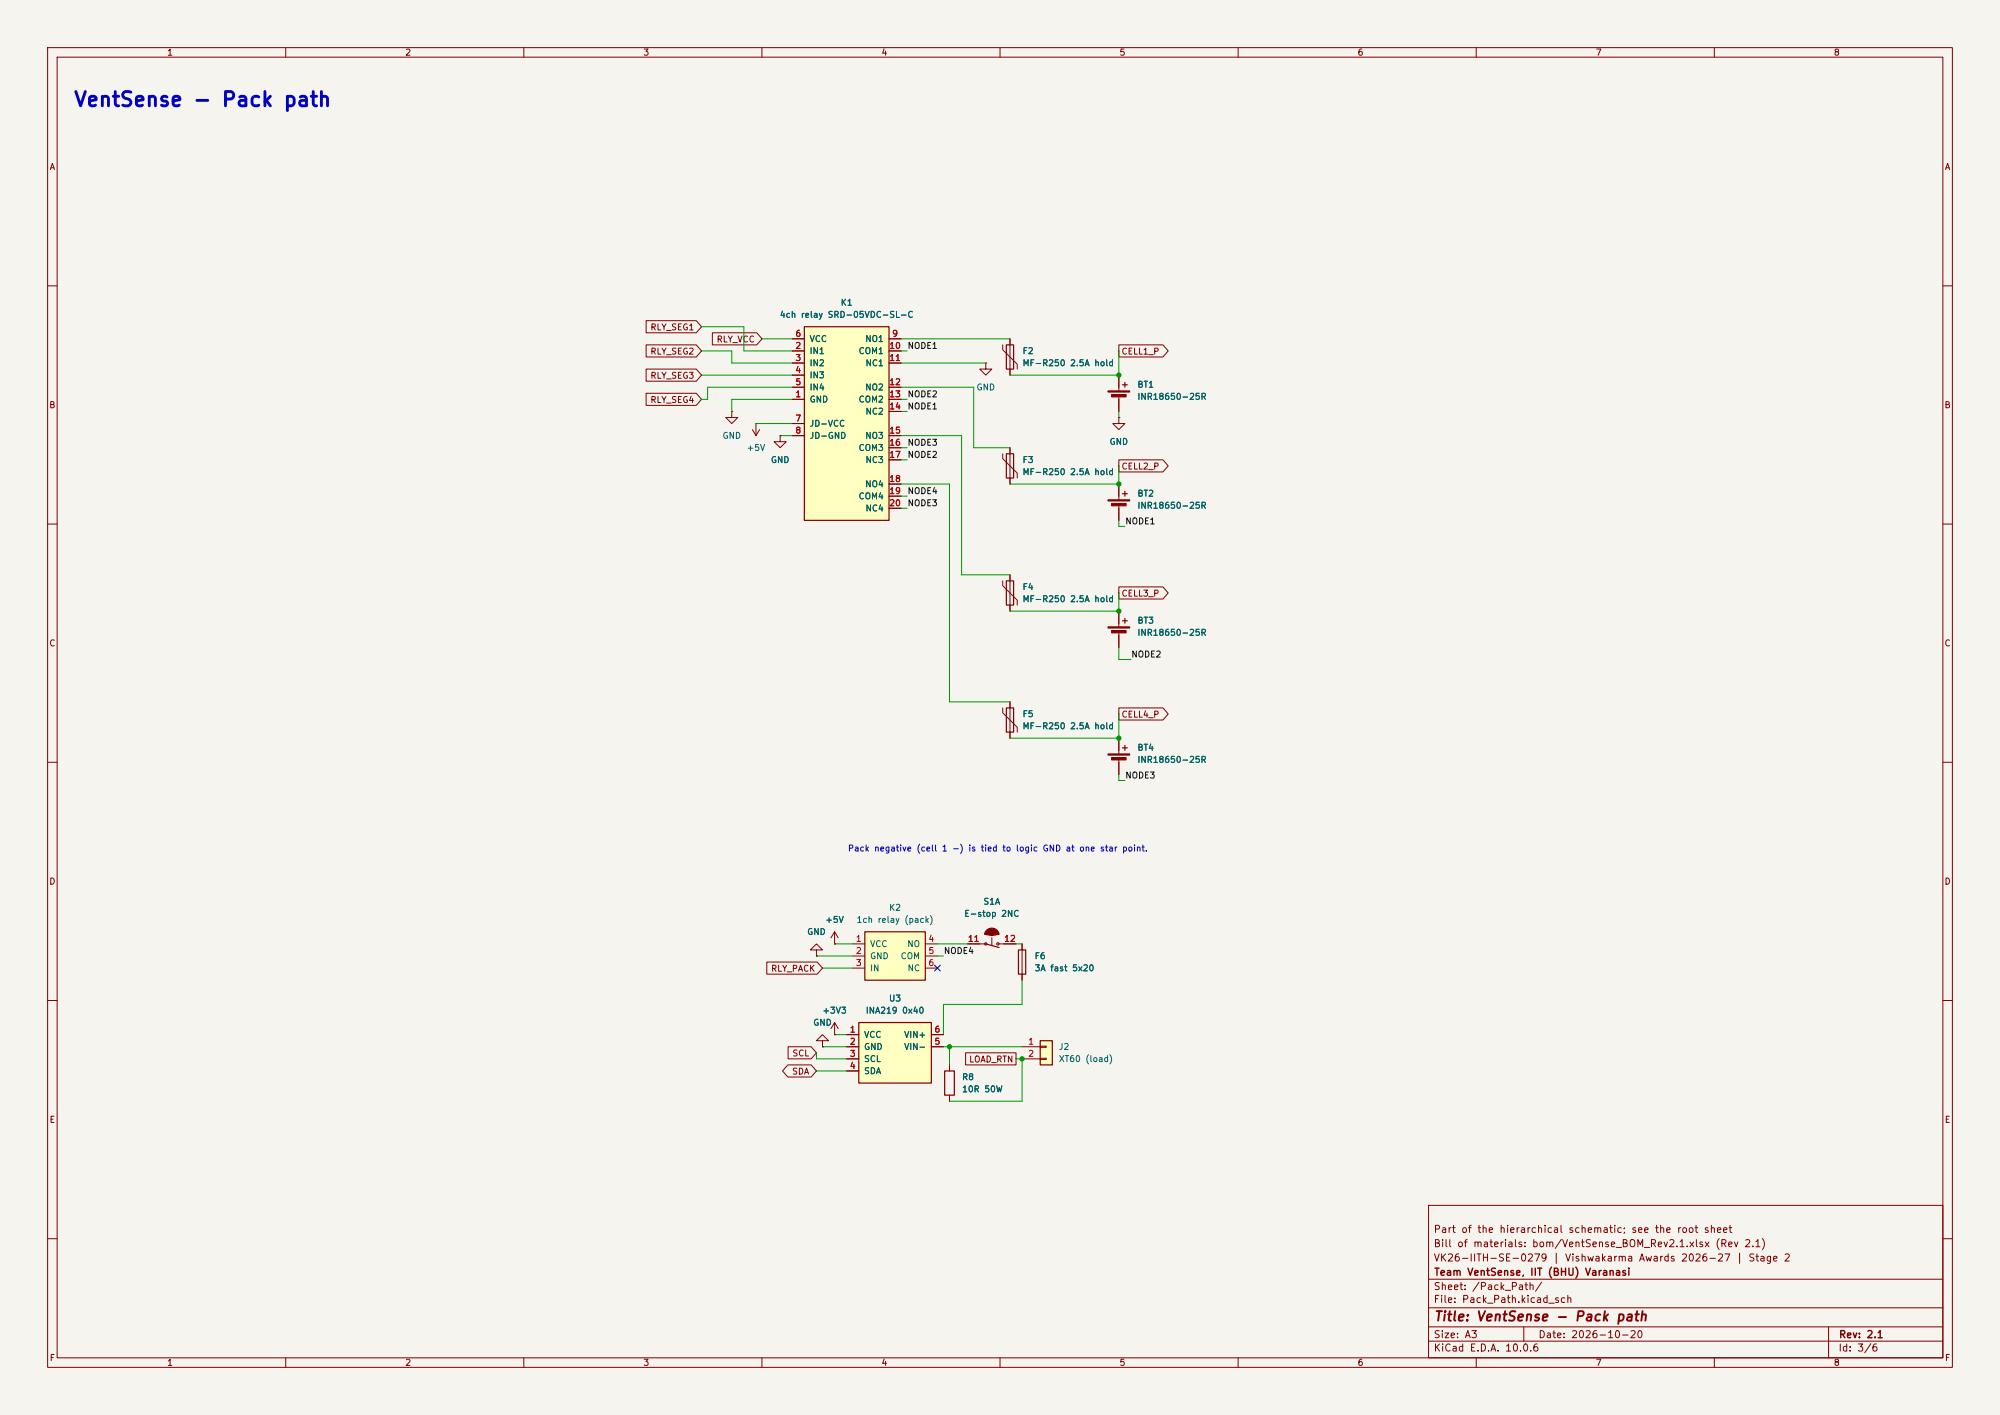
[picture p57: page 3]

Pack negative (cell 1 −) is tied to logic GND at one star point.

Part of the hierarchical schematic; see the root sheet
Bill of materials: bom/VentSense_BOM_Rev2.1.xlsx (Rev 2.1)
VK26-IITH-SE-0279 | Vishwakarma Awards 2026-27 | Stage 2
Team VentSense, IIT (BHU) Varanasi
Sheet: /Pack_Path/
File: Pack_Path.kicad_sch
Title: VentSense - Pack path

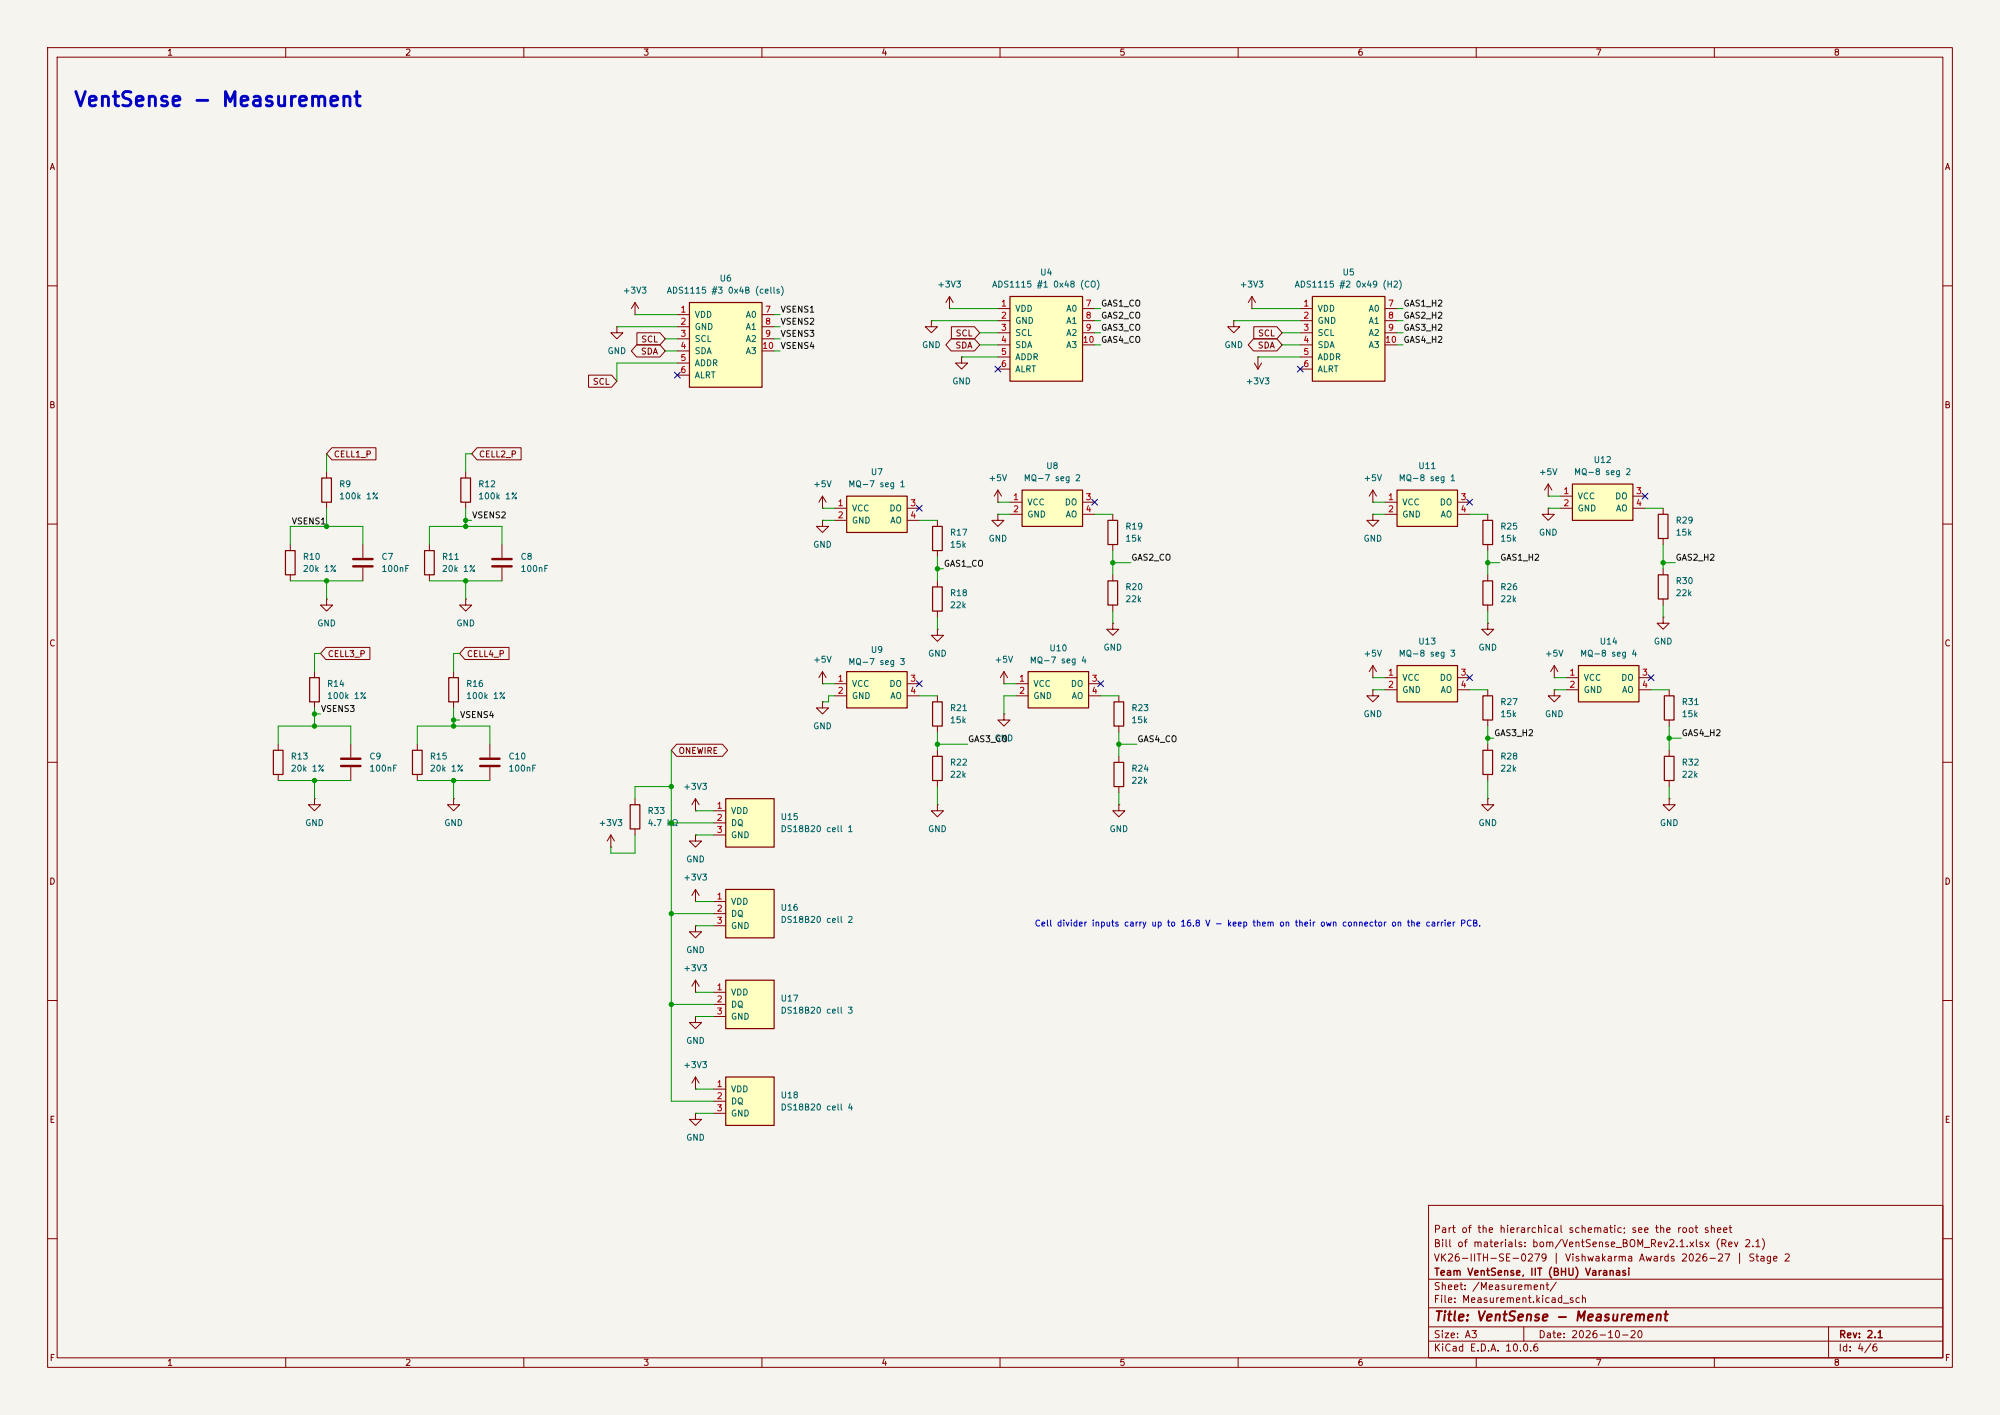
[picture p58: page 4]

Cell divider inputs carry up to 16.8 V - keep them on their own connector on the carrier PCB.

Part of the hierarchical schematic; see the root sheet
Bill of materials: bom/VentSense_BOM_Rev2.1.xlsx (Rev 2.1)
VK26-IITH-SE-0279 | Vishwakarma Awards 2026-27 | Stage 2
Team VentSense, IIT (BHU) Varanasi
Sheet: /Measurement/
File: Measurement.kicad_sch
Title: VentSense - Measurement

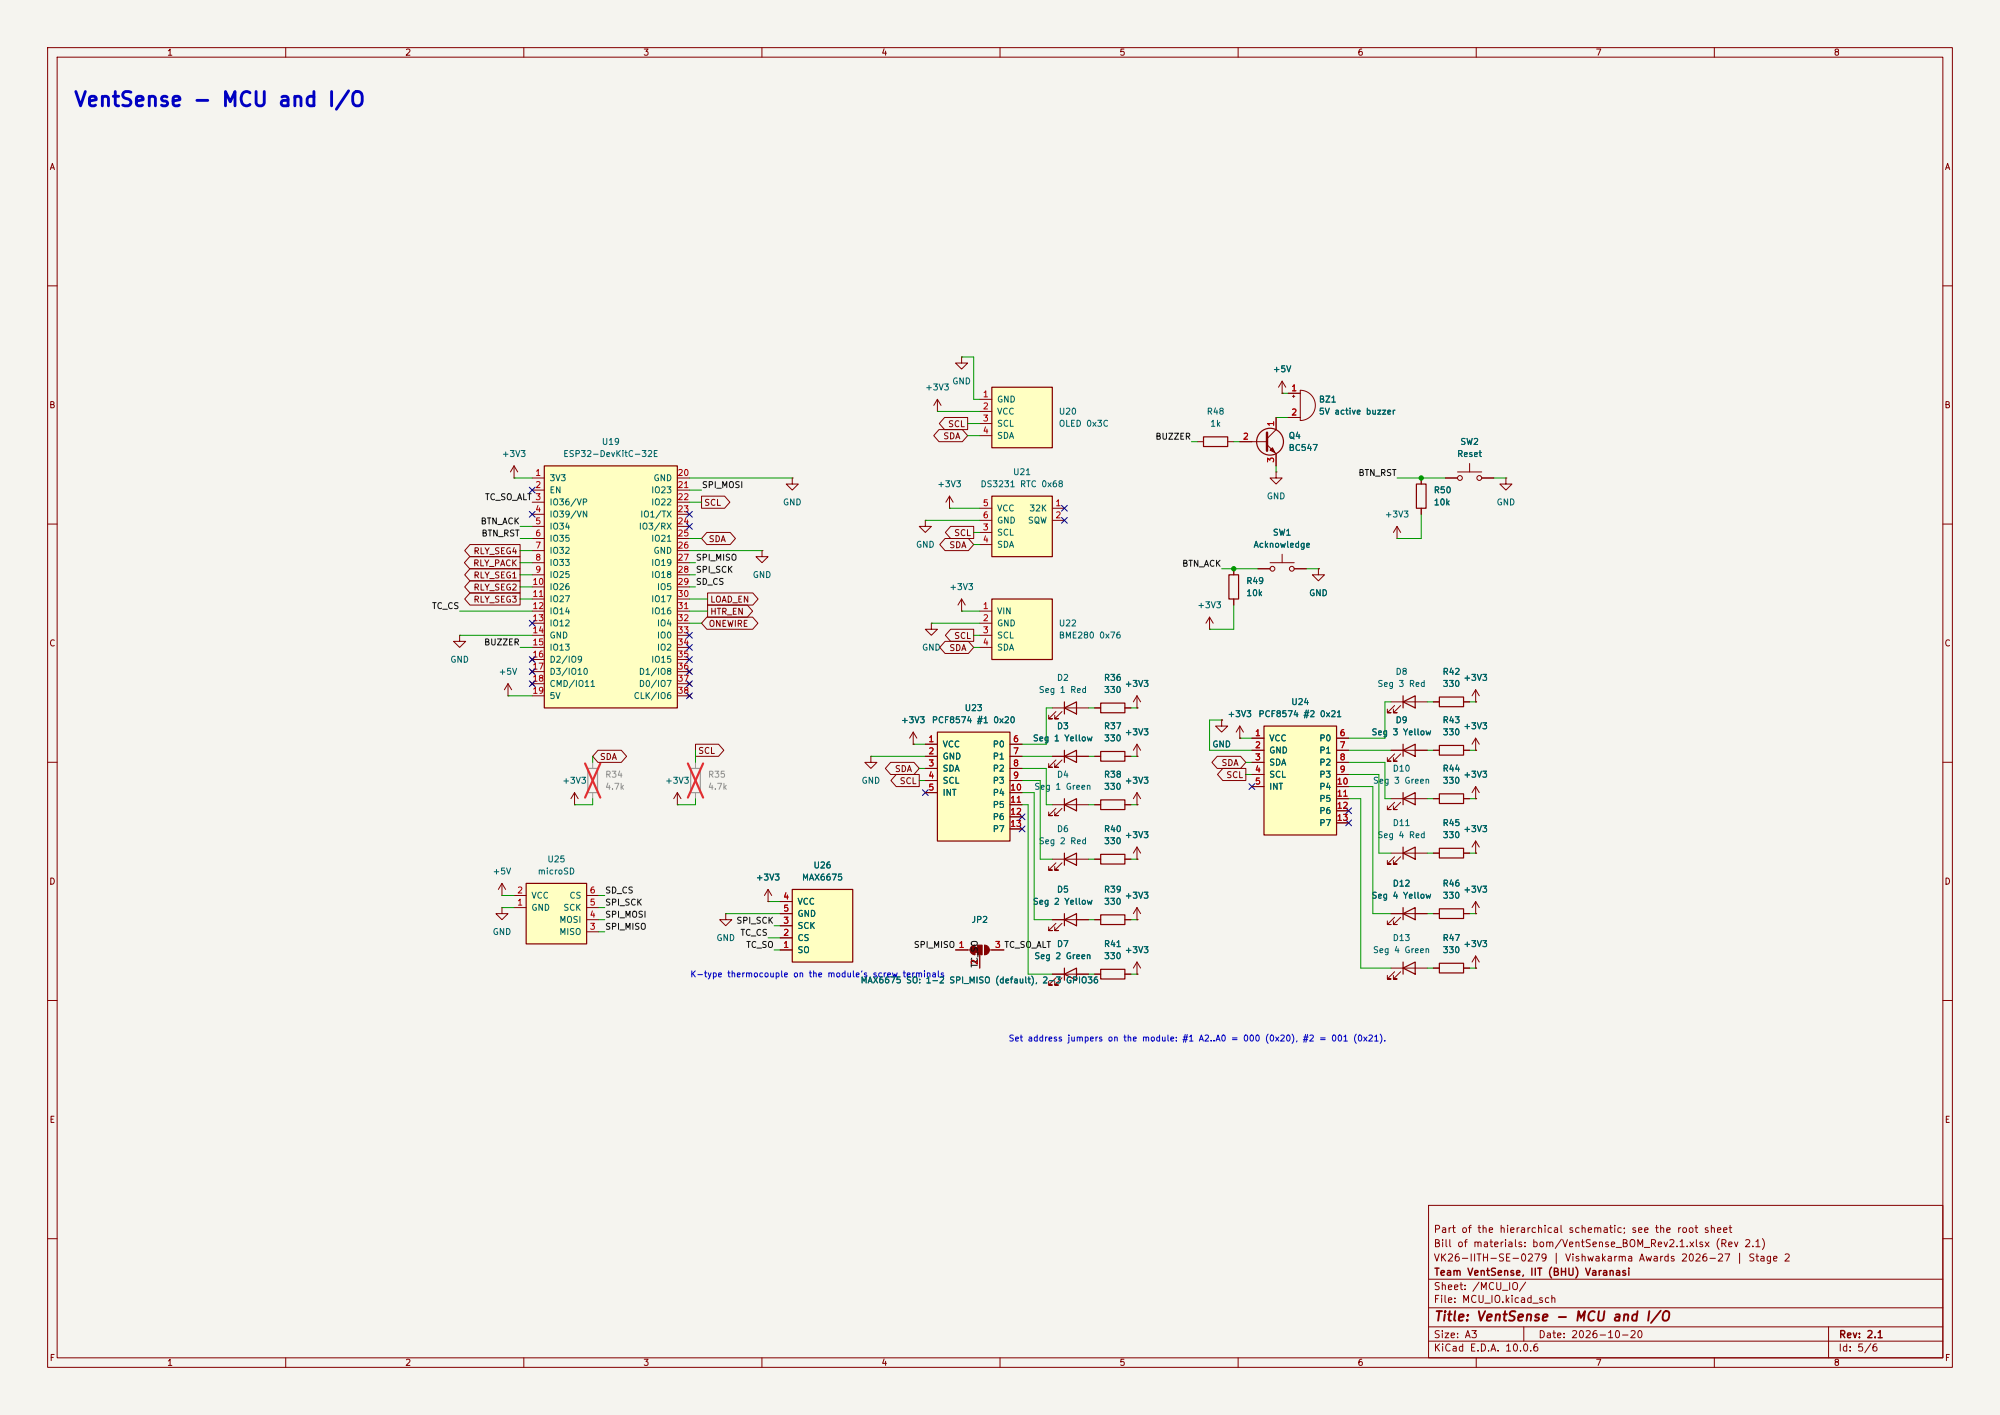
[picture p59: page 5]

Bill of materials: bom/VentSense_BOM_Rev2.1.xlsx (Rev 2.1)
VK26-IITH-SE-0279 | Vishwakarma Awards 2026-27 | Stage 2
Team VentSense, IIT (BHU) Varanasi
Sheet: /MCU_IO/
File: MCU_IO.kicad_sch
Title: VentSense - MCU and I/O

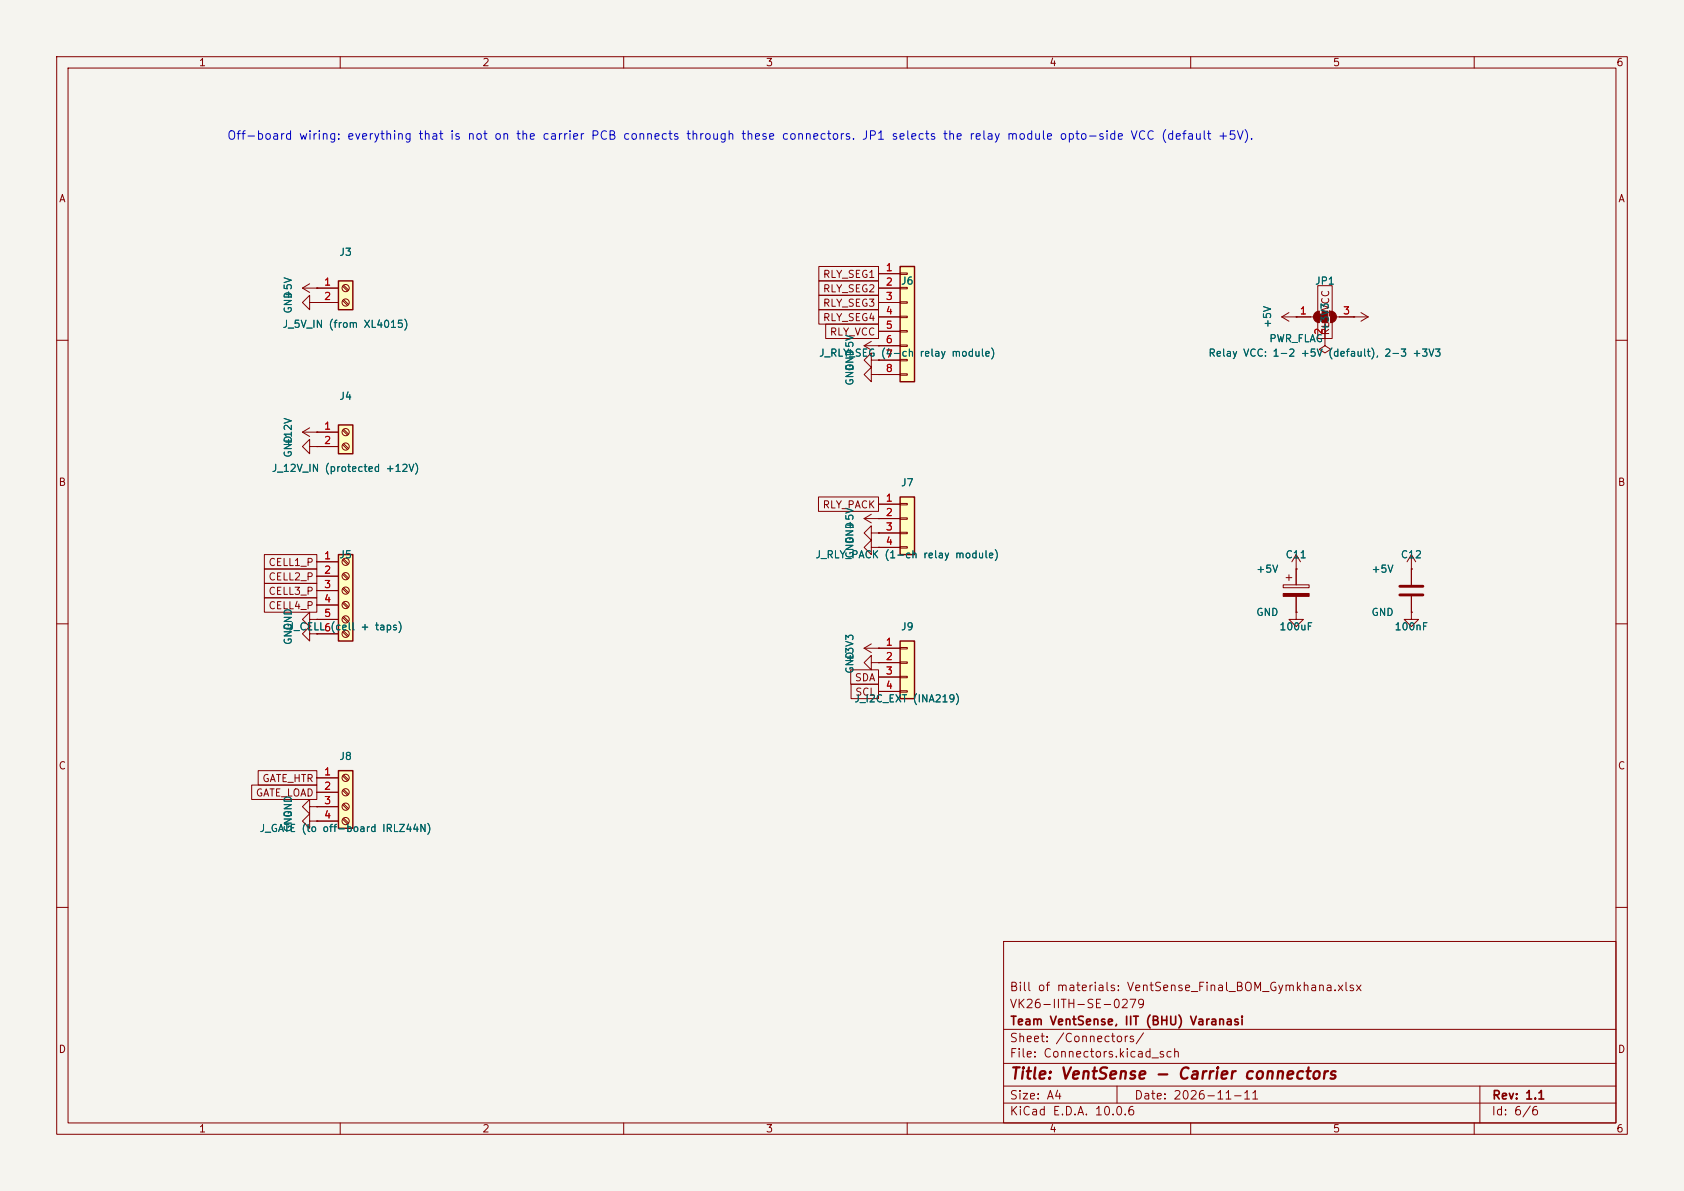
[picture p60: page 6]

RLY_SEG4 RLY_SEG3 RLY_SEG2 RLY_SEG1 Off-board wiring: everything that is not on the carrier PCB connects through these connectors. JP1 selects the relay module opto-side VCC (default +5V). J3

J_RLY_PACK (1-ch relay module) 1
GND +5V SDA RLY_PACK
J_RLY_PACK (1-ch relay module) GND

J_GATE (to off-board IRLZ44N) GND GND

Bill of materials: VentSense_Final_BOM_Gymkhana.xlsx
VK26-IITH-SE-0279
Team VentSense, IIT (BHU) Varanasi
Sheet: /Connectors/
File: Connectors.kicad_sch
Title: VentSense - Carrier connectors
