Aryan-swag/VentSense/kicad/VentSense_Stage2/VentSense_Stage2.kicad_pcb

## KiCad design kicad/VentSense_Stage2/VentSense_Stage2.kicad_pcb (2026-11-10)

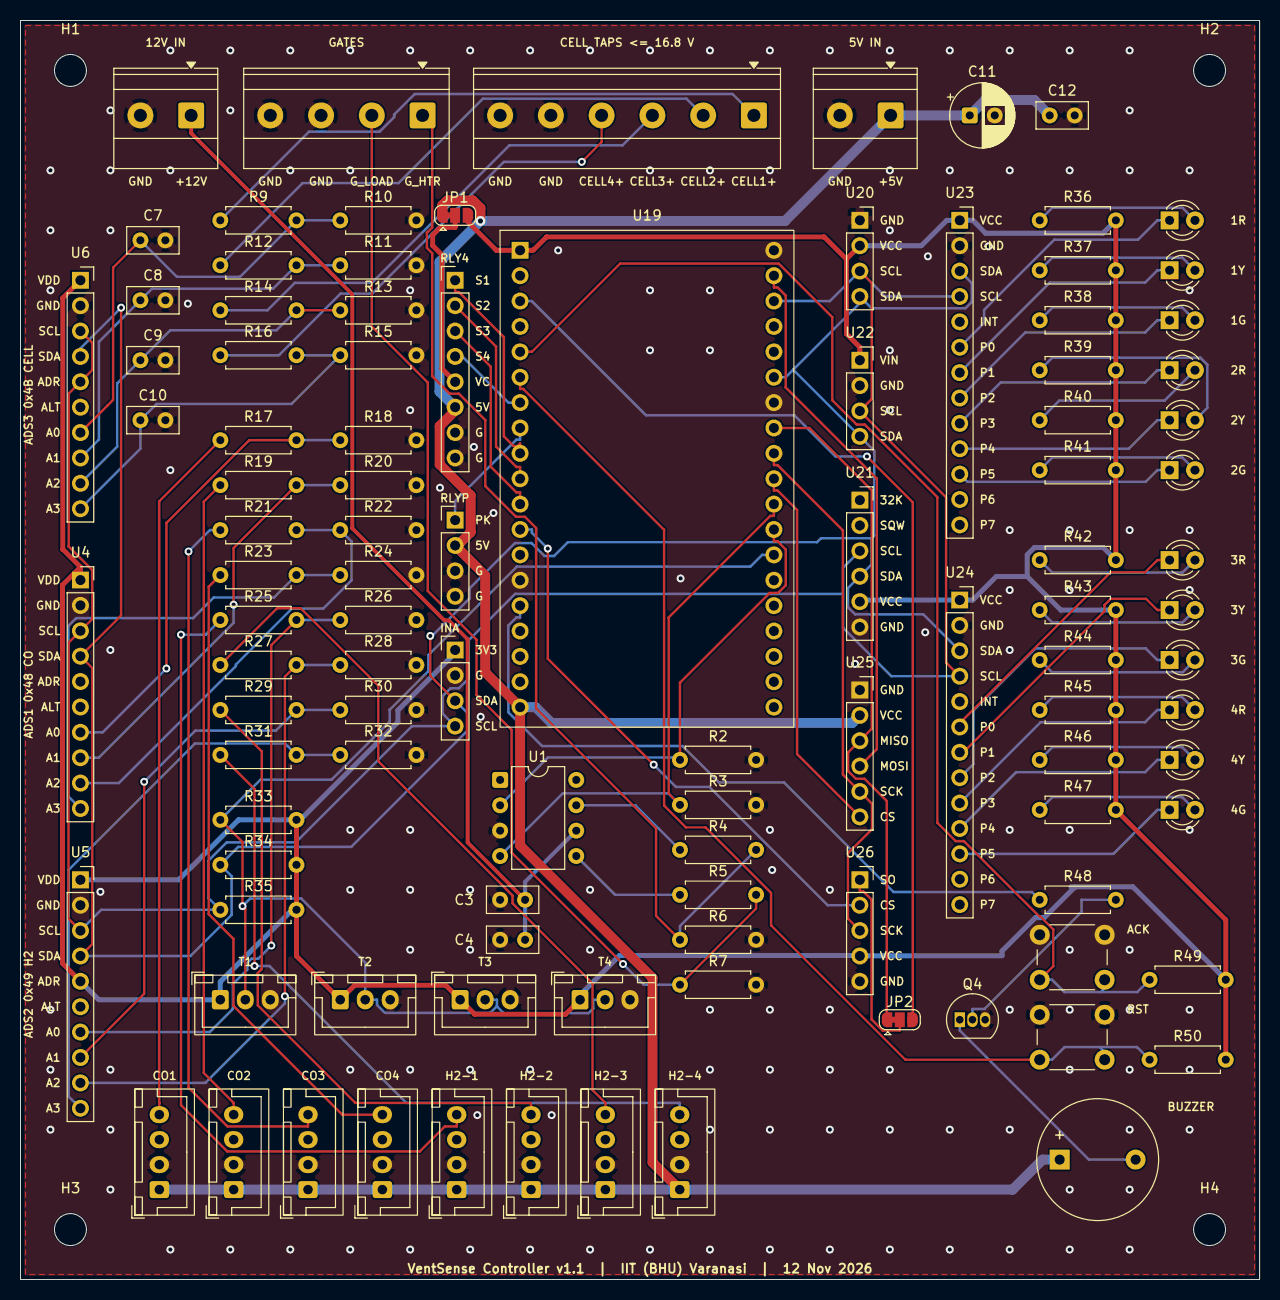
[picture p61: board VentSense_Stage2.kicad_pcb from above]

Board: 2 copper layers, 124.0 x 126.0 mm, 109 parts (0 on the bottom side), 79 nets.

Parts:
BZ1: 5V active buzzer; Buzzer_12x9.5RM7.6
C3: 1uF; C_Disc_D5.0mm_W2.5mm_P2.50mm
C4: 0.1uF; C_Disc_D5.0mm_W2.5mm_P2.50mm
C7, C8, C9, C10, C12: 100nF; C_Disc_D5.0mm_W2.5mm_P2.50mm
C11: 100uF; CP_Radial_D6.3mm_P2.50mm
D2: Seg 1 Red; LED_D3.0mm
D3: Seg 1 Yellow; LED_D3.0mm
D4: Seg 1 Green; LED_D3.0mm
D5: Seg 2 Yellow; LED_D3.0mm
D6: Seg 2 Red; LED_D3.0mm
D7: Seg 2 Green; LED_D3.0mm
D8: Seg 3 Red; LED_D3.0mm
D9: Seg 3 Yellow; LED_D3.0mm
D10: Seg 3 Green; LED_D3.0mm
D11: Seg 4 Red; LED_D3.0mm
D12: Seg 4 Yellow; LED_D3.0mm
D13: Seg 4 Green; LED_D3.0mm
H1, H2, H3, H4: M3; MountingHole_3.2mm_M3
J3: J_5V_IN (from XL4015); TerminalBlock_Phoenix_MKDS-1,5-2-5.08_1x02_P5.08mm_Horizont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
J4: J_12V_IN (protected +12V); TerminalBlock_Phoenix_MKDS-1,5-2-5.08_1x02_P5.08mm_Horizont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
J5: J_CELL (cell + taps); TerminalBlock_Phoenix_MKDS-1,5-6-5.08_1x06_P5.08mm_Horizont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
J6: J_RLY_SEG (4-ch relay module); PinHeader_1x08_P2.54mm_Vertical
J7: J_RLY_PACK (1-ch relay module); PinHeader_1x04_P2.54mm_Vertical
J8: J_GATE (to off-board IRLZ44N); TerminalBlock_Phoenix_MKDS-1,5-4-5.08_1x04_P5.08mm_Horizont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
J9: J_I2C_EXT (INA219); PinHeader_1x04_P2.54mm_Vertical
JP1: Relay VCC: 1-2 +5V (default), 2-3 +3V3; SolderJumper-3_P1.3mm_Bridged12_RoundedPad1.0x1.5mm
JP2: MAX6675 SO: 1-2 SPI_MISO (default), 2-3 GPIO36; SolderJumper-3_P1.3mm_Bridged12_RoundedPad1.0x1.5mm
Q4: BC547; TO-92_Inline
R2, R3, R6, R7: 100k; R_Axial_DIN0207_L6.3mm_D2.5mm_P7.62mm_Horizontal
R4, R5: 10; R_Axial_DIN0207_L6.3mm_D2.5mm_P7.62mm_Horizontal
R9, R12, R14, R16: 100k 1%; R_Axial_DIN0207_L6.3mm_D2.5mm_P7.62mm_Horizontal
R10, R11, R13, R15: 20k 1%; R_Axial_DIN0207_L6.3mm_D2.5mm_P7.62mm_Horizontal
R17, R19, R21, R23, R25, R27, R29, R31: 15k; R_Axial_DIN0207_L6.3mm_D2.5mm_P7.62mm_Horizontal
R18, R20, R22, R24, R26, R28, R30, R32: 22k; R_Axial_DIN0207_L6.3mm_D2.5mm_P7.62mm_Horizontal
R33: 4.7 kΩ; R_Axial_DIN0207_L6.3mm_D2.5mm_P7.62mm_Horizontal
R34, R35: 4.7k; R_Axial_DIN0207_L6.3mm_D2.5mm_P7.62mm_Horizontal
R36, R37, R38, R39, R40, R41, R42, R43, R44, R45, R46, R47: 330; R_Axial_DIN0207_L6.3mm_D2.5mm_P7.62mm_Horizontal
R48: 1k; R_Axial_DIN0207_L6.3mm_D2.5mm_P7.62mm_Horizontal
R49, R50: 10k; R_Axial_DIN0207_L6.3mm_D2.5mm_P7.62mm_Horizontal
SW1: Acknowledge; SW_PUSH_6mm
SW2: Reset; SW_PUSH_6mm
U1: TC4427 (DIP-8); DIP-8_W7.62mm
U4: ADS1115 #1 0x48 (CO); PinSocket_1x10_P2.54mm_Vertical
U5: ADS1115 #2 0x49 (H2); PinSocket_1x10_P2.54mm_Vertical
U6: ADS1115 #3 0x4B (cells); PinSocket_1x10_P2.54mm_Vertical
U7: MQ-7 seg 1; JST_XH_B4B-XH-A_1x04_P2.50mm_Vertical
U8: MQ-7 seg 2; JST_XH_B4B-XH-A_1x04_P2.50mm_Vertical
U9: MQ-7 seg 3; JST_XH_B4B-XH-A_1x04_P2.50mm_Vertical
U10: MQ-7 seg 4; JST_XH_B4B-XH-A_1x04_P2.50mm_Vertical
U11: MQ-8 seg 1; JST_XH_B4B-XH-A_1x04_P2.50mm_Vertical
U12: MQ-8 seg 2; JST_XH_B4B-XH-A_1x04_P2.50mm_Vertical
U13: MQ-8 seg 3; JST_XH_B4B-XH-A_1x04_P2.50mm_Vertical
U14: MQ-8 seg 4; JST_XH_B4B-XH-A_1x04_P2.50mm_Vertical
U15: DS18B20 cell 1; JST_XH_B3B-XH-A_1x03_P2.50mm_Vertical
U16: DS18B20 cell 2; JST_XH_B3B-XH-A_1x03_P2.50mm_Vertical
U17: DS18B20 cell 3; JST_XH_B3B-XH-A_1x03_P2.50mm_Vertical
U18: DS18B20 cell 4; JST_XH_B3B-XH-A_1x03_P2.50mm_Vertical
U19: ESP32-DevKitC-32E; ESP32-DevKitC-32E_2x19_P2.54mm_W25.4mm
U20: OLED 0x3C; PinSocket_1x04_P2.54mm_Vertical
U21: DS3231 RTC 0x68; PinSocket_1x06_P2.54mm_Vertical
U22: BME280 0x76; PinSocket_1x04_P2.54mm_Vertical
U23: PCF8574 #1 0x20; PinSocket_1x13_P2.54mm_Vertical
U24: PCF8574 #2 0x21; PinSocket_1x13_P2.54mm_Vertical
U25: microSD; PinSocket_1x06_P2.54mm_Vertical
U26: MAX6675; PinSocket_1x05_P2.54mm_Vertical

Connections:
+3V3: J9.1, JP1.3, R33.2, R34.2, R35.2, R36.2, R37.2, R38.2, R39.2, R40.2, R41.2, R42.2, R43.2, R44.2, R45.2, R46.2, R47.2, R49.2, R50.2, U4.1 (VDD), U5.1 (VDD), U5.5 (ADDR), U6.1 (VDD), U15.1 (VDD), U16.1 (VDD), U17.1 (VDD), U18.1 (VDD), U19.1 (3V3), U20.2 (VCC), U21.5 (VCC), U22.1 (VIN), U23.1 (VCC), U24.1 (VCC), U26.4
+5V: BZ1.1 (+), C11.1, C12.1, J3.1, J6.6, J7.2, JP1.1, U7.1 (VCC), U8.1 (VCC), U9.1 (VCC), U10.1 (VCC), U11.1 (VCC), U12.1 (VCC), U13.1 (VCC), U14.1 (VCC), U19.19 (5V), U25.2 (VCC)
+12V: C3.2, C4.2, J4.1, U1.6 (V_{DD})
/MCU_IO/BTN_ACK: R49.1, SW1.1, U19.5 (IO34)
/MCU_IO/BTN_RST: R50.1, SW2.1, U19.6 (IO35)
/MCU_IO/BUZZER: R48.1, U19.15 (IO13)
/MCU_IO/SD_CS: U19.29 (IO5), U25.6 (CS)
/MCU_IO/SPI_MISO: JP2.1, U19.27 (IO19), U25.3 (MISO)
/MCU_IO/SPI_MOSI: U19.21 (IO23), U25.4 (MOSI)
/MCU_IO/SPI_SCK: U19.28 (IO18), U25.5 (SCK), U26.3
/MCU_IO/TC_CS: U19.12 (IO14), U26.2
/MCU_IO/TC_SO: JP2.2, U26.1
/MCU_IO/TC_SO_ALT: JP2.3, U19.3 (IO36/VP)
/Measurement/GAS1_CO: R17.2, R18.1, U4.7 (A0)
/Measurement/GAS1_H2: R25.2, R26.1, U5.7 (A0)
/Measurement/GAS2_CO: R19.2, R20.1, U4.8 (A1)
/Measurement/GAS2_H2: R29.2, R30.1, U5.8 (A1)
/Measurement/GAS3_CO: R21.2, R22.1, U4.9 (A2)
/Measurement/GAS3_H2: R27.2, R28.1, U5.9 (A2)
/Measurement/GAS4_CO: R23.2, R24.1, U4.10 (A3)
/Measurement/GAS4_H2: R31.2, R32.1, U5.10 (A3)
/Measurement/VSENS1: C7.1, R9.2, R10.1, U6.7 (A0)
/Measurement/VSENS2: C8.1, R11.1, R12.2, U6.8 (A1)
/Measurement/VSENS3: C9.1, R13.1, R14.2, U6.9 (A2)
/Measurement/VSENS4: C10.1, R15.1, R16.2, U6.10 (A3)
CELL1_P: J5.1, R9.1
CELL2_P: J5.2, R12.1
CELL3_P: J5.3, R14.1
CELL4_P: J5.4, R16.1
GATE_HTR: J8.1, R4.2, R6.1
GATE_LOAD: J8.2, R5.2, R7.1
GND: C3.1, C4.1, C7.2, C8.2, C9.2, C10.2, C11.2, C12.2, J3.2, J4.2, J5.5, J5.6, J6.7, J6.8, J7.3, J7.4, J8.3, J8.4, J9.2, Q4.3 (E), R2.2, R3.2, R6.2, R7.2, R10.2, R11.2, R13.2, R15.2, R18.2, R20.2, R22.2, R24.2, R26.2, R28.2, R30.2, R32.2, SW1.2, SW2.2, U1.3 (GND), U4.2 (GND), U4.5 (ADDR), U5.2 (GND), U6.2 (GND), U7.2 (GND), U8.2 (GND), U9.2 (GND), U10.2 (GND), U11.2 (GND), U12.2 (GND), U13.2 (GND), U14.2 (GND), U15.3 (GND), U16.3 (GND), U17.3 (GND), U18.3 (GND), U19.14 (GND), U19.20 (GND), U19.26 (GND), U20.1 (GND), U21.6 (GND), U22.2 (GND), U23.2 (GND), U24.2 (GND), U25.1 (GND), U26.5
HTR_EN: R2.1, U1.2 (IN_A), U19.31 (IO16)
LOAD_EN: R3.1, U1.4 (IN_B), U19.30 (IO17)
unnamed: BZ1.2 (-), Q4.1 (C)
unnamed: D2.2 (A), R36.1
unnamed: D2.1 (K), U23.6 (P0)
unnamed: D3.2 (A), R37.1
unnamed: D3.1 (K), U23.7 (P1)
unnamed: D4.2 (A), R38.1
unnamed: D4.1 (K), U23.8 (P2)
unnamed: D5.2 (A), R39.1
unnamed: D5.1 (K), U23.10 (P4)
unnamed: D6.2 (A), R40.1
unnamed: D6.1 (K), U23.9 (P3)
unnamed: D7.2 (A), R41.1
unnamed: D7.1 (K), U23.11 (P5)
unnamed: D8.2 (A), R42.1
unnamed: D8.1 (K), U24.6 (P0)
unnamed: D9.2 (A), R43.1
unnamed: D9.1 (K), U24.7 (P1)
unnamed: D10.2 (A), R44.1
unnamed: D10.1 (K), U24.8 (P2)
unnamed: D11.2 (A), R45.1
unnamed: D11.1 (K), U24.9 (P3)
unnamed: D12.2 (A), R46.1
unnamed: D12.1 (K), U24.10 (P4)
unnamed: D13.2 (A), R47.1
unnamed: D13.1 (K), U24.11 (P5)
unnamed: Q4.2 (B), R48.2
unnamed: R4.1, U1.7 (OUT_A)
unnamed: R5.1, U1.5 (OUT_B)
unnamed: R17.1, U7.4 (AO)
unnamed: R19.1, U8.4 (AO)
unnamed: R21.1, U9.4 (AO)
unnamed: R23.1, U10.4 (AO)
unnamed: R25.1, U11.4 (AO)
unnamed: R29.1, U12.4 (AO)
unnamed: R27.1, U13.4 (AO)
unnamed: R31.1, U14.4 (AO)
ONEWIRE: R33.1, U15.2 (DQ), U16.2 (DQ), U17.2 (DQ), U18.2 (DQ), U19.32 (IO4)
RLY_PACK: J7.1, U19.8 (IO33)
RLY_SEG1: J6.1, U19.9 (IO25)
RLY_SEG2: J6.2, U19.10 (IO26)
RLY_SEG3: J6.3, U19.11 (IO27)
RLY_SEG4: J6.4, U19.7 (IO32)
RLY_VCC: J6.5, JP1.2
SCL: J9.4, R35.1, U4.3 (SCL), U5.3 (SCL), U6.3 (SCL), U6.5 (ADDR), U19.22 (IO22), U20.3 (SCL), U21.3 (SCL), U22.3 (SCL), U23.4 (SCL), U24.4 (SCL)
SDA: J9.3, R34.1, U4.4 (SDA), U5.4 (SDA), U6.4 (SDA), U19.25 (IO21), U20.4 (SDA), U21.4 (SDA), U22.4 (SDA), U23.3 (SDA), U24.3 (SDA)
