Aryan-swag/VentSense/(commit log)

2026-10-24 VentSense Stage 2: KiCad schematic, ERC report and BOM
    Hierarchical KiCad 10 schematic (Power, Pack_Path, Measurement, MCU_IO),
    project module-symbol library, schematic PDF and per-sheet PNGs, ERC report
    (0 errors, 0 warnings), KiCad BOM CSV and the Rev 2.1 bill of materials.
    [MCU_IO.kicad_sch, Measurement.kicad_sch, Pack_Path.kicad_sch, Power.kicad_sch, VS_kicad_bom.csv, VentSense_BOM_Rev2.1.xlsx, VentSense_Stage2.kicad_sch]
2026-10-24 Update title blocks, remove working notes, refresh exports
    Title blocks on all five sheets now point to the BOM instead of internal
    files; working notes boxes removed from the sheets. PDF, per-sheet PNGs,
    ERC report (0 violations) and BOM CSV re-exported to match.
    [MCU_IO.kicad_sch, Measurement.kicad_sch, Pack_Path.kicad_sch, Power.kicad_sch, VentSense_Stage2.kicad_sch]
2026-10-24 feat(pcb): add 2-layer carrier PCB layout, 0-error DRC logs, and production Gerbers v1.0 (VK26-IITH-SE-0279)
    [VentSense_Stage2-B_Cu.gbl, VentSense_Stage2-B_Mask.gbs, VentSense_Stage2-B_Silkscreen.gbo, VentSense_Stage2-Edge_Cuts.gm1, VentSense_Stage2-F_Cu.gtl, VentSense_Stage2-F_Mask.gts, VentSense_Stage2-F_Silkscreen.gto, VentSense_Stage2-NPTH.drl]
2026-10-25 cad and simulation files added
    [Assem2.SLDASM, Assem3.SLDASM, Part1.SLDPRT, Part2.SLDPRT, Ventsense_full_assembly_final.SLDASM, ventsense_PCM_Sleeve.SLDPRT, ventsense_PTEG_carrier.SLDPRT, ventsense_cell_assembly.SLDASM]
2026-10-25 docs(cad): add KiCad schematic, PCB layout, DRC log, and 3D render screenshots (VK26-IITH-SE-0279)
2026-10-25 chore(bom): update BOM to Rev2.1 Final
    [VentSense_BOM_Rev2.1.xlsx, VentSense_BOM_Rev2.1_Final.xlsx]
2026-11-10 kicad: v1.1 carrier board (connectors sheet, relay/MAX6675 jumpers, rerouted PCB)
    Adds Connectors sheet (J3-J9, JP1, C11/C12), JP2 MAX6675 SO jumper,
    off-board flags, net classes, and the rerouted 124x126 mm board.
    ERC 0/0, DRC 0 violations / 0 unconnected / 0 parity (default checks).
    [Connectors.kicad_sch, MCU_IO.kicad_sch, Measurement.kicad_sch, Pack_Path.kicad_sch, Power.kicad_sch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]
2026-11-10 hardware: v1.1 Gerbers, drills, reports, renders; archive v1.0
    [VS_BOM_v1.1_all.csv, VS_Carrier_BOM_v1.1.csv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]
2026-11-10 docs: README reflects v1.1 board and accurate check results
2026-11-10 pcb v1.1: fix tactile switch footprint (4-pin SW_PUSH_6mm), regenerate fab outputs
    The custom 2-pad switch footprint put two internally-connected legs of a
    6x6 tactile switch in its holes (button would read permanently pressed).
    Replaced with KiCad Button_Switch_THT:SW_PUSH_6mm; button nets re-routed.
    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
    [MCU_IO.kicad_sch, VS_BOM_v1.1_all.csv, VS_Carrier_BOM_v1.1.csv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]
2026-11-10 PCB: dedicated PCB/ folder with fab files, BOM, docs, renders and ordering guide
    Moves the v1.1 Gerbers/drills/zip, carrier BOM, ERC/DRC reports, schematic
    PDF and renders from hardware/pcb_production/ into PCB/, adds PCB/README.md
    and PCB/ORDERING.md (fab options, viewer checklist, assembly notes), and
    points the main README at it. v1.0 outputs kept in PCB/archive_v1.0/.
    [VS_BOM_v1.1_all.csv, VS_Carrier_BOM_v1.1.csv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]
2026-11-11 schematic: relay modules active-HIGH (H trigger), add off-board gate pull-downs R51/R52
    - Relay module descriptions: trigger jumper H, IN = 3.3 V energises (fail-secure
    on boot, crash and 3V3 loss). Firmware drives HIGH to connect a cell.
    - R51/R52 100k gate-source resistors on the off-board IRLZ44Ns (Power sheet,
    on_board no). PCB and Gerbers unchanged.
    - ERC 0/0, DRC 0 violations / 0 unconnected / 0 parity. Docs, BOM, ordering
    guide updated.
    [Pack_Path.kicad_sch, Power.kicad_sch, VS_BOM_v1.1_all.csv]
2026-11-11 firmware + digital twin: safety core, ESP32 skeleton, unit tests, SIL simulation
    - firmware/: PlatformIO project. Hardware-free safety core (2-of-3 voting, latching,
    smart gas/temperature/voltage signals, sensor faults, relay verification, heater
    limits); 22/22 native unit tests pass. ESP32 skeleton (safety task + watchdog on
    core 1, Wi-Fi AP + JSON API on core 0, mock sensors) compiles.
    - sim/: digital twin with the real safety core loaded via ctypes; 8 scenarios
    (29/29 checks), Monte Carlo 0/40 false trips, 40/40 isolations, 0.6 s latency.
    Model values are ASSUMED and tagged.
    - firmware/FEATURES.md: agreed smart-feature plan.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
2026-11-11 firmware: real sensor drivers, power-up self-test, LEDs/OLED, SD logging, calibration
    - hal_real.cpp: ADS1115 x3 (gas + taps, +-4.096 V), DS18B20 x4 non-blocking with
    probe-to-cell mapping stored in NVS (arming requires a confirmed mapping), INA219,
    BME280, DS3231, SSD1306 status page, PCF8574 status LEDs, MAX6675 (SPI or IO36
    bit-bang via JP2), microSD 1 Hz data + event log, two-point tap calibration.
    - Self-test (P1.8): arming needs 3x ADS1115, INA219, 4 mapped DS18B20; others warn.
    - I2C and 1-Wire guarded by mutexes; safety task owns sensor reads.
    - min_spiffs partitions; esp32dev 61.6 % flash, esp32dev_mock 53.4 %. Not yet run on
    hardware: BRINGUP.md lists the steps and VERIFY i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
2026-11-11 firmware: all P1/P2 smart features + Wi-Fi dashboard, tested against the digital twin
    - Pure, unit-tested modules (39/39 tests): internal-resistance test (DCIR at 1 s),
    charge/energy/state of charge, health indicator (advisory), power-up relay check,
    heater ramp, load profile, settings table with spec limits.
    - Safety core: undervoltage load cutoff (no BMS on the rig; found in the twin).
    - ESP32 integration: relay check before arming, IR test + baseline in flash,
    settings in NVS, 10-min history, event log, incident files on SD, admin password,
    firmware update over Wi-Fi, optional network time + ntfy phone alerts, test modes.
    - Dashboard (web/index.html, embedded gzipped, no external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
